475241512/BT_Printer/FW/release/升级说明.txt

合杰热敏小票打印机终端（U系列、B系列）升级方式说明：

1.终端在开机之前先将USB数据线插入电脑主机，然后按住进纸键，再开机；

2.此时打印机终端的蓝色灯会闪烁,带屏幕的版本会在屏幕上显示“UDisk Mode”的字样，电脑主机应该会提示发现新的USB设备，等待系统安装驱动；

3.驱动安装成功之后，会在系统的资源管理界面看到一个容量大约为2M的类似U盘的存储设备，将升级固件包里面的update.bin文件拷贝到终端盘符对应盘符的根目录下;

4.拷贝完成后，安全退出u盘模式，然后将打印机终端关机再开机，此时蓝灯会快速闪烁，直到蓝灯熄灭表示升级成功，带屏幕的版本会在屏幕上显示升级状态以及升级结果，然后进入正常的打印机工作状态。
