475241512/BT_Printer/资料/打印机固件升级/打印机固件升级/打印机固件升级说明书.docx

下载好升级文件之后,需要全部文件解压出来,解压出来如图所示

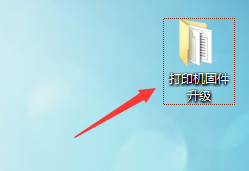
[picture p1: figure]

打开文件夹,看到所有文件,然后双击打开这个程序,认准图片即可.

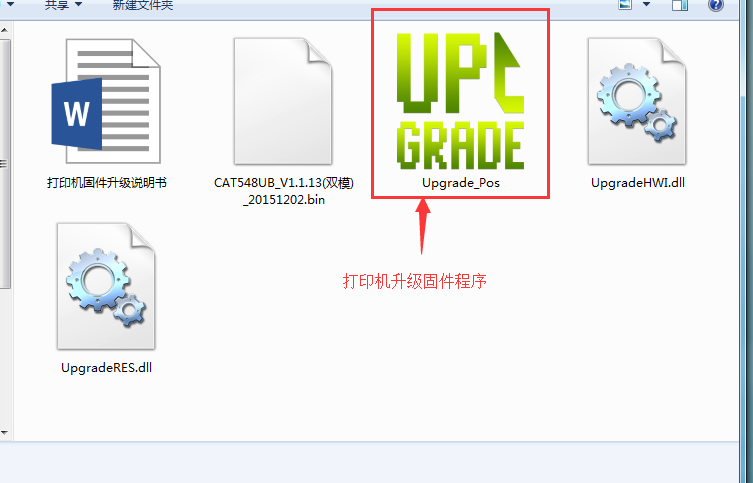
[picture p2: figure]

现在打印机连接电脑,数据线也要接上去,打印机通电开机.电脑上面在这个程序双击打开,点击升级固件程序

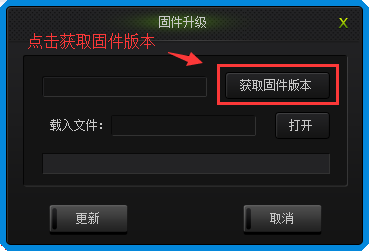
[picture p3: figure]

(获取失败的话,等一会电脑自动识别安装好驱动即可)

获取之后点击打开载入文件:

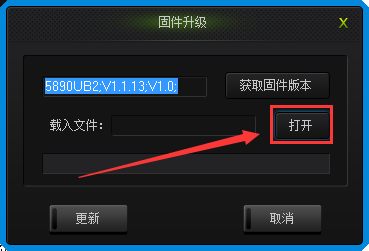
[picture p4: figure]

选择对应的升级文件.

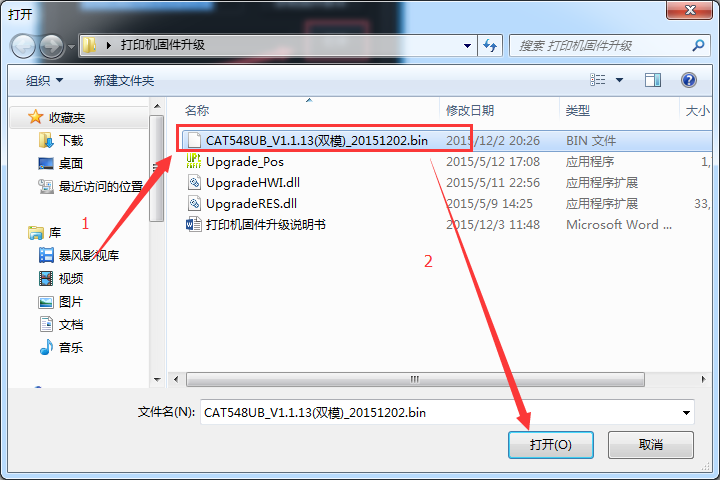
[picture p5: figure]

打开之后,直接点击跟新,程序会有读条,读条结束即可完成升级.最后还有一部很重要的,要看.

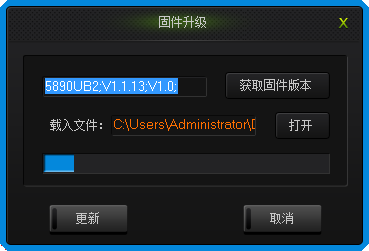
[picture p6: figure]
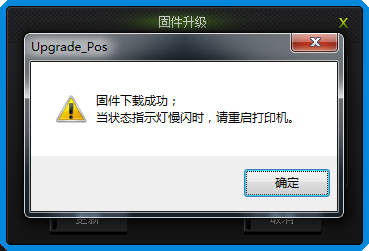
[picture p7: figure]

按照程序提示重启打印机,还需要这一步:

打印机把打印纸拿出来,盖上打印机盖子,打印机通电的情况下按住FEED键8秒,(按下去STATUS指示灯不会显示),指示灯显示了之后即可开机连接打印.
