475241512/BT_Printer/资料/蓝牙模块/FSC-BT816/固件空中升级手册3.0.pdf

# 固件升级用户手册

V3.0

# Android DFU via Bluetooth

1.确保安卓手机已安装了“蓝牙串口”软件，且为最新版本。

蓝牙串口 APK 图标，可自行到 APP 应用商店下载。

2.开启蓝牙后打开该软件，并且连接需要升级的设备

3.连接成功后发送字符串：EnterDFU （注意大小写），收到 OK 表

示模块成功进入升级模式,此时连接自动断开

注：模块只识别连接成功后的首帧数据是否为 DFU 指令，若之前有收到其他数据，则模块 不识别。

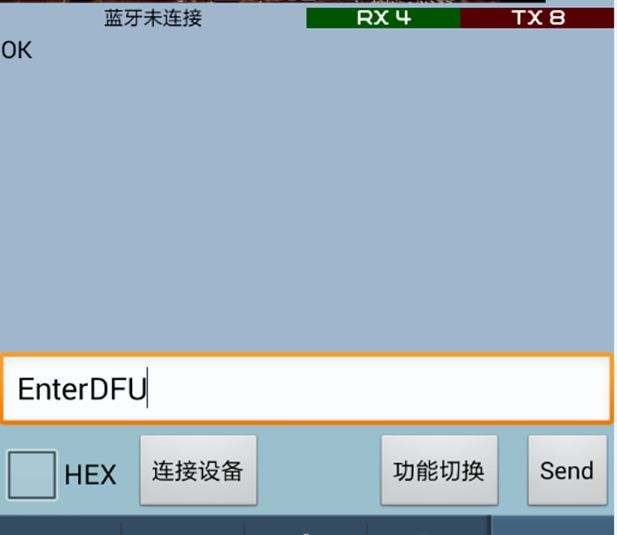
[picture p8: figure]

4.重新连接设备，此时会持续收到字符 C，表示模块等待升级文件

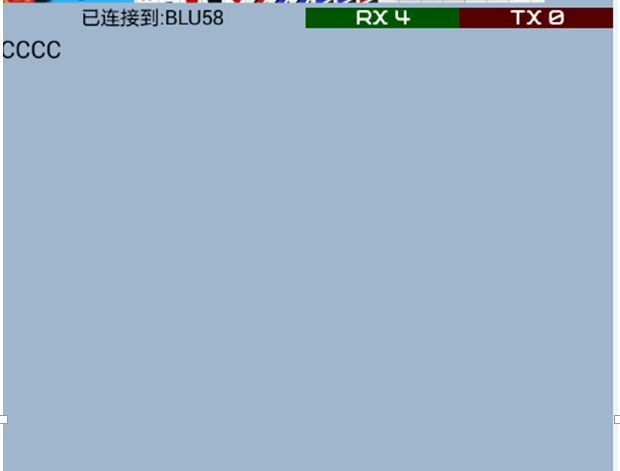
[picture p9: figure]

5.点击“功能切换”或 Menu 菜单中的“模式切换”键，切换到如下

界面

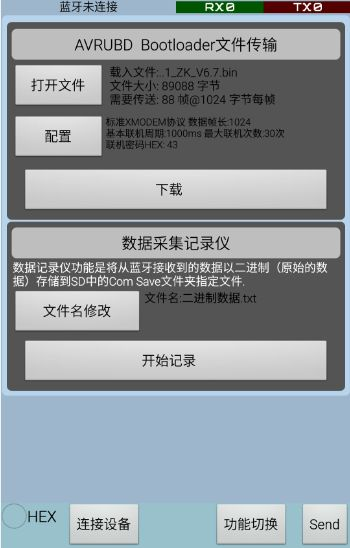
[picture p10: figure]

图 1.DFU

6.点击“打开文件”，找到存入手机的升级所用的固件*.bin

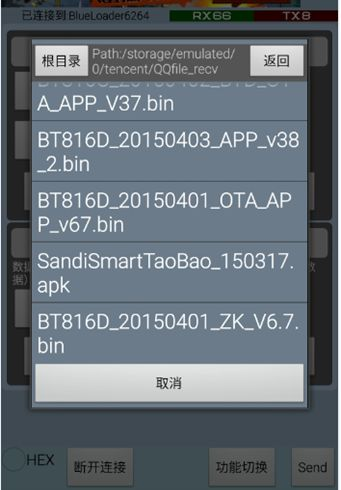
[picture p11: figure]

7.点击“配置”，配置 DFU 参数

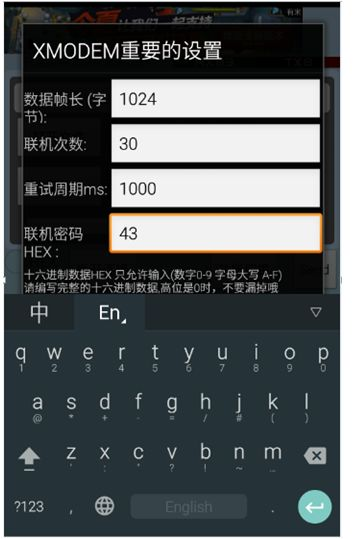
[picture p12: figure]

8.点击“下载”，开始 DFU

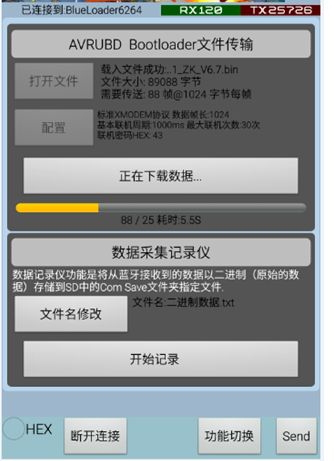
[picture p13: figure]

9.DFU 完成

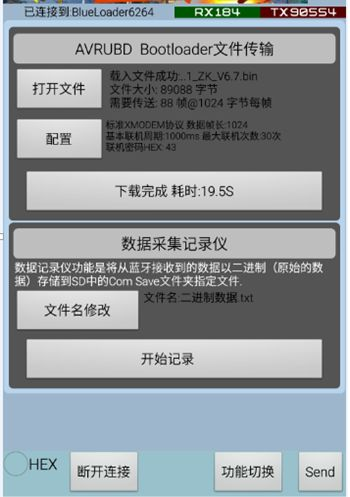
[picture p14: figure]
