475241512/BT_Printer/HW/BTPrinter_V1.20 PCBA BOM.xlsx

Part Report (BaseOption) for BTPrinter_V1.20.pcb on 2016/1/4 15:13:09
Index | Value | Decal | QTY | Name
Chips |  |  | 7
1 | AMS1117-3.3 | SOT223-JL | 1 | U4
2 | AP4435GM场效应管 SOP8 | SOP8 | 1 | U3
3 | DRV8833PWPR 电机驱动IC 16-HTSSOP | DRV8833 | 1 | U8
4 | HEM6448-01D-C-01 LCD显示屏 | HEM6448-33PIN | 1 | U5
5 | MX25L6445EM2-10G SPI FLASH | SO-8-320MIL | 1 | U22
6 | STM32F103CBT6/GD32F103CBT6 | LQFP-48 | 1 | U2
7 | TPS54331DR DC/DC电源IC 3A SOP8 | SO-8-320MIL | 1 | U1
Resisters |  |  | 40
8 | 0R | R0402 | 2 | R11 R36
9 | 1R2 | 0805 | 4 | R30 R31 R32 R33
10 | 100R | R0402 | 1 | R35
11 | 180R | R0402 | 1 | R3
12 | 330R | R0402 | 2 | R23 R46
13 | 1K | R0402 | 3 | R13 R22 R45
14 | 1.5K | R0402 | 1 | R47
15 | 3.3K | R0402 | 1 | R43
16 | 10K | R0402 | 14 | R1 R2 R6 R7 R14 R15 R25 R27 R28 R29 R34 R40 R42 R44
17 | 22K | R0402 | 1 | R5
18 | 30K | R0402 | 1 | R8
19 | 47K | R0402 | 3 | R9 R18 R24
20 | 51K | R0402 | 1 | R38
21 | 56.2K | R0402 | 1 | R39
22 | 330K | R0402 | 1 | R37
23 | 1M | R0402 | 2 | R4 R26
24 | 1K +/-1% | R0402 | 1 | R41
Capacitors |  |  | 36
25 | 20p | C0402 | 2 | C4 C8
26 | 47pF | C0402 | 1 | C38
27 | 1000pF | C0402 | 1 | C37
28 | 0.01uF | C0402 | 3 | C10 C34 C35
29 | 0.1uF | C0402 | 14 | C3 C5 C6 C7 C15 C16 C17 C18 C23 C29 C30 C33 C36 C42
30 | 1uF | C0402 | 2 | C2 C12
31 | 2.2uF | C0402 | 1 | C28
32 | 4.7uF | C0402 | 1 | C1
33 | 4.7uF | C0603 | 2 | C9 C26
34 | 10uF | C0402 | 1 | C31
35 | 10uF | C0805 | 3 | C13 C20 C32
36 | 10uF/16V | C0805 | 1 | C14
37 | 22uF/10V | C0805 | 1 | C40
38 | 电解电容25V/100uF 直径6.3MM | C_DIANJIE_6.3MM | 1 | C39
39 | 电解电容25V/470uF 直径8MM | C_DIANJIE_8MM | 1 | C11
40 | 电解电容35V/1000uF 直径10MM | C_DIANJIE_10MM | 1 | C41
Inductors |  |  | 1
41 | 6.8uH | L_DIP | 1 | L1
Diodes |  |  | 5
42 | 1N4001(SOD323) | SOD323 | 1 | D3
43 | 1N5822 DO-2144AA | DO-214AA | 1 | D2
44 | BAT54S SOT23 肖特基二极管 | SOT-23-3 | 1 | D1
Triodes |  |  | 5
45 | 2N7002 | SOT23 | 1 | Q7
46 | 3904 | SOT23 | 2 | Q2 Q9
47 | IR6402 | SOT23 | 1 | Q1
48 | TIP127(TO252) | TO252 | 1 | Q3
Crystals |  |  | 1
49 | 12MHZ 贴片晶振 | HSX321S-1 | 1 | Y1
Connectors |  |  | 5
50 | 2.0Pitch 双列直插打印头FPC座子 | 30PIN_DOUBLE_SMD | 1 | J8
51 | 2PIN电源插座 | SIP-2P | 1 | J2
52 | USB TYPEB 母座 | STANDARD_TYPEB | 1 | J3
53 | RJ12水晶头母座 | RJ12 | 1 | J5
Switchs |  |  | 2
54 | 电源开关 | POWER_KEY | 1 | S1
55 | 轻触开关 | 12_12MMKEY | 1 | S2
Unkowns |  |  | 5
56 | 蓝牙模块FSC-BT816 | WBTDS01 | 1 | BT1
Design Part Count: 103
