475241512/BT_Printer/HW/BTPrinter_V1.0_PCBA_BOM.xlsx

Part Report (BaseOption) for BTPrinter_DemoBoard_V1.00.pcb on 2015/11/10 15:04:08
Index | Value | Decal | QTY | Name
Chips |  |  | 7
1 | AMS1117-3.3 | SOT223-JL | 1 | U4
2 | AP4435GM场效应管 SOP8 | SOP8 | 1 | U3
3 | DRV8833PWPR 电机驱动IC 16-HTSSOP | DRV8833 | 1 | U8
4 | HEM6448-01D-C-01 LCD显示屏 | HEM6448-33PIN | 1 | U5
5 | MX25L6445EM2-10G SPI FLASH | SO-8-320MIL | 1 | U22
6 | STM32F103VE/VD | LQFP100 | 1 | U2
7 | TPS54331DR DC/DC电源IC 3A SOP8 | SO-8-320MIL | 1 | U1
Resisters |  |  | 38
8 | 0R | R0402 | 1 | R36
9 | 1R2 | 0805 | 4 | R30 R31 R32 R33
10 | 100R | R0402 | 1 | R35
11 | 180R | R0402 | 1 | R3
12 | 330R | R0402 | 2 | R23 R46
13 | 1K | R0402 | 2 | R22 R45
14 | 1.5K | R0402 | 1 | R47
15 | 10K | R0402 | 16 | R1 R2 R6 R7 R10 R12 R15 R19 R25 R27 R28 R29 R34 R40 R42 R43
16 | 22K | R0402 | 1 | R5
17 | 47K | R0402 | 4 | R9 R18 R24 R44
18 | 51K | R0402 | 1 | R38
19 | 56.2K | R0402 | 1 | R39
20 | 330K | R0402 | 1 | R37
21 | 1M | R0402 | 2 | R4 R26
Capacitors |  |  | 38
22 | 20p | C0402 | 2 | C4 C8
23 | 47pF | C0402 | 1 | C38
24 | 1000pF | C0402 | 1 | C37
25 | 0.01uF | C0402 | 3 | C10 C34 C35
26 | 0.1uF | C0402 | 13 | C3 C5 C6 C7 C15 C16 C17 C18 C19 C29 C30 C33 C36
27 | 1uF | C0402 | 5 | C2 C12 C22 C24 C27
28 | 2.2uF | C0402 | 1 | C28
29 | 4.7uF | C0402 | 4 | C1 C21 C23 C25
30 | 4.7uF | C0603 | 2 | C9 C26
31 | 10uF | C0402 | 1 | C31
32 | 10uF | C0805 | 3 | C13 C20 C32
33 | 10uF/16V | C0805 | 1 | C14
34 | 22uF/10V | C0805 | 1 | C40
Inductors |  |  | 1
35 | 6.8uH | L_DIP | 1 | L1
Diodes |  |  | 4
36 | 1N5822 | D0603A | 1 | D2
37 | BAT54S SOT23 肖特基二极管 | SOT-23-3 | 1 | D1
38 | 插件红色LED | LED(A/C) | 1 | LED_RED
39 | 插件蓝色LED | LED(A/C) | 1 | LED_BLUE
Triodes |  |  | 6
40 | 2N7002 | SOT23 | 1 | Q7
41 | 3904 | SOT23 | 2 | Q2 Q9
42 | IR6402 | SOT23 | 2 | Q1 Q8
43 | TP12 | TESTPOINT | 1 | Q10
Crystals |  |  | 1
44 | 12MHZ 贴片晶振 | HSX321S-1 | 1 | Y1
Connectors |  |  | 8
45 | 2.0Pitch 双列直插打印头FPC座子 | FPC-30_PITCH_1MM | 1 | J8
46 | 2.54pitch单排插针 | SIP-4P | 3 | J4 J6 J7
47 | 2.54pitch单排插针 | SIP-5P | 1 | J1
48 | 2PIN电源插座 | SIP-2P | 1 | J2
49 | RJ12水晶头母座 | RJ12 | 1 | J5
50 | USB TYPE B 母座 | STANDARD_TYPEB | 1 | J3
Switchs |  |  | 2
51 | 电源开关 | POWER_KEY | 1 | S1
52 | 轻触开关 | 12_12MMKEY | 1 | S2
Unkowns |  |  | 8
53 | 1K +/-1% | R0402 | 1 | R41
54 | 25V/100uF | C_DIANJIE | 1 | C39
55 | 25V/470uF | C_DIANJIE | 1 | C11
56 | 25V/1000uF | C_DIANJIE | 1 | C41
57 | 蓝牙模块FSC-BT816 | WBTDS01 | 4 | BT1 BT2 BT3 BT4
Design Part Count: 113
