475241512/BT_Printer/结构/outline1.dxf

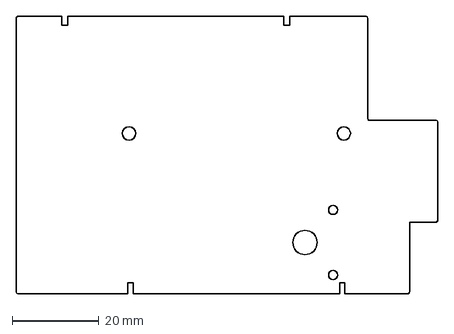
[picture p15: CAD file, 2015-12-18]
结构/outline1.dxf
97.2 x 64.0 mm
