475241512/BT_Printer/结构/POS58主板板框图-151106/layout.dxf

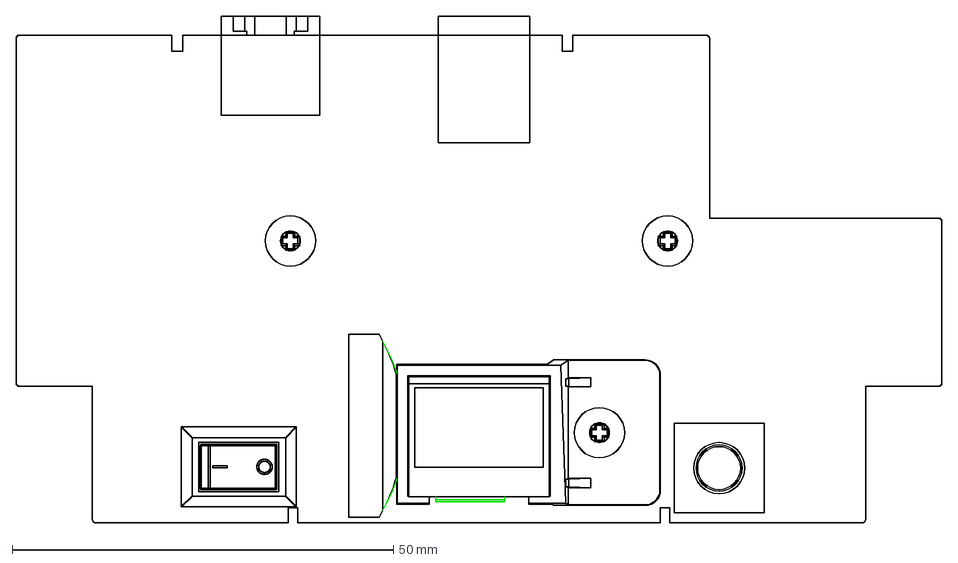
[picture p17: CAD file, 2015-12-14]
结构/POS58主板板框图-151106/layout.dxf
121.5 x 66.5 mm
