475241512/BT_Printer/(list of files, cad)

Other CAD files:
结构/POS58主板板框图-151106/POS58-main-board-A-151106.dwg
结构/POS58-printer-main-board-151215.dwg
结构/POS58主板板框图-151106/POS58-main-board-B-151106.dwg
结构/POS58主板板框图-151106/POS58-main-board-151106.dwg
结构/小票打印机-主板初步板框图-151009.dwg
结构/POS58主板板框图-151106/layout.dwg
