475241512/BT_Printer/资料/NUC123_USB_Printer_V1.01.00/NUC123_USB_Printer_V1.01.00/Printer 驱动和字库等资料/烧录字库使用说明.txt

 按以下步骤，把汉字库烧录到 SPI FLASH中，供NUC123读取。

一,NUC123中烧录代码 Writing_HZK.bin。

二,电脑上打开工具软件 Writing_HZK.exe，板子串口连上电脑。

三,按操作步骤,先打开16X16字库,点"开始"下载字库到 SPI SLASH,再打开24X24字库,点"开始"。

  以上步骤完成字库下载到 SPI FLASH, NUC123再烧录打印机的代码。就可以打印出汉字了。
