475241512/BT_Printer/资料/打印机固件升级/打印机固件升级/BT_Printer_enum.txt

Bus Hound 5.00 capture. Complements of www.perisoft.net

  Device - Device ID (followed by the endpoint for USB devices)
            (16) USB Composite Device
            (17) USB 打印支持
            (18) USB 输入设备
            (19) 没有连接打印机
            (20) HID-compliant device
  Phase  - Phase Type
            CTL   USB control transfer       
            DI    Data in                    
            DO    Data out                   
            USTS  USB status                 
  Data   - Hex dump of the data transferred
  Descr  - Description of the phase
  Cmd... - Position in the captured data

Device  Phase  Data                                                                                                    Description       Cmd.Phase.Ofs(rep)
------  -----  ------------------------------------------------------------------------------------------------------  ----------------  ------------------
  17.0  CTL    00 09 00 00  00 00 00 00                                                                                SET CONFIG               1.1.0        
  16.0  CTL    80 06 00 01  00 00 12 00                                                                                GET DESCRIPTOR           2.1.0        
  16.0  DI     12 01 00 02  00 00 00 40  00 b0 11 04  00 02 01 02  00 01                                               .......@........         2.2.0        
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
  17.0  USTS   00 00 01 c0                                                                                             canceled                13.2.0
