475241512/BT_Printer/资料/打印机固件升级/打印机固件升级/BT_Printer_Upgrade.txt

Bus Hound 5.00 capture. Complements of www.perisoft.net

  Device - Device ID (followed by the endpoint for USB devices)
            (19) 没有连接打印机
            (20) HID-compliant device
  Phase  - Phase Type
            DI    Data in                    
            DO    Data out                   
  Data   - Hex dump of the data transferred
  Descr  - Description of the phase
  Cmd... - Position in the captured data

Device  Phase  Data                                                                                                    Description       Cmd.Phase.Ofs(rep)
------  -----  ------------------------------------------------------------------------------------------------------  ----------------  ------------------
  20    DO     00 00 f9 00  00 00 00 00  00 00 00 00  00 00 00 00  00 00 00 00  00 00 00 00  00 00 00 00  00 00 00 00  ................         1.1.0        
               00 00 00 00  00 00 00 00  00 00 00 00  00 00 00 00  00 00 00 00  00 00 00 00  00 00 00 00  00 00 00 00  ................         1.1.32       
               00                                                                                                      .                        1.1.64       
  20    DI     00 00 f9 35  38 39 30 55  42 34 3b 56  32 2e 32 2e  36 3b 56 31  2e 31 3b 00  00 00 00 00  00 00 00 00  ...5890UB4;V2.2.         2.1.0        
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
               00                                                                                                      .                      821.1.64
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
