475241512/BT_Printer/结构/POS58-printer-main-board-151215.pdf

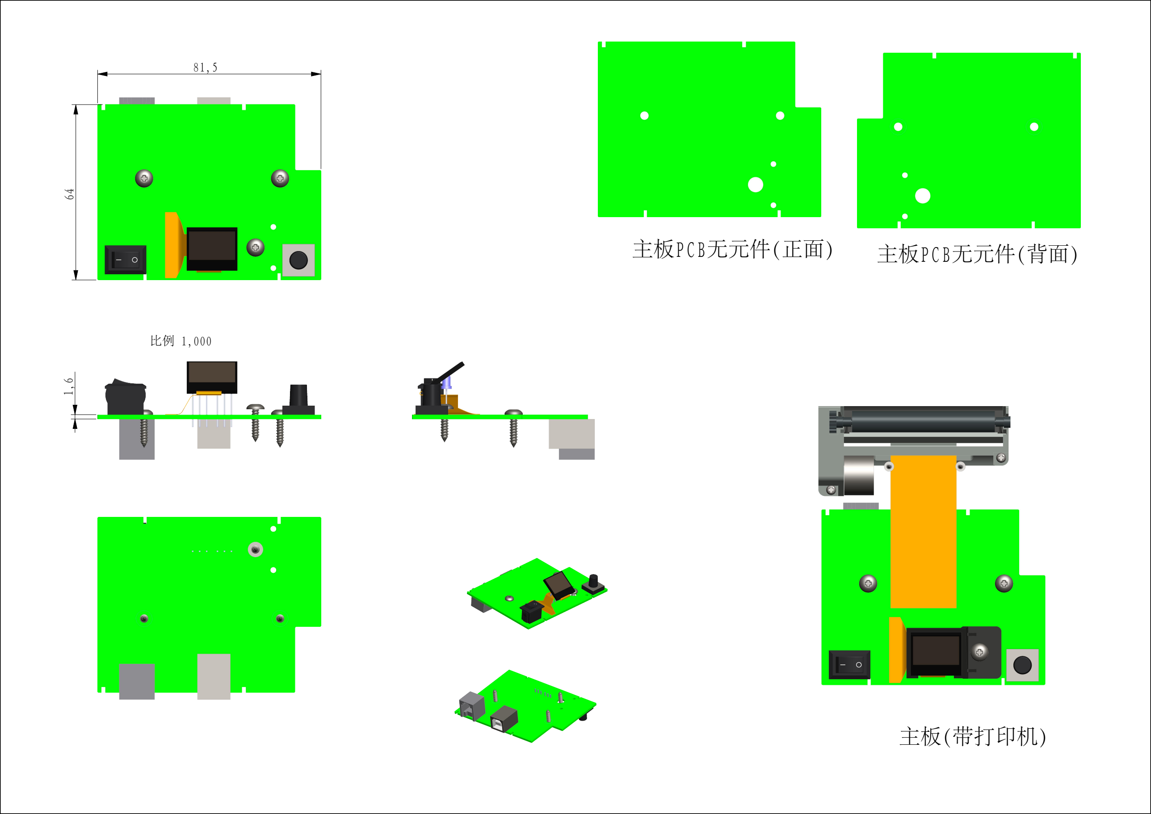
[picture p23: page 1]

81,5

64 1,6

主板PCB无元件(正面)

主板(带打印机)

主板PCB无元件(背面)

比例 1,000
