475241512/BT_Printer/资料/NUC123_USB_Printer_V1.01.00/NUC123_USB_Printer_V1.01.00/Printer 驱动和字库等资料/nuc123_lqfp64 micro-printer 58m.pdf

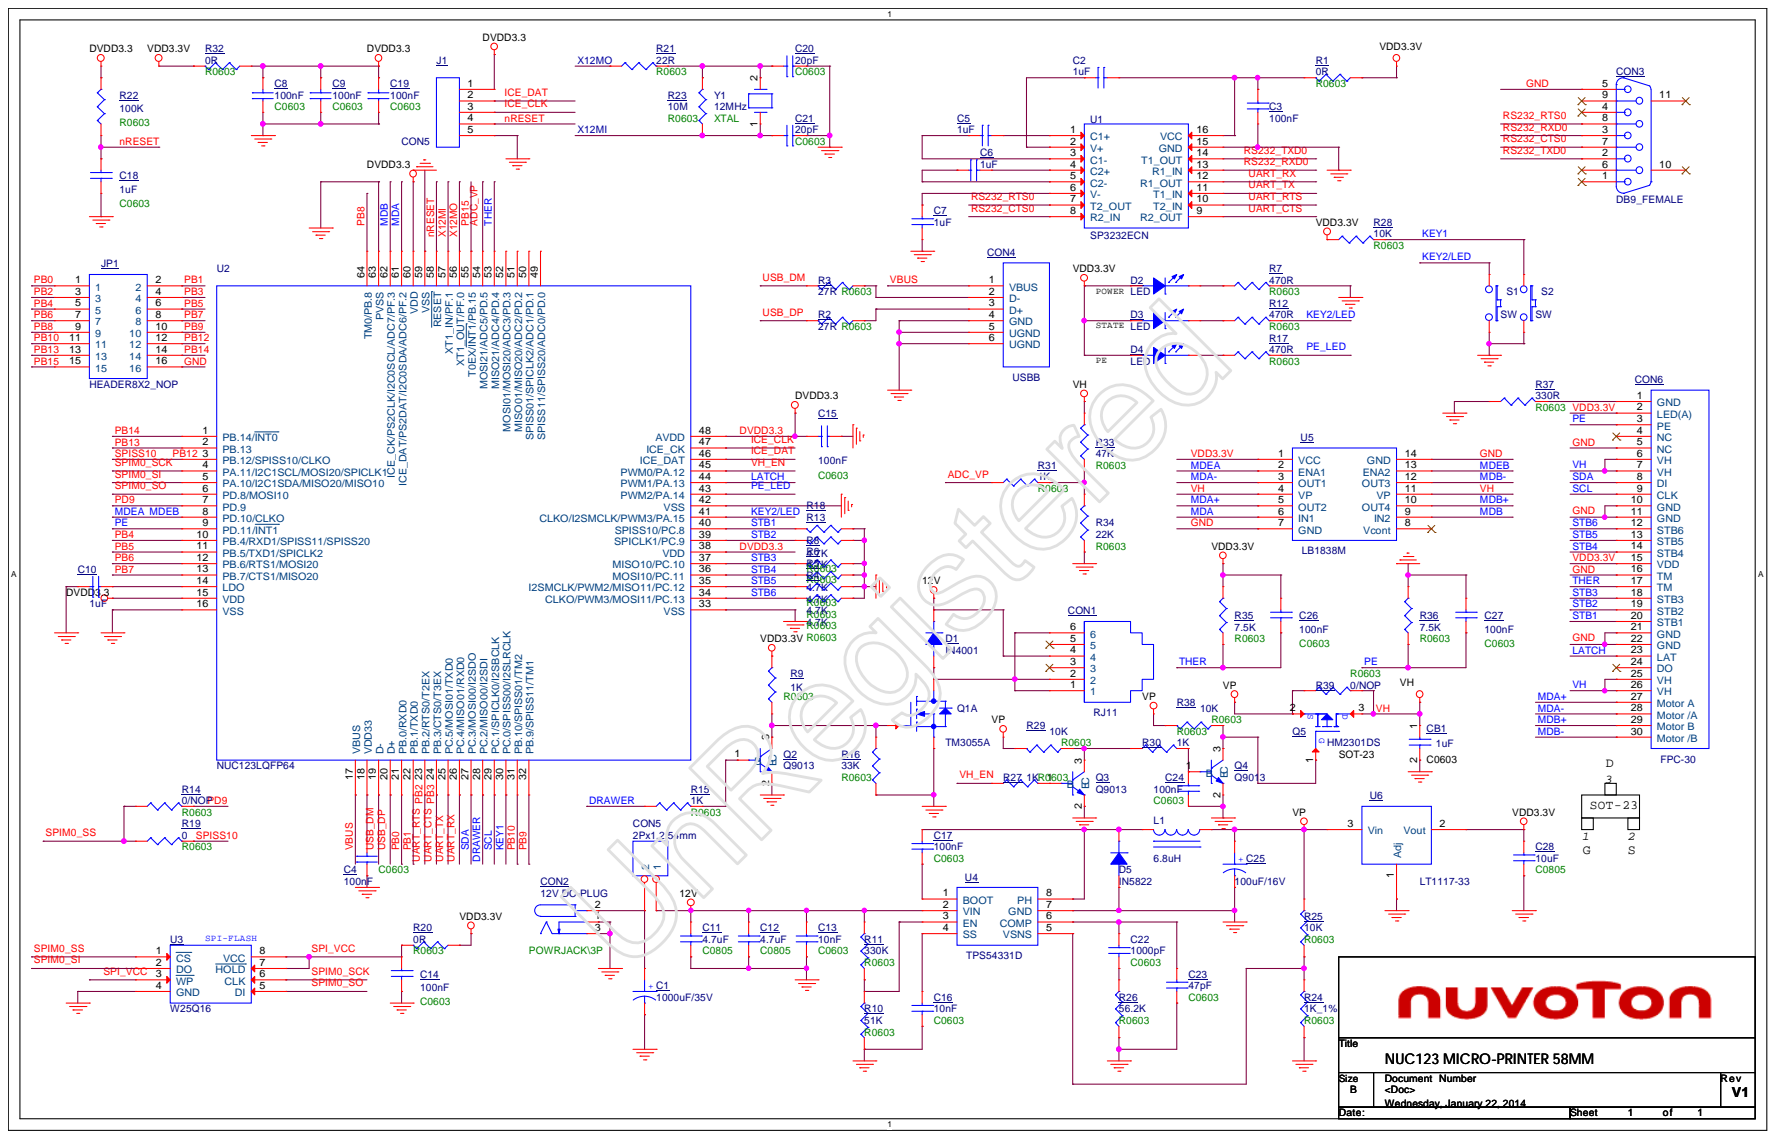
[picture p24: page 1]

ICE_DAT/PS2DAT/I2C0SDA/ADC6/PF.2 61 ICE_CK/PS2CLK/I2C0SCL/ADC7/PF.3 62 PVSS 63 TM0/PB.8 64

SPISS11/SPISS20/ADC0/PD.0 49 SPISS01/SPICLK2/ADC1/PD.1 50 MISO01/MISO20/ADC2/PD.2 51 MOSI01/MOSI20/ADC3/PD.3 52 MISO21/ADC4/PD.4 53 MOSI21/ADC5/PD.5 54 T0EX/INT1/PB.15 55 XT1_OUT/PF.0 56 XT1_IN/PF.1 57

Size Size Size B B B | Document Number Document Number Document Number <Doc> <Doc> <Doc> | Rev Rev Rev V1 V1 V1

Date: Date: Date: | Sheet Sheet Sheet of of of
