475241512/BT_Printer/资料/LCD资料/HEM6448-01B-C-02 Model (1).pdf

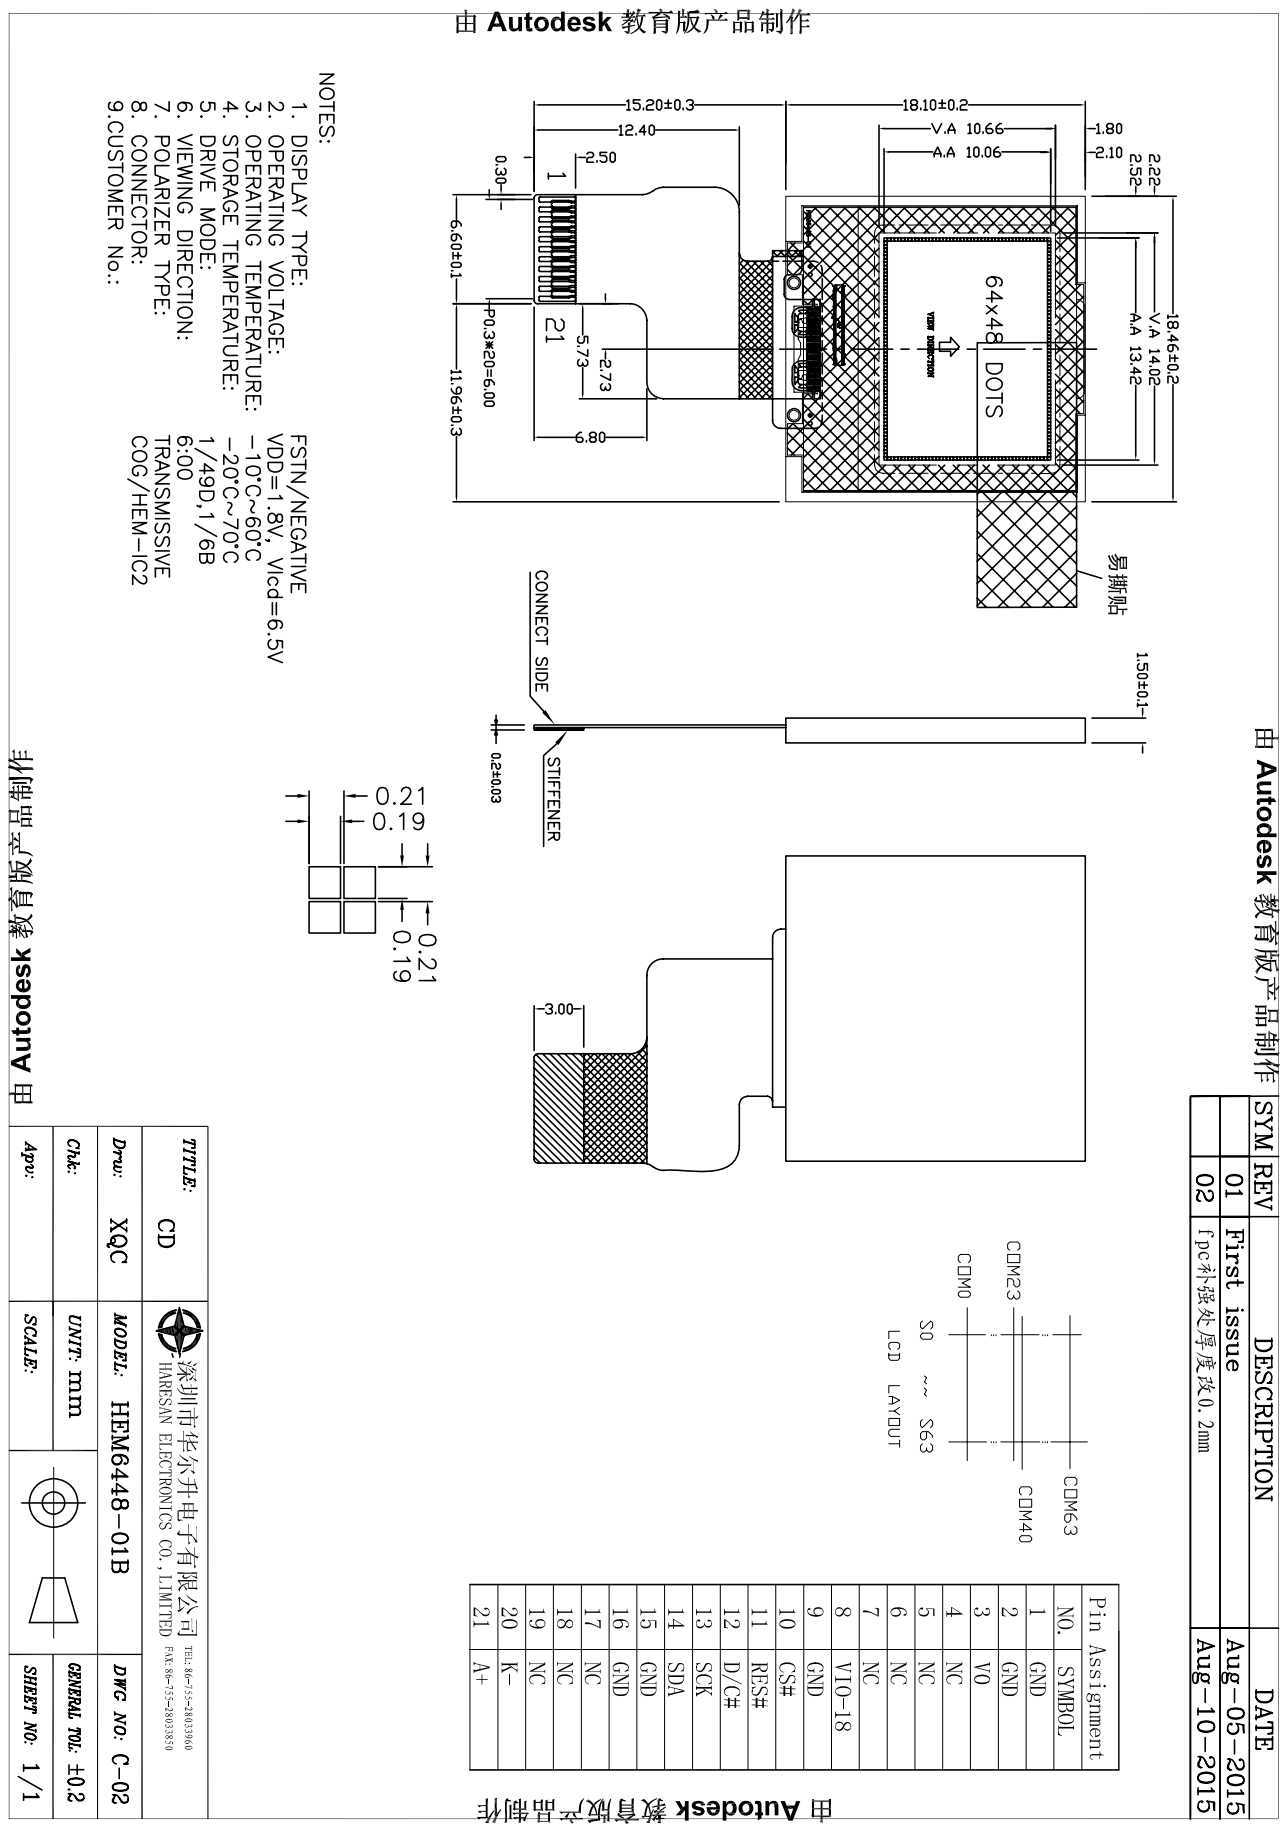
[picture p25: page 1]
