475241512/BT_Printer/资料/LCD资料/HEM6448-01D-C-01.pdf

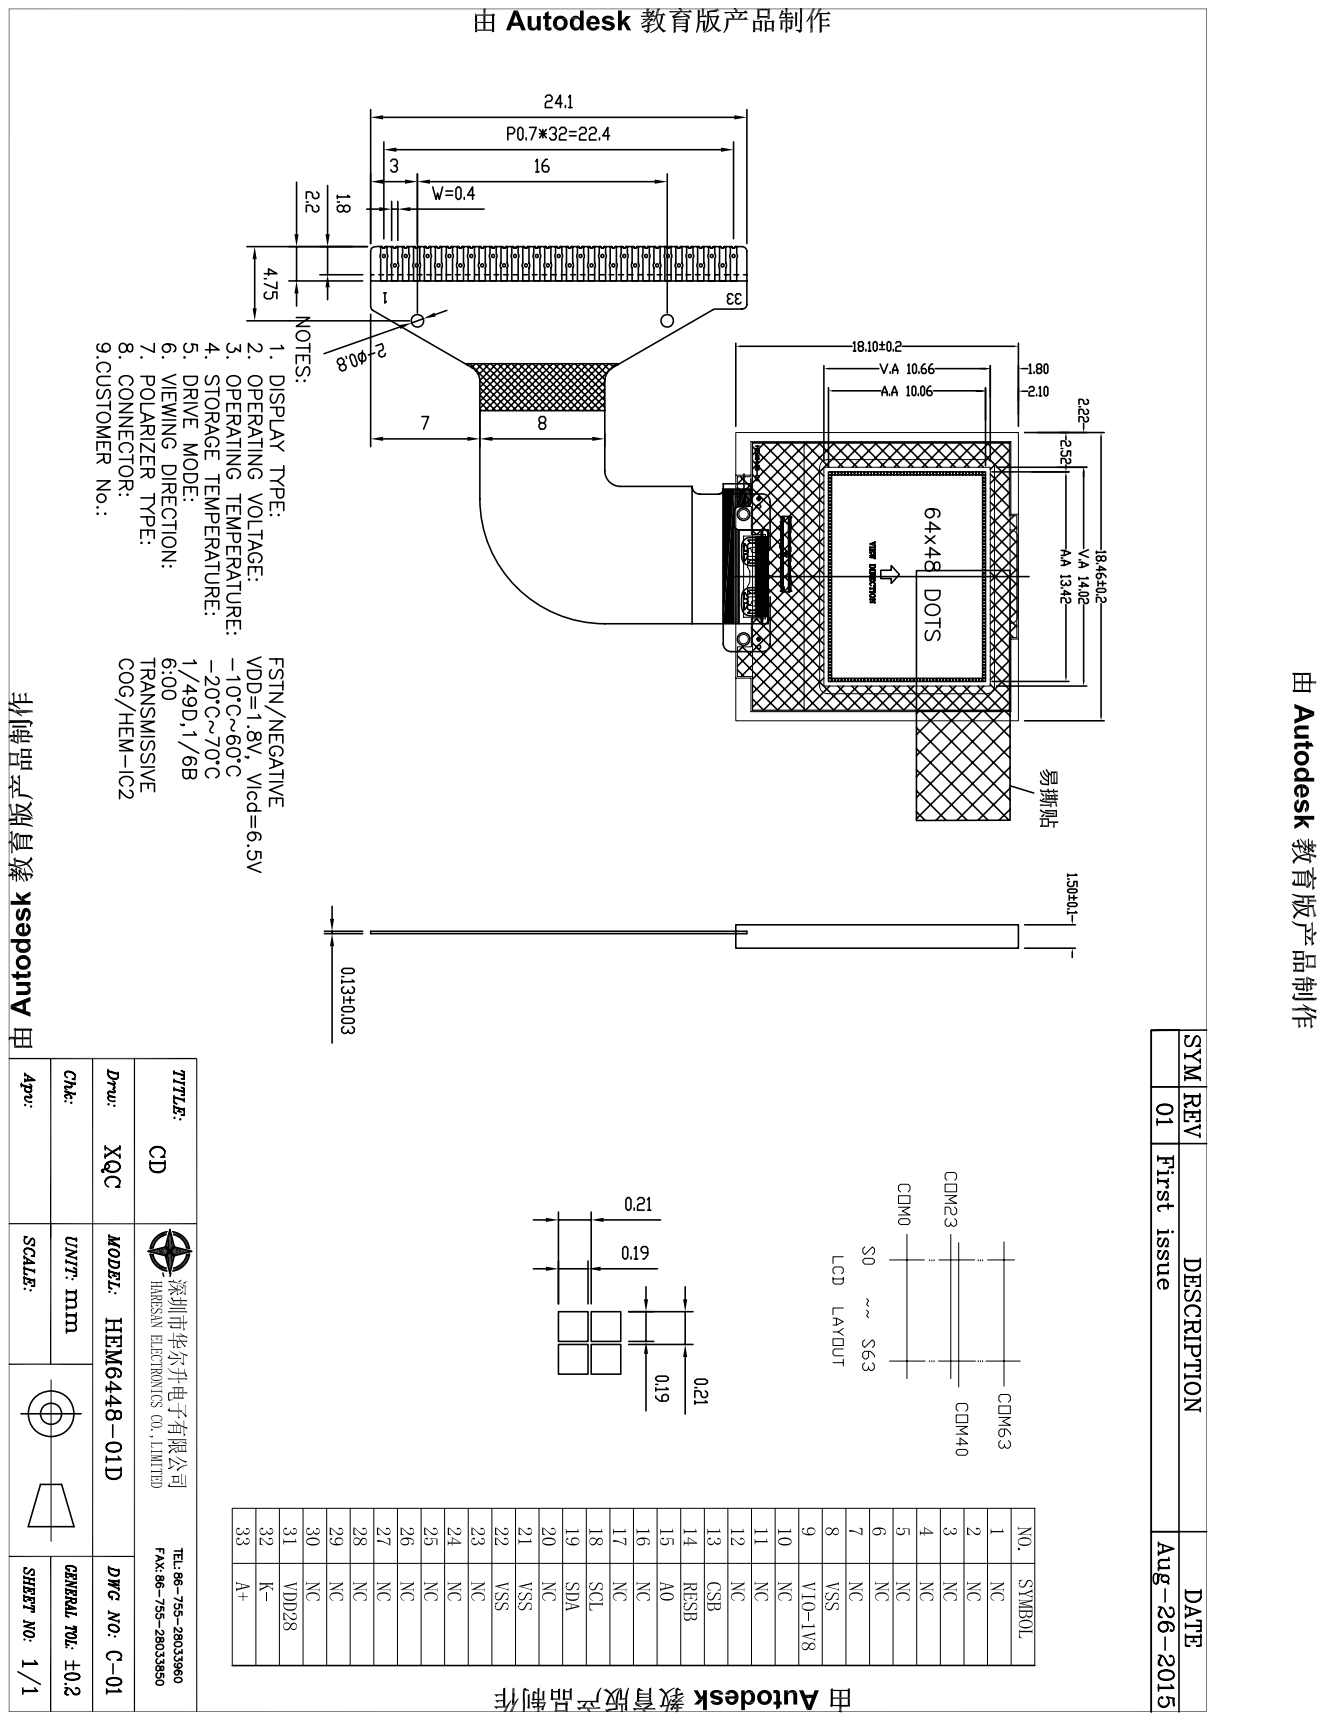
[picture p26: page 1]
