475241512/BT_Printer/资料/srcPT48x/sch/prt486mb2.pdf

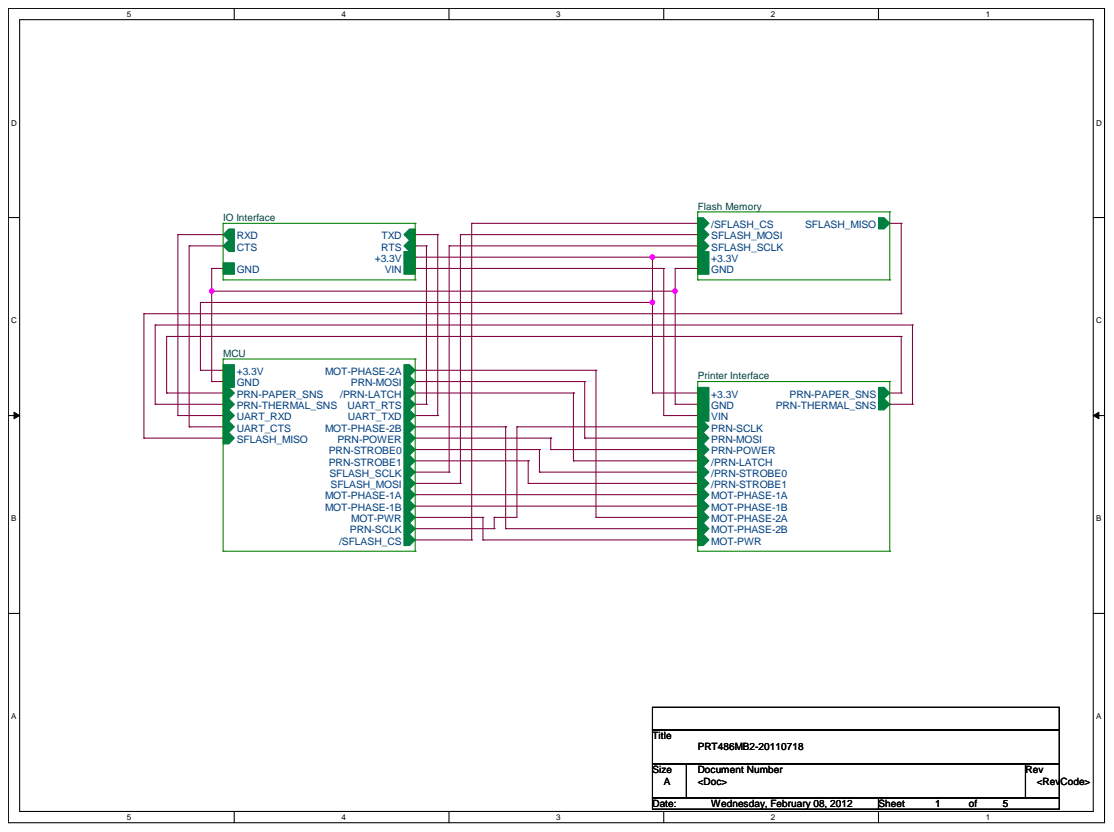
[picture p27: page 1]

Size Size Size A A A | Document Number Document Number Document Number | Rev Rev Rev

Date: Wednesday, February 08, 2012 Wednesday, February 08, 2012 Wednesday, February 08, 2012 | Sheet 1 1 1 of 5 5 5

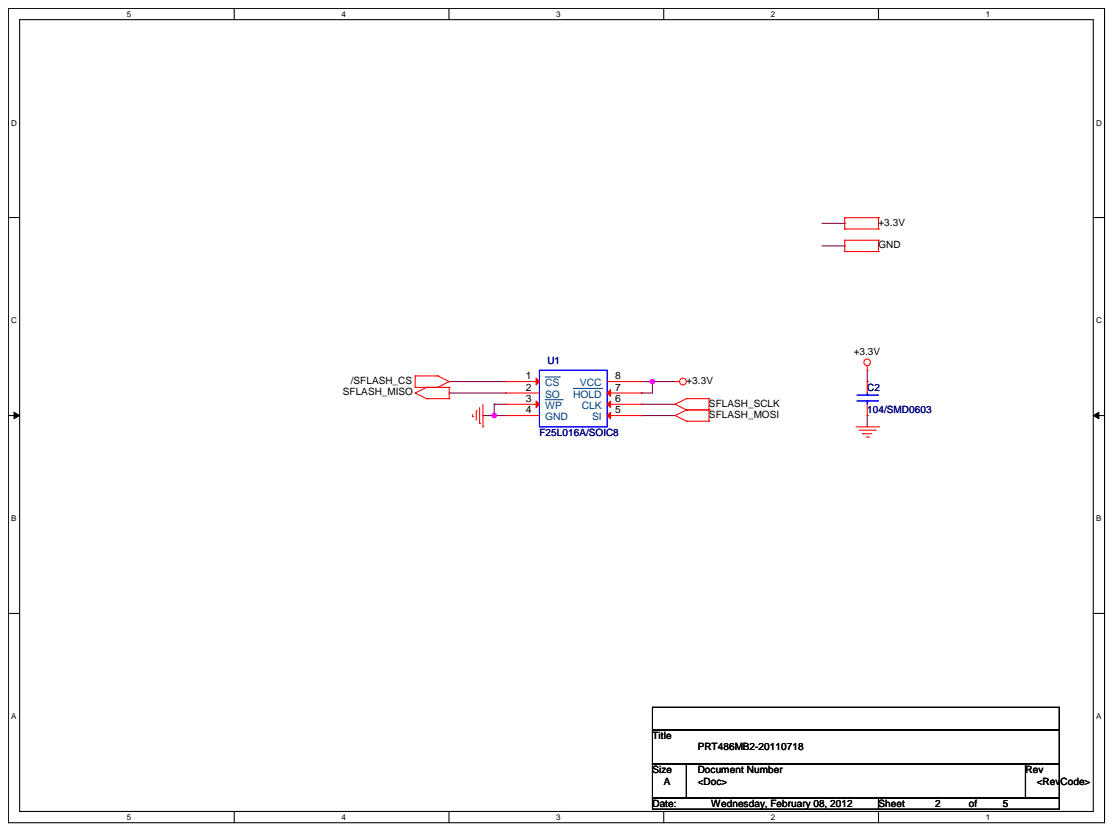
[picture p28: page 2]

Size Size Size A A A | Document Number Document Number Document Number | Rev Rev Rev

Wednesday, February 08, 2012 Wednesday, February 08, 2012 Wednesday, February 08, 2012 | 2 2 2 5 5 5

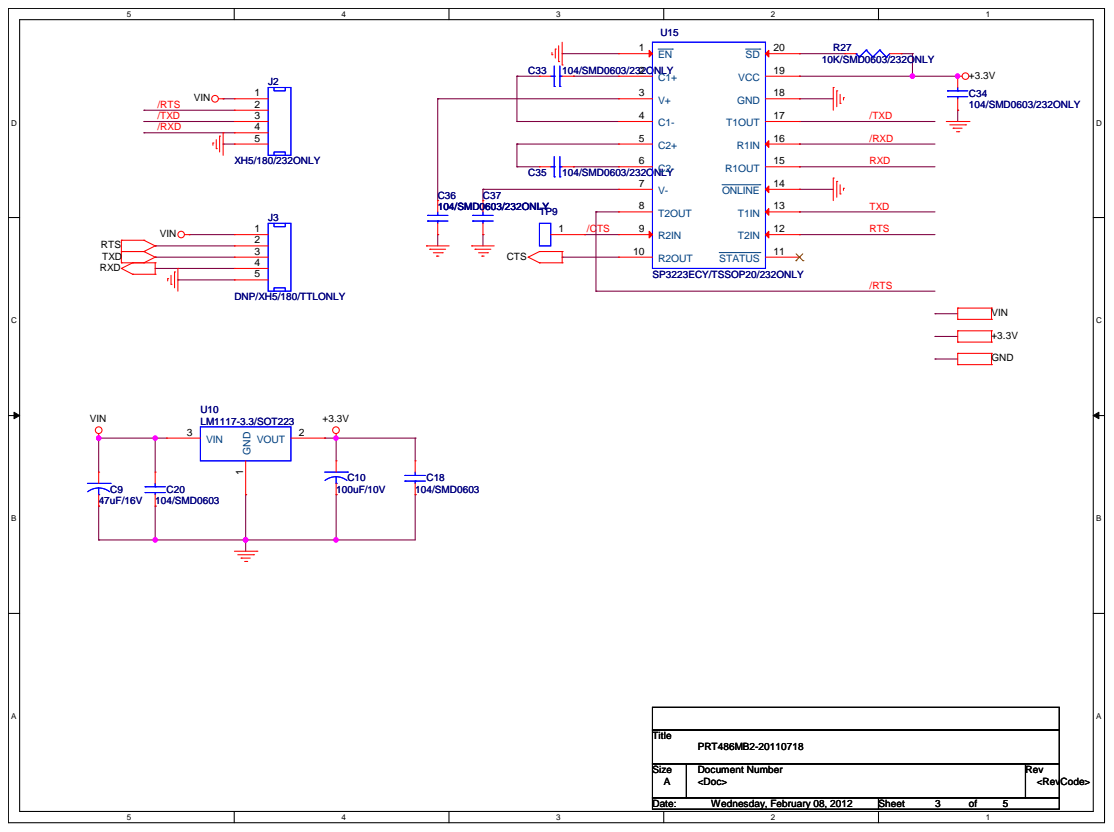
[picture p29: page 3]

Size Size Size A A A | Document Number Document Number Document Number | Rev Rev Rev

Wednesday, February 08, 2012 Wednesday, February 08, 2012 Wednesday, February 08, 2012 | 3 3 3 5 5 5

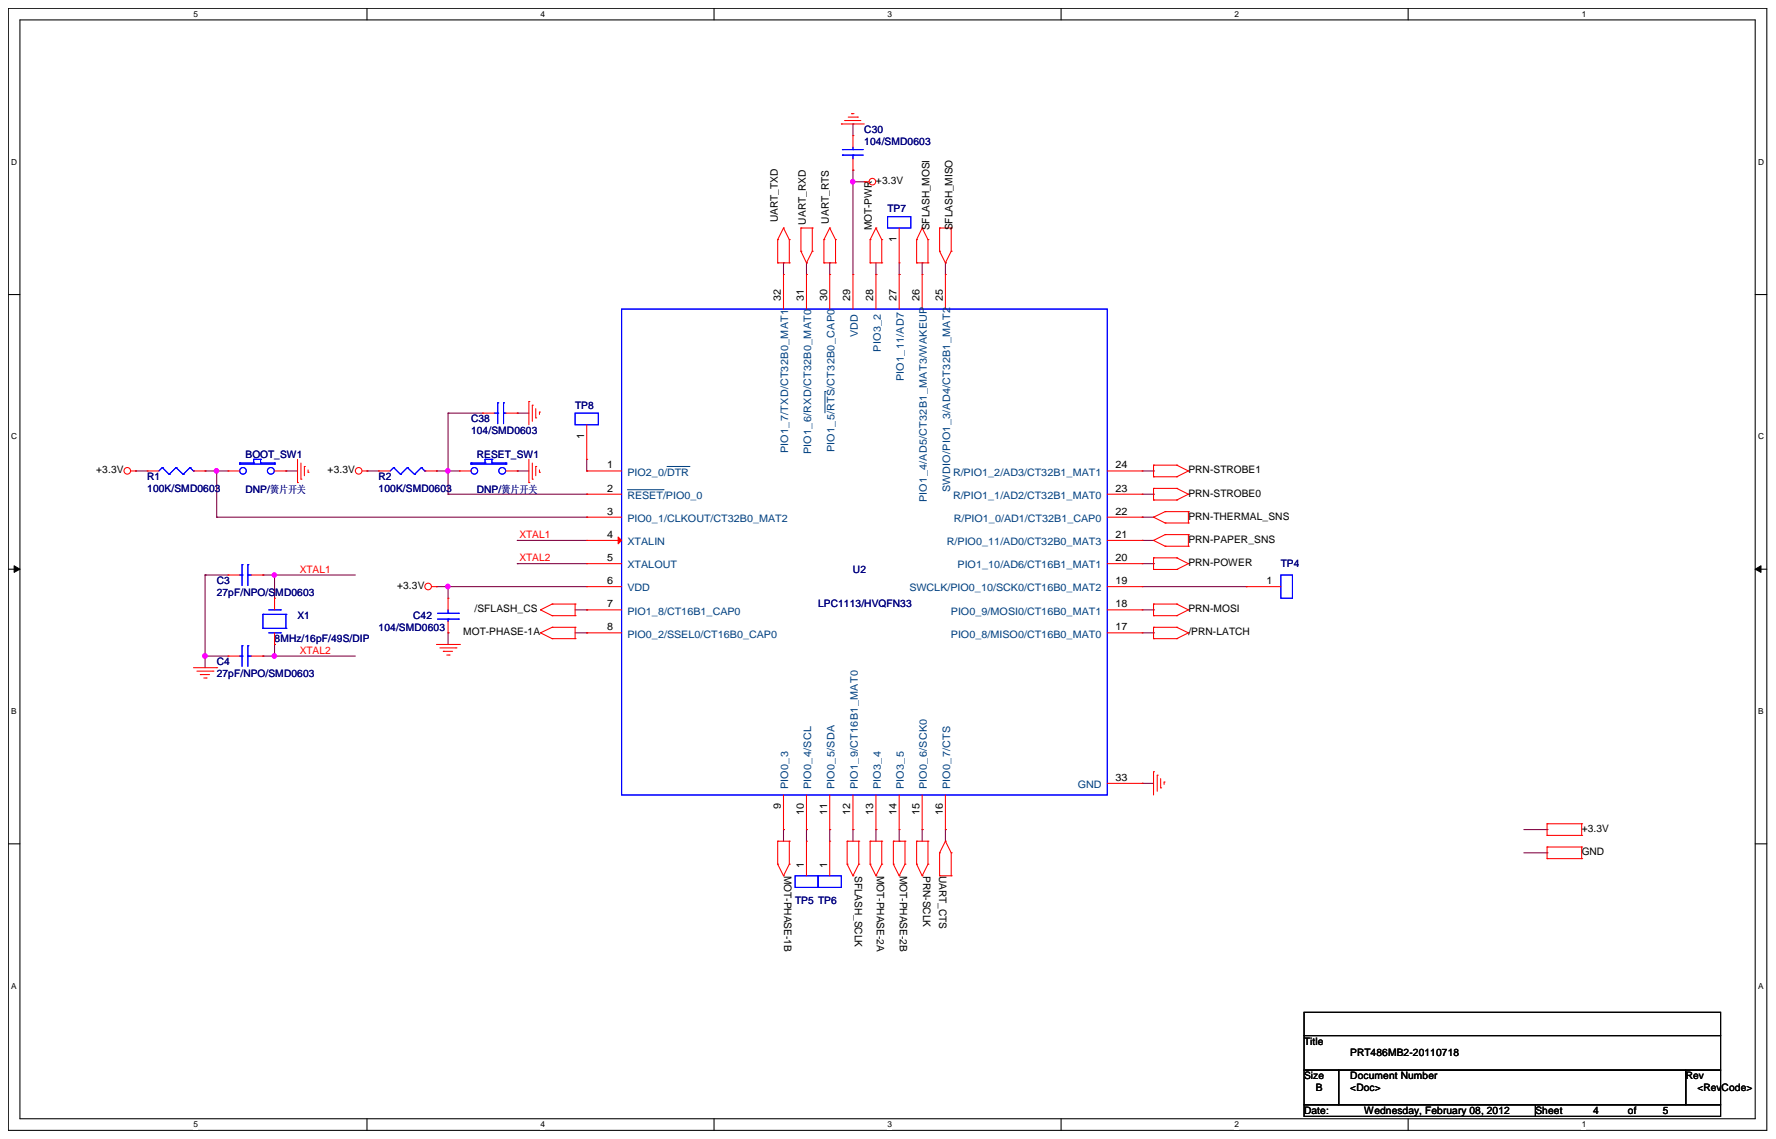
[picture p30: page 4]

Size Size Size B B B | Document Number Document Number Document Number | Rev Rev Rev

Date: Date: Date: Wednesday, February 08, 2012 Wednesday, February 08, 2012 Wednesday, February 08, 2012 | Sheet Sheet Sheet 4 4 4 of of of 5 5 5

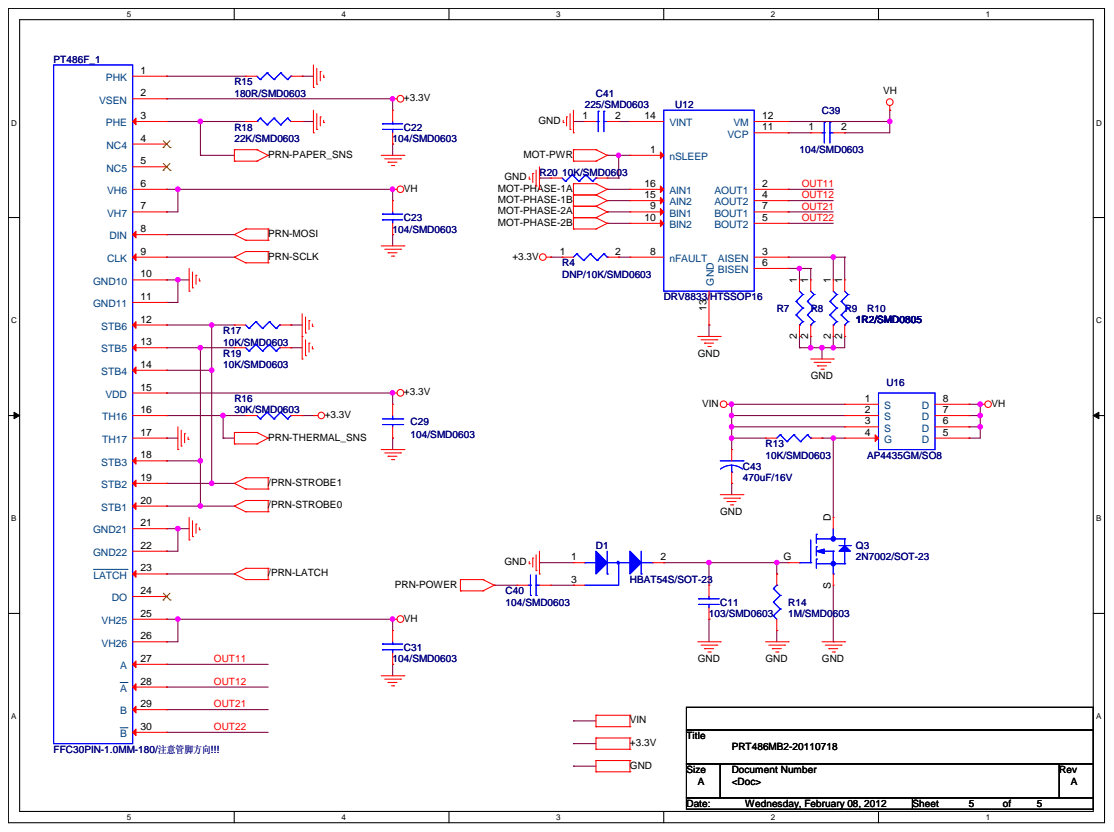
[picture p31: page 5]

Size Size Size A A A | Document Number Document Number Document Number <Doc> <Doc> <Doc> | Rev Rev Rev A A A

Wednesday, February 08, 2012 Wednesday, February 08, 2012 Wednesday, February 08, 2012 | 5 5 5
