475241512/BT_Printer/(list of files, drawings)

Other design files:
HW/BTPrinter_DemoBoard_V1.00.pcb
HW/BTPrinter_DemoBoard_V1.10.pcb
HW/BTPrinter_V1.10.pcb
HW/BTPrinter_V1.20.pcb
HW/Layou1.pcb
HW/Layou2.pcb
HW/Layou3.pcb
HW/layout00.pcb
HW/Layout.pcb
