475241512/BT_Printer/资料/NUC123_USB_Printer_V1.01.00/NUC123_USB_Printer_V1.01.00/Nu_Link_Driver.ini

[Version]
Nu_LinkVersion=V3.3
[Process]
ProcessID=0x00000de0
ProcessCreationTime_L=0x7347a036
ProcessCreationTime_H=0x01cfe6d2
NuLinkID=0x7788c0ca
NuLinkID0=0x7788c0ca
NuLinkIDs_Count=0x00000001
[ChipSelect]
;ChipName=<NUC1xx|NUC2xx|M05x|N572|Nano100|N512|Mini51|General>
ChipName=NUC1xx
[NUC1xx]
Reset=Autodetect
MaxClock=1MHz
MemoryVerify=1
IOVoltage=3300
FlashSelect=APROM with IAP
Erase=1
Program=1
Verify=1
ResetAndRun=1
EnableFlashBreakpoint=1
RAMForAlgorithmStart=0x20000000
RAMForAlgorithmSize=0x1000
ProgramAlgorithm=NUC100_AP_64.FLM
EnableLog=0
[NUC2xx]
Reset=Autodetect
MaxClock=1MHz
MemoryVerify=1
IOVoltage=3300
FlashSelect=APROM
Erase=1
Program=1
Verify=1
ResetAndRun=0
EnableFlashBreakpoint=1
RAMForAlgorithmStart=0x20000000
RAMForAlgorithmSize=0x1000
ProgramAlgorithm=NUC200_AP_128.FLM
EnableLog=0
[N572]
Reset=Autodetect
MaxClock=1MHz
MemoryVerify=1
IOVoltage=3300
Erase=1
Program=1
Verify=1
ResetAndRun=0
EnableFlashBreakpoint=1
RAMForAlgorithmStart=0x20000000
RAMForAlgorithmSize=0x2000
ProgramAlgorithm=N572F064.FLM
EnableLog=0
[M05x]
Reset=Autodetect
MaxClock=1MHz
MemoryVerify=1
IOVoltage=3300
FlashSelect=APROM
Erase=1
Program=1
Verify=1
ResetAndRun=0
EnableFlashBreakpoint=1
RAMForAlgorithmStart=0x20000000
RAMForAlgorithmSize=0x800
ProgramAlgorithm=M0516_AP_64.FLM 
EnableLog=0
[Nano100]
Reset=Autodetect
MaxClock=1MHz
MemoryVerify=1
IOVoltage=3300
FlashSelect=APROM(LDROM visible)
Erase=1
Program=1
Verify=1
ResetAndRun=1
EnableFlashBreakpoint=1
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
ProgramAlgorithm=NM1200_AP_8.FLM
[M0518]
Reset=Autodetect
MaxClock=1MHz
MemoryVerify=1
IOVoltage=3300
FlashSelect=APROM
Erase=1
Program=1
Verify=1
ResetAndRun=0
EnableFlashBreakpoint=1
EnableLog=0
RAMForAlgorithmStart=0x20000000
RAMForAlgorithmSize=0x1000
ProgramAlgorithm=M0518_AP_64.FLM
