475241512/BT_Printer/资料/NUC123_USB_Printer_V1.01.00/NUC123_USB_Printer_V1.01.00/LIB_Include/NUC123Series.h

/*---------------------------------------------------------------------------------------------------------*/
/*                                                                                                         */
/* Copyright (c) Nuvoton Technology Corp. All rights reserved.                                             */
/*                                                                                                         */
/*---------------------------------------------------------------------------------------------------------*/

#ifndef __NUC123Series_H__
#define __NUC123Series_H__

              
/**
 * ==========================================================================
 * ---------- Interrupt Number Definition -----------------------------------
 * ==========================================================================
 */
 
typedef enum IRQn
{
/******  Cortex-M0 Processor Exceptions Numbers ***************************************************/
  NonMaskableInt_IRQn         = -14,    /*!< 2 Non Maskable Interrupt                             */
  HardFault_IRQn              = -13,    /*!< 3 Cortex-M0 Hard Fault Interrupt                     */
  SVCall_IRQn                 = -5,     /*!< 11 Cortex-M0 SV Call Interrupt                       */
  PendSV_IRQn                 = -2,     /*!< 14 Cortex-M0 Pend SV Interrupt                       */
  SysTick_IRQn                = -1,     /*!< 15 Cortex-M0 System Tick Interrupt                   */

/******  ARMIKMCU Swift specific Interrupt Numbers ************************************************/
  BOD_IRQn                  = 0,        /*!< Brown-Out Low Voltage Detected Interrupt             */ 
  WDT_IRQn                  = 1,        /*!< Watch Dog Timer Interrupt                            */
  EINT0_IRQn                = 2,        /*!< EINT0 Interrupt                                      */
  EINT1_IRQn                = 3,        /*!< EINT1 Interrupt                                      */
  GPAB_IRQn                 = 4,        /*!< GPIO_PA/PB Interrupt                                 */
  GPCDF_IRQn                = 5,        /*!< GPIO_PC/PD/PE/PF Interrupt                           */
  PWMA_IRQn                 = 6,        /*!< PWMA Interrupt                                       */
  TMR0_IRQn                 = 8,        /*!< TIMER0 Interrupt                                     */
  TMR1_IRQn                 = 9,        /*!< TIMER1 Interrupt                                     */
  TMR2_IRQn                 = 10,       /*!< TIMER2 Interrupt                                     */
  TMR3_IRQn                 = 11,       /*!< TIMER3 Interrupt                                     */
  UART0_IRQn                = 12,       /*!< UART0 Interrupt                                      */
  UART1_IRQn                = 13,       /*!< UART1 Interrupt                                      */
  SPI0_IRQn                 = 14,       /*!< SPI0 Interrupt                                       */
  SPI1_IRQn                 = 15,       /*!< SPI1 Interrupt                                       */
  SPI2_IRQn                 = 16,       /*!< SPI2 Interrupt                                       */
  I2C0_IRQn                 = 18,       /*!< I2C0 Interrupt                                       */
  I2C1_IRQn                 = 19,       /*!< I2C1 Interrupt                                       */
  USBD_IRQn                 = 23,       /*!< USB device Interrupt                                 */
  PS2_IRQn                  = 24,       /*!< PS/2 device Interrupt                                */
  PDMA_IRQn                 = 26,       /*!< PDMA Interrupt                                       */
  I2S_IRQn                  = 27,       /*!< I2S Interrupt                                        */
  PWRWU_IRQn                = 28,       /*!< Power Down Wake Up Interrupt                         */
  ADC_IRQn                  = 29,       /*!< ADC Interrupt                                        */
} IRQn_Type;


/**
 * ==========================================================================
 * ----------- Processor and Core Peripheral Section ------------------------
 * ==========================================================================
 */

/* Configuration of the Cortex-M0 Processor and Core Peripherals */
#define __MPU_PRESENT           0       /*!< armikcmu does not provide a MPU present or not       */
#define __NVIC_PRIO_BITS        2       /*!< armikcmu Supports 2 Bits for the Priority Levels     */
#define __Vendor_SysTickConfig  0       /*!< Set to 1 if different SysTick Config is used         */


#include "core_cm0.h"                   /* Cortex-M0 processor and core peripherals               */
//#include "system_NUC123Series.h"        /* NUC123 System                                          */

#if defined ( __CC_ARM   )
#pragma anon_unions
#endif

/******************************************************************************/
/*                Device Specific Peripheral registers structures             */
/******************************************************************************/

/** @addtogroup NUC123_SERIES_REG NUC123 Series Registers
 @{             
*/

/*--------------------- General Purpose I/O (GPIO) ---------------------*/
/** @addtogroup NUC123_GPIO NUC123 GPIO
  Memory Mapped Structure for NUC123 Series General Purpose I/O
  @{
 */
typedef struct
{
    /**
     * PMD
     * ===================================================================================================
     * Offset: 0x00  GPIO Port [A/B/C/D/E/F] I/O Mode Control
     * ---------------------------------------------------------------------------------------------------
     */    
    __IO uint32_t  PMD;                         

    /**
     * OFFD
     * ===================================================================================================
     * Offset: 0x04  GPIO Port [A/B/C/D/E/F] Pin Digital Input Path Disable Control
     * ---------------------------------------------------------------------------------------------------
     */    
    __IO uint32_t  OFFD;                        

    /**
     * DOUT
     * ===================================================================================================
     * Offset: 0x08  GPIO Port [A/B/C/D/E/F] Data Output Value
     * ---------------------------------------------------------------------------------------------------
     */    
    __IO uint32_t  DOUT;                        

    /**
     * DMASK
     * ===================================================================================================
     * Offset: 0x0C  GPIO Port [A/B/C/D/E/F] Data Output Write Mask
     * ---------------------------------------------------------------------------------------------------
     */    
    __IO uint32_t  DMASK;                       

    /**
     * PIN
     * ===================================================================================================
     * Offset: 0x10  GPIO Port [A/B/C/D/E/F] Pin Value
     * ---------------------------------------------------------------------------------------------------
     */    
    __I  uint32_t  PIN;                         

    /**
     * DBEN
     * ===================================================================================================
     * Offset: 0x14  GPIO Port [A/B/C/D/E/F] De-bounce Enable
     * ---------------------------------------------------------------------------------------------------
     */    
    __IO uint32_t  DBEN;                        

    /**
     * IMD
     * ===================================================================================================
     * Offset: 0x18  GPIO Port [A/B/C/D/E/F] Interrupt Mode Control
     * ---------------------------------------------------------------------------------------------------
     */    
    __IO uint32_t  IMD;                         

    /**
     * IEN
     * ===================================================================================================
     * Offset: 0x1C  GPIO Port [A/B/C/D/E/F] Interrupt Enable Control
     * ---------------------------------------------------------------------------------------------------
     */    
    __IO uint32_t  IEN;                         

    /**
     * ISRC
     * ===================================================================================================
     * Offset: 0x20  GPIO Port [A/B/C/D/E/F] Interrupt Source Flag
     * ---------------------------------------------------------------------------------------------------
     */    
    __IO uint32_t  ISRC;                        
} GPIO_T;                                  
                                                
typedef struct                                  
{                                               
    /**
     * DBNCECON
     * ===================================================================================================
     * Offset: 0x180 Interrupt De-bounce Cycle Control
     * ---------------------------------------------------------------------------------------------------
     */    
    __IO uint32_t  DBNCECON;                    
} GPIO_DBNCECON_T;

/* GPIO PMD Bit Field Definitions */
#define GPIO_PMD_PMD15_Pos          30                                          /*!< GPIO PMD: PMD15 Position */
#define GPIO_PMD_PMD15_Msk          (0x3ul << GPIO_PMD_PMD15_Pos)               /*!< GPIO PMD: PMD15 Mask */

#define GPIO_PMD_PMD14_Pos          28                                          /*!< GPIO PMD: PMD14 Position */
#define GPIO_PMD_PMD14_Msk          (0x3ul << GPIO_PMD_PMD14_Pos)               /*!< GPIO PMD: PMD14 Mask */

#define GPIO_PMD_PMD13_Pos          26                                          /*!< GPIO PMD: PMD13 Position */
#define GPIO_PMD_PMD13_Msk          (0x3ul << GPIO_PMD_PMD13_Pos)               /*!< GPIO PMD: PMD13 Mask */

#define GPIO_PMD_PMD12_Pos          24                                          /*!< GPIO PMD: PMD12 Position */
#define GPIO_PMD_PMD12_Msk          (0x3ul << GPIO_PMD_PMD12_Pos)               /*!< GPIO PMD: PMD12 Mask */

#define GPIO_PMD_PMD11_Pos          22                                          /*!< GPIO PMD: PMD11 Position */
#define GPIO_PMD_PMD11_Msk          (0x3ul << GPIO_PMD_PMD11_Pos)               /*!< GPIO PMD: PMD11 Mask */

#define GPIO_PMD_PMD10_Pos          20                                          /*!< GPIO PMD: PMD10 Position */
#define GPIO_PMD_PMD10_Msk          (0x3ul << GPIO_PMD_PMD10_Pos)               /*!< GPIO PMD: PMD10 Mask */

#define GPIO_PMD_PMD9_Pos           18                                          /*!< GPIO PMD: PMD9 Position */
#define GPIO_PMD_PMD9_Msk           (0x3ul << GPIO_PMD_PMD9_Pos)                /*!< GPIO PMD: PMD9 Mask */

#define GPIO_PMD_PMD8_Pos           16                                          /*!< GPIO PMD: PMD8 Position */
#define GPIO_PMD_PMD8_Msk           (0x3ul << GPIO_PMD_PMD8_Pos)                /*!< GPIO PMD: PMD8 Mask */

#define GPIO_PMD_PMD7_Pos           14                                          /*!< GPIO PMD: PMD7 Position */
#define GPIO_PMD_PMD7_Msk           (0x3ul << GPIO_PMD_PMD7_Pos)                /*!< GPIO PMD: PMD7 Mask */

#define GPIO_PMD_PMD6_Pos           12                                          /*!< GPIO PMD: PMD6 Position */    
#define GPIO_PMD_PMD6_Msk           (0x3ul << GPIO_PMD_PMD6_Pos)                /*!< GPIO PMD: PMD6 Mask */

#define GPIO_PMD_PMD5_Pos           10                                          /*!< GPIO PMD: PMD5 Position */
#define GPIO_PMD_PMD5_Msk           (0x3ul << GPIO_PMD_PMD5_Pos)                /*!< GPIO PMD: PMD5 Mask */

#define GPIO_PMD_PMD4_Pos           8                                           /*!< GPIO PMD: PMD4 Position */
#define GPIO_PMD_PMD4_Msk           (0x3ul << GPIO_PMD_PMD4_Pos)                /*!< GPIO PMD: PMD4 Mask */

#define GPIO_PMD_PMD3_Pos           6                                           /*!< GPIO PMD: PMD3 Position */
#define GPIO_PMD_PMD3_Msk           (0x3ul << GPIO_PMD_PMD3_Pos)                /*!< GPIO PMD: PMD3 Mask */

#define GPIO_PMD_PMD2_Pos           4                                           /*!< GPIO PMD: PMD2 Position */
#define GPIO_PMD_PMD2_Msk           (0x3ul << GPIO_PMD_PMD2_Pos)                /*!< GPIO PMD: PMD2 Mask */

#define GPIO_PMD_PMD1_Pos           2                                           /*!< GPIO PMD: PMD1 Position */
#define GPIO_PMD_PMD1_Msk           (0x3ul << GPIO_PMD_PMD1_Pos)                /*!< GPIO PMD: PMD1 Mask */

#define GPIO_PMD_PMD0_Pos           0                                           /*!< GPIO PMD: PMD0 Position */
#define GPIO_PMD_PMD0_Msk           (0x3ul << GPIO_PMD_PMD0_Pos)                /*!< GPIO PMD: PMD0 Mask */

/* GPIO OFFD Bit Field Definitions */
#define GPIO_OFFD_OFFD15_Pos        31                                          /*!< GPIO OFFD: OFFD15 Position */
#define GPIO_OFFD_OFFD15_Msk        (1ul << GPIO_OFFD_OFFD15_Pos)               /*!< GPIO OFFD: OFFD15 Mask */

#define GPIO_OFFD_OFFD14_Pos        30                                          /*!< GPIO OFFD: OFFD14 Position */
#define GPIO_OFFD_OFFD14_Msk        (1ul << GPIO_OFFD_OFFD14_Pos)               /*!< GPIO OFFD: OFFD14 Mask */

#define GPIO_OFFD_OFFD13_Pos        29                                          /*!< GPIO OFFD: OFFD13 Position */
#define GPIO_OFFD_OFFD13_Msk        (1ul << GPIO_OFFD_OFFD13_Pos)               /*!< GPIO OFFD: OFFD13 Mask */

#define GPIO_OFFD_OFFD12_Pos        28                                          /*!< GPIO OFFD: OFFD12 Position */
#define GPIO_OFFD_OFFD12_Msk        (1ul << GPIO_OFFD_OFFD12_Pos)               /*!< GPIO OFFD: OFFD12 Mask */

#define GPIO_OFFD_OFFD11_Pos        27                                          /*!< GPIO OFFD: OFFD11 Position */
#define GPIO_OFFD_OFFD11_Msk        (1ul << GPIO_OFFD_OFFD11_Pos)               /*!< GPIO OFFD: OFFD11 Mask */

#define GPIO_OFFD_OFFD10_Pos        26                                          /*!< GPIO OFFD: OFFD10 Position */
#define GPIO_OFFD_OFFD10_Msk        (1ul << GPIO_OFFD_OFFD10_Pos)               /*!< GPIO OFFD: OFFD10 Mask */

#define GPIO_OFFD_OFFD9_Pos         25                                          /*!< GPIO OFFD: OFFD9 Position */
#define GPIO_OFFD_OFFD9_Msk         (1ul << GPIO_OFFD_OFFD9_Pos)                /*!< GPIO OFFD: OFFD9 Mask */

#define GPIO_OFFD_OFFD8_Pos         24                                          /*!< GPIO OFFD: OFFD8 Position */
#define GPIO_OFFD_OFFD8_Msk         (1ul << GPIO_OFFD_OFFD8_Pos)                /*!< GPIO OFFD: OFFD8 Mask */

#define GPIO_OFFD_OFFD7_Pos         23                                          /*!< GPIO OFFD: OFFD7 Position */
#define GPIO_OFFD_OFFD7_Msk         (1ul << GPIO_OFFD_OFFD7_Pos)                /*!< GPIO OFFD: OFFD7 Mask */

#define GPIO_OFFD_OFFD6_Pos         22                                          /*!< GPIO OFFD: OFFD6 Position */
#define GPIO_OFFD_OFFD6_Msk         (1ul << GPIO_OFFD_OFFD6_Pos)                /*!< GPIO OFFD: OFFD6 Mask */

#define GPIO_OFFD_OFFD5_Pos         21                                          /*!< GPIO OFFD: OFFD5 Position */
#define GPIO_OFFD_OFFD5_Msk         (1ul << GPIO_OFFD_OFFD5_Pos)                /*!< GPIO OFFD: OFFD5 Mask */

#define GPIO_OFFD_OFFD4_Pos         20                                          /*!< GPIO OFFD: OFFD4 Position */
#define GPIO_OFFD_OFFD4_Msk         (1ul << GPIO_OFFD_OFFD4_Pos)                /*!< GPIO OFFD: OFFD4 Mask */

#define GPIO_OFFD_OFFD3_Pos         19                                          /*!< GPIO OFFD: OFFD3 Position */
#define GPIO_OFFD_OFFD3_Msk         (1ul << GPIO_OFFD_OFFD3_Pos)                /*!< GPIO OFFD: OFFD3 Mask */

#define GPIO_OFFD_OFFD2_Pos         18                                          /*!< GPIO OFFD: OFFD2 Position */
#define GPIO_OFFD_OFFD2_Msk         (1ul << GPIO_OFFD_OFFD2_Pos)                /*!< GPIO OFFD: OFFD2 Mask */

#define GPIO_OFFD_OFFD1_Pos         17                                          /*!< GPIO OFFD: OFFD1 Position */
#define GPIO_OFFD_OFFD1_Msk         (1ul << GPIO_OFFD_OFFD1_Pos)                /*!< GPIO OFFD: OFFD1 Mask */

#define GPIO_OFFD_OFFD0_Pos         16                                          /*!< GPIO OFFD: OFFD0 Position */
#define GPIO_OFFD_OFFD0_Msk         (1ul << GPIO_OFFD_OFFD0_Pos)                /*!< GPIO OFFD: OFFD0 Mask */

/* GPIO DOUT Bit Field Definitions */                                           
#define GPIO_DOUT_DOUT_Pos          0                                           /*!< GPIO DOUT: DOUT Position */
#define GPIO_DOUT_DOUT_Msk          (0xFFFFul << GPIO_DOUT_DOUT_Pos)            /*!< GPIO DOUT: DOUT Mask */

/* GPIO DMASK Bit Field Definitions */
#define GPIO_DMASK_DMASK15_Pos      15                                          /*!< GPIO DMASK: DMASK15 Position */
#define GPIO_DMASK_DMASK15_Msk      (1ul << GPIO_DMASK_DMASK15_Pos)             /*!< GPIO DMASK: DMASK15 Mask */

#define GPIO_DMASK_DMASK14_Pos      14                                          /*!< GPIO DMASK: DMASK14 Position */
#define GPIO_DMASK_DMASK14_Msk      (1ul << GPIO_DMASK_DMASK14_Pos)             /*!< GPIO DMASK: DMASK14 Mask */

#define GPIO_DMASK_DMASK13_Pos      13                                          /*!< GPIO DMASK: DMASK13 Position */
#define GPIO_DMASK_DMASK13_Msk      (1ul << GPIO_DMASK_DMASK13_Pos)             /*!< GPIO DMASK: DMASK13 Mask */

#define GPIO_DMASK_DMASK12_Pos      12                                          /*!< GPIO DMASK: DMASK12 Position */
#define GPIO_DMASK_DMASK12_Msk      (1ul << GPIO_DMASK_DMASK12_Pos)             /*!< GPIO DMASK: DMASK12 Mask */

#define GPIO_DMASK_DMASK11_Pos      11                                          /*!< GPIO DMASK: DMASK11 Position */
#define GPIO_DMASK_DMASK11_Msk      (1ul << GPIO_DMASK_DMASK11_Pos)             /*!< GPIO DMASK: DMASK11 Mask */

#define GPIO_DMASK_DMASK10_Pos      10                                          /*!< GPIO DMASK: DMASK10 Position */
#define GPIO_DMASK_DMASK10_Msk      (1ul << GPIO_DMASK_DMASK10_Pos)             /*!< GPIO DMASK: DMASK10 Mask */

#define GPIO_DMASK_DMASK9_Pos       9                                           /*!< GPIO DMASK: DMASK9 Position */
#define GPIO_DMASK_DMASK9_Msk       (1ul << GPIO_DMASK_DMASK9_Pos)              /*!< GPIO DMASK: DMASK9 Mask */

#define GPIO_DMASK_DMASK8_Pos       8                                           /*!< GPIO DMASK: DMASK8 Position */
#define GPIO_DMASK_DMASK8_Msk       (1ul << GPIO_DMASK_DMASK8_Pos)              /*!< GPIO DMASK: DMASK8 Mask */

#define GPIO_DMASK_DMASK7_Pos       7                                           /*!< GPIO DMASK: DMASK7 Position */
#define GPIO_DMASK_DMASK7_Msk       (1ul << GPIO_DMASK_DMASK7_Pos)              /*!< GPIO DMASK: DMASK7 Mask */

#define GPIO_DMASK_DMASK6_Pos       6                                           /*!< GPIO DMASK: DMASK6 Position */
#define GPIO_DMASK_DMASK6_Msk       (1ul << GPIO_DMASK_DMASK6_Pos)              /*!< GPIO DMASK: DMASK6 Mask */

#define GPIO_DMASK_DMASK5_Pos       5                                           /*!< GPIO DMASK: DMASK5 Position */
#define GPIO_DMASK_DMASK5_Msk       (1ul << GPIO_DMASK_DMASK5_Pos)              /*!< GPIO DMASK: DMASK5 Mask */

#define GPIO_DMASK_DMASK4_Pos       4                                           /*!< GPIO DMASK: DMASK4 Position */
#define GPIO_DMASK_DMASK4_Msk       (1ul << GPIO_DMASK_DMASK4_Pos)              /*!< GPIO DMASK: DMASK4 Mask */

#define GPIO_DMASK_DMASK3_Pos       3                                           /*!< GPIO DMASK: DMASK3 Position */
#define GPIO_DMASK_DMASK3_Msk       (1ul << GPIO_DMASK_DMASK3_Pos)              /*!< GPIO DMASK: DMASK3 Mask */

#define GPIO_DMASK_DMASK2_Pos       2                                           /*!< GPIO DMASK: DMASK2 Position */
#define GPIO_DMASK_DMASK2_Msk       (1ul << GPIO_DMASK_DMASK2_Pos)              /*!< GPIO DMASK: DMASK2 Mask */

#define GPIO_DMASK_DMASK1_Pos       1                                           /*!< GPIO DMASK: DMASK1 Position */
#define GPIO_DMASK_DMASK1_Msk       (1ul << GPIO_DMASK_DMASK1_Pos)              /*!< GPIO DMASK: DMASK1 Mask */

#define GPIO_DMASK_DMASK0_Pos       0                                           /*!< GPIO DMASK: DMASK0 Position */
#define GPIO_DMASK_DMASK0_Msk       (1ul << GPIO_DMASK_DMASK0_Pos)              /*!< GPIO DMASK: DMASK0 Mask */

/* GPIO PIN Bit Field Definitions */
#define GPIO_PIN_PIN_Pos            0                                           /*!< GPIO PIN: PIN Position */   
#define GPIO_PIN_PIN_Msk            (0xFFFFul << GPIO_PIN_PIN_Pos)              /*!< GPIO PIN: PIN Mask */

/* GPIO DBEN Bit Field Definitions */
#define GPIO_DBEN_DBEN15_Pos        15                                          /*!< GPIO DBEN: DBEN15 Position */
#define GPIO_DBEN_DBEN15_Msk        (1ul << GPIO_DBEN_DBEN15_Pos)               /*!< GPIO DBEN: DBEN15 Mask */

#define GPIO_DBEN_DBEN14_Pos        14                                          /*!< GPIO DBEN: DBEN14 Position */
#define GPIO_DBEN_DBEN14_Msk        (1ul << GPIO_DBEN_DBEN14_Pos)               /*!< GPIO DBEN: DBEN14 Mask */

#define GPIO_DBEN_DBEN13_Pos        13                                          /*!< GPIO DBEN: DBEN13 Position */
#define GPIO_DBEN_DBEN13_Msk        (1ul << GPIO_DBEN_DBEN13_Pos)               /*!< GPIO DBEN: DBEN13 Mask */

#define GPIO_DBEN_DBEN12_Pos        12                                          /*!< GPIO DBEN: DBEN12 Position */
#define GPIO_DBEN_DBEN12_Msk        (1ul << GPIO_DBEN_DBEN12_Pos)               /*!< GPIO DBEN: DBEN12 Mask */

#define GPIO_DBEN_DBEN11_Pos        11                                          /*!< GPIO DBEN: DBEN11 Position */
#define GPIO_DBEN_DBEN11_Msk        (1ul << GPIO_DBEN_DBEN11_Pos)               /*!< GPIO DBEN: DBEN11 Mask */

#define GPIO_DBEN_DBEN10_Pos        10                                          /*!< GPIO DBEN: DBEN10 Position */
#define GPIO_DBEN_DBEN10_Msk        (1ul << GPIO_DBEN_DBEN10_Pos)               /*!< GPIO DBEN: DBEN10 Mask */

#define GPIO_DBEN_DBEN9_Pos         9                                           /*!< GPIO DBEN: DBEN9 Position */
#define GPIO_DBEN_DBEN9_Msk         (1ul << GPIO_DBEN_DBEN9_Pos)                /*!< GPIO DBEN: DBEN9 Mask */

#define GPIO_DBEN_DBEN8_Pos         8                                           /*!< GPIO DBEN: DBEN8 Position */
#define GPIO_DBEN_DBEN8_Msk         (1ul << GPIO_DBEN_DBEN8_Pos)                /*!< GPIO DBEN: DBEN8 Mask */

#define GPIO_DBEN_DBEN7_Pos         7                                           /*!< GPIO DBEN: DBEN7 Position */
#define GPIO_DBEN_DBEN7_Msk         (1ul << GPIO_DBEN_DBEN7_Pos)                /*!< GPIO DBEN: DBEN7 Mask */

#define GPIO_DBEN_DBEN6_Pos         6                                           /*!< GPIO DBEN: DBEN6 Position */
#define GPIO_DBEN_DBEN6_Msk         (1ul << GPIO_DBEN_DBEN6_Pos)                /*!< GPIO DBEN: DBEN6 Mask */

#define GPIO_DBEN_DBEN5_Pos         5                                           /*!< GPIO DBEN: DBEN5 Position */
#define GPIO_DBEN_DBEN5_Msk         (1ul << GPIO_DBEN_DBEN5_Pos)                /*!< GPIO DBEN: DBEN5 Mask */

#define GPIO_DBEN_DBEN4_Pos         4                                           /*!< GPIO DBEN: DBEN4 Position */
#define GPIO_DBEN_DBEN4_Msk         (1ul << GPIO_DBEN_DBEN4_Pos)                /*!< GPIO DBEN: DBEN4 Mask */

#define GPIO_DBEN_DBEN3_Pos         3                                           /*!< GPIO DBEN: DBEN3 Position */
#define GPIO_DBEN_DBEN3_Msk         (1ul << GPIO_DBEN_DBEN3_Pos)                /*!< GPIO DBEN: DBEN3 Mask */

#define GPIO_DBEN_DBEN2_Pos         2                                           /*!< GPIO DBEN: DBEN2 Position */
#define GPIO_DBEN_DBEN2_Msk         (1ul << GPIO_DBEN_DBEN2_Pos)                /*!< GPIO DBEN: DBEN2 Mask */

#define GPIO_DBEN_DBEN1_Pos         1                                           /*!< GPIO DBEN: DBEN1 Position */
#define GPIO_DBEN_DBEN1_Msk         (1ul << GPIO_DBEN_DBEN1_Pos)                /*!< GPIO DBEN: DBEN1 Mask */

#define GPIO_DBEN_DBEN0_Pos         0                                           /*!< GPIO DBEN: DBEN0 Position */
#define GPIO_DBEN_DBEN0_Msk         (1ul << GPIO_DBEN_DBEN0_Pos)                /*!< GPIO DBEN: DBEN0 Mask */

/* GPIO IMD Bit Field Definitions */
#define GPIO_IMD_IMD15_Pos          15                                          /*!< GPIO IMD: IMD15 Position */
#define GPIO_IMD_IMD15_Msk          (1ul << GPIO_IMD_IMD15_Pos)                 /*!< GPIO IMD: IMD15 Mask */

#define GPIO_IMD_IMD14_Pos          14                                          /*!< GPIO IMD: IMD14 Position */
#define GPIO_IMD_IMD14_Msk          (1ul << GPIO_IMD_IMD14_Pos)                 /*!< GPIO IMD: IMD14 Mask */

#define GPIO_IMD_IMD13_Pos          13                                          /*!< GPIO IMD: IMD13 Position */
#define GPIO_IMD_IMD13_Msk          (1ul << GPIO_IMD_IMD13_Pos)                 /*!< GPIO IMD: IMD13 Mask */

#define GPIO_IMD_IMD12_Pos          12                                          /*!< GPIO IMD: IMD12 Position */
#define GPIO_IMD_IMD12_Msk          (1ul << GPIO_IMD_IMD12_Pos)                 /*!< GPIO IMD: IMD12 Mask */

#define GPIO_IMD_IMD11_Pos          11                                          /*!< GPIO IMD: IMD11 Position */
#define GPIO_IMD_IMD11_Msk          (1ul << GPIO_IMD_IMD11_Pos)                 /*!< GPIO IMD: IMD11 Mask */

#define GPIO_IMD_IMD10_Pos          10                                          /*!< GPIO IMD: IMD10 Position */
#define GPIO_IMD_IMD10_Msk          (1ul << GPIO_IMD_IMD10_Pos)                 /*!< GPIO IMD: IMD10 Mask */

#define GPIO_IMD_IMD9_Pos           9                                           /*!< GPIO IMD: IMD9 Position */
#define GPIO_IMD_IMD9_Msk           (1ul << GPIO_IMD_IMD9_Pos)                  /*!< GPIO IMD: IMD9 Mask */

#define GPIO_IMD_IMD8_Pos           8                                           /*!< GPIO IMD: IMD8 Position */
#define GPIO_IMD_IMD8_Msk           (1ul << GPIO_IMD_IMD8_Pos)                  /*!< GPIO IMD: IMD8 Mask */

#define GPIO_IMD_IMD7_Pos           7                                           /*!< GPIO IMD: IMD7 Position */
#define GPIO_IMD_IMD7_Msk           (1ul << GPIO_IMD_IMD7_Pos)                  /*!< GPIO IMD: IMD7 Mask */

#define GPIO_IMD_IMD6_Pos           6                                           /*!< GPIO IMD: IMD6 Position */
#define GPIO_IMD_IMD6_Msk           (1ul << GPIO_IMD_IMD6_Pos)                  /*!< GPIO IMD: IMD6 Mask */

#define GPIO_IMD_IMD5_Pos           5                                           /*!< GPIO IMD: IMD5 Position */
#define GPIO_IMD_IMD5_Msk           (1ul << GPIO_IMD_IMD5_Pos)                  /*!< GPIO IMD: IMD5 Mask */

#define GPIO_IMD_IMD4_Pos           4                                           /*!< GPIO IMD: IMD4 Position */
#define GPIO_IMD_IMD4_Msk           (1ul << GPIO_IMD_IMD4_Pos)                  /*!< GPIO IMD: IMD4 Mask */

#define GPIO_IMD_IMD3_Pos           3                                           /*!< GPIO IMD: IMD3 Position */
#define GPIO_IMD_IMD3_Msk           (1ul << GPIO_IMD_IMD3_Pos)                  /*!< GPIO IMD: IMD3 Mask */

#define GPIO_IMD_IMD2_Pos           2                                           /*!< GPIO IMD: IMD2 Position */
#define GPIO_IMD_IMD2_Msk           (1ul << GPIO_IMD_IMD2_Pos)                  /*!< GPIO IMD: IMD2 Mask */

#define GPIO_IMD_IMD1_Pos           1                                           /*!< GPIO IMD: IMD1 Position */
#define GPIO_IMD_IMD1_Msk           (1ul << GPIO_IMD_IMD1_Pos)                  /*!< GPIO IMD: IMD1 Mask */

#define GPIO_IMD_IMD0_Pos           0                                           /*!< GPIO IMD: IMD0 Position */
#define GPIO_IMD_IMD0_Msk           (1ul << GPIO_IMD_IMD0_Pos)                  /*!< GPIO IMD: IMD0 Mask */

/* GPIO IEN Bit Field Definitions */
#define GPIO_IEN_IR_EN15_Pos        31                                          /*!< GPIO IEN: IR_EN15 Position */
#define GPIO_IEN_IR_EN15_Msk        (1ul << GPIO_IEN_IR_EN15_Pos)               /*!< GPIO IEN: IR_EN15 Mask */

#define GPIO_IEN_IR_EN14_Pos        30                                          /*!< GPIO IEN: IR_EN14 Position */
#define GPIO_IEN_IR_EN14_Msk        (1ul << GPIO_IEN_IR_EN14_Pos)               /*!< GPIO IEN: IR_EN14 Mask */

#define GPIO_IEN_IR_EN13_Pos        29                                          /*!< GPIO IEN: IR_EN13 Position */
#define GPIO_IEN_IR_EN13_Msk        (1ul << GPIO_IEN_IR_EN13_Pos)               /*!< GPIO IEN: IR_EN13 Mask */

#define GPIO_IEN_IR_EN12_Pos        28                                          /*!< GPIO IEN: IR_EN12 Position */
#define GPIO_IEN_IR_EN12_Msk        (1ul << GPIO_IEN_IR_EN12_Pos)               /*!< GPIO IEN: IR_EN12 Mask */

#define GPIO_IEN_IR_EN11_Pos        27                                          /*!< GPIO IEN: IR_EN11 Position */
#define GPIO_IEN_IR_EN11_Msk        (1ul << GPIO_IEN_IR_EN11_Pos)               /*!< GPIO IEN: IR_EN11 Mask */

#define GPIO_IEN_IR_EN10_Pos        26                                          /*!< GPIO IEN: IR_EN10 Position */
#define GPIO_IEN_IR_EN10_Msk        (1ul << GPIO_IEN_IR_EN10_Pos)               /*!< GPIO IEN: IR_EN10 Mask */

#define GPIO_IEN_IR_EN9_Pos         25                                          /*!< GPIO IEN: IR_EN9 Position */
#define GPIO_IEN_IR_EN9_Msk         (1ul << GPIO_IEN_IR_EN9_Pos)                /*!< GPIO IEN: IR_EN9 Mask */

#define GPIO_IEN_IR_EN8_Pos         24                                          /*!< GPIO IEN: IR_EN8 Position */
#define GPIO_IEN_IR_EN8_Msk         (1ul << GPIO_IEN_IR_EN8_Pos)                /*!< GPIO IEN: IR_EN8 Mask */

#define GPIO_IEN_IR_EN7_Pos         23                                          /*!< GPIO IEN: IR_EN7 Position */
#define GPIO_IEN_IR_EN7_Msk         (1ul << GPIO_IEN_IR_EN7_Pos)                /*!< GPIO IEN: IR_EN7 Mask */

#define GPIO_IEN_IR_EN6_Pos         22                                          /*!< GPIO IEN: IR_EN6 Position */
#define GPIO_IEN_IR_EN6_Msk         (1ul << GPIO_IEN_IR_EN6_Pos)                /*!< GPIO IEN: IR_EN6 Mask */

#define GPIO_IEN_IR_EN5_Pos         21                                          /*!< GPIO IEN: IR_EN5 Position */
#define GPIO_IEN_IR_EN5_Msk         (1ul << GPIO_IEN_IR_EN5_Pos)                /*!< GPIO IEN: IR_EN5 Mask */

#define GPIO_IEN_IR_EN4_Pos         20                                          /*!< GPIO IEN: IR_EN4 Position */
#define GPIO_IEN_IR_EN4_Msk         (1ul << GPIO_IEN_IR_EN4_Pos)                /*!< GPIO IEN: IR_EN4 Mask */

#define GPIO_IEN_IR_EN3_Pos         19                                          /*!< GPIO IEN: IR_EN3 Position */
#define GPIO_IEN_IR_EN3_Msk         (1ul << GPIO_IEN_IR_EN3_Pos)                /*!< GPIO IEN: IR_EN3 Mask */

#define GPIO_IEN_IR_EN2_Pos         18                                          /*!< GPIO IEN: IR_EN2 Position */
#define GPIO_IEN_IR_EN2_Msk         (1ul << GPIO_IEN_IR_EN2_Pos)                /*!< GPIO IEN: IR_EN2 Mask */

#define GPIO_IEN_IR_EN1_Pos         17                                          /*!< GPIO IEN: IR_EN1 Position */
#define GPIO_IEN_IR_EN1_Msk         (1ul << GPIO_IEN_IR_EN1_Pos)                /*!< GPIO IEN: IR_EN1 Mask */

#define GPIO_IEN_IR_EN0_Pos         16                                          /*!< GPIO IEN: IR_EN0 Position */
#define GPIO_IEN_IR_EN0_Msk         (1ul << GPIO_IEN_IR_EN0_Pos)                /*!< GPIO IEN: IR_EN0 Mask */

#define GPIO_IEN_IF_EN15_Pos        15                                          /*!< GPIO IEN: IF_EN15 Position */
#define GPIO_IEN_IF_EN15_Msk        (1ul << GPIO_IEN_IF_EN15_Pos)               /*!< GPIO IEN: IF_EN15 Mask */

#define GPIO_IEN_IF_EN14_Pos        14                                          /*!< GPIO IEN: IF_EN14 Position */
#define GPIO_IEN_IF_EN14_Msk        (1ul << GPIO_IEN_IF_EN14_Pos)               /*!< GPIO IEN: IF_EN14 Mask */

#define GPIO_IEN_IF_EN13_Pos        13                                          /*!< GPIO IEN: IF_EN13 Position */
#define GPIO_IEN_IF_EN13_Msk        (1ul << GPIO_IEN_IF_EN13_Pos)               /*!< GPIO IEN: IF_EN13 Mask */

#define GPIO_IEN_IF_EN12_Pos        12                                          /*!< GPIO IEN: IF_EN12 Position */
#define GPIO_IEN_IF_EN12_Msk        (1ul << GPIO_IEN_IF_EN12_Pos)               /*!< GPIO IEN: IF_EN12 Mask */

#define GPIO_IEN_IF_EN11_Pos        11                                          /*!< GPIO IEN: IF_EN11 Position */
#define GPIO_IEN_IF_EN11_Msk        (1ul << GPIO_IEN_IF_EN11_Pos)               /*!< GPIO IEN: IF_EN11 Mask */

#define GPIO_IEN_IF_EN10_Pos        10                                          /*!< GPIO IEN: IF_EN10 Position */
#define GPIO_IEN_IF_EN10_Msk        (1ul << GPIO_IEN_IF_EN10_Pos)               /*!< GPIO IEN: IF_EN10 Mask */

#define GPIO_IEN_IF_EN9_Pos         9                                           /*!< GPIO IEN: IF_EN9 Position */
#define GPIO_IEN_IF_EN9_Msk         (1ul << GPIO_IEN_IF_EN9_Pos)                /*!< GPIO IEN: IF_EN9 Mask */

#define GPIO_IEN_IF_EN8_Pos         8                                           /*!< GPIO IEN: IF_EN8 Position */
#define GPIO_IEN_IF_EN8_Msk         (1ul << GPIO_IEN_IF_EN8_Pos)                /*!< GPIO IEN: IF_EN8 Mask */

#define GPIO_IEN_IF_EN7_Pos         7                                           /*!< GPIO IEN: IF_EN7 Position */
#define GPIO_IEN_IF_EN7_Msk         (1ul << GPIO_IEN_IF_EN7_Pos)                /*!< GPIO IEN: IF_EN7 Mask */

#define GPIO_IEN_IF_EN6_Pos         6                                           /*!< GPIO IEN: IF_EN6 Position */
#define GPIO_IEN_IF_EN6_Msk         (1ul << GPIO_IEN_IF_EN6_Pos)                /*!< GPIO IEN: IF_EN6 Mask */

#define GPIO_IEN_IF_EN5_Pos         5                                           /*!< GPIO IEN: IF_EN5 Position */
#define GPIO_IEN_IF_EN5_Msk         (1ul << GPIO_IEN_IF_EN5_Pos)                /*!< GPIO IEN: IF_EN5 Mask */

#define GPIO_IEN_IF_EN4_Pos         4                                           /*!< GPIO IEN: IF_EN4 Position */
#define GPIO_IEN_IF_EN4_Msk         (1ul << GPIO_IEN_IF_EN4_Pos)                /*!< GPIO IEN: IF_EN4 Mask */

#define GPIO_IEN_IF_EN3_Pos         3                                           /*!< GPIO IEN: IF_EN3 Position */
#define GPIO_IEN_IF_EN3_Msk         (1ul << GPIO_IEN_IF_EN3_Pos)                /*!< GPIO IEN: IF_EN3 Mask */

#define GPIO_IEN_IF_EN2_Pos         2                                           /*!< GPIO IEN: IF_EN2 Position */
#define GPIO_IEN_IF_EN2_Msk         (1ul << GPIO_IEN_IF_EN2_Pos)                /*!< GPIO IEN: IF_EN2 Mask */

#define GPIO_IEN_IF_EN1_Pos         1                                           /*!< GPIO IEN: IF_EN1 Position */
#define GPIO_IEN_IF_EN1_Msk         (1ul << GPIO_IEN_IF_EN1_Pos)                /*!< GPIO IEN: IF_EN1 Mask */

#define GPIO_IEN_IF_EN0_Pos         0                                           /*!< GPIO IEN: IF_EN0 Position */
#define GPIO_IEN_IF_EN0_Msk         (1ul << GPIO_IEN_IF_EN0_Pos)                /*!< GPIO IEN: IF_EN0 Mask */

/* GPIO ISRC Bit Field Definitions */
#define GPIO_ISRC_ISRC_Pos          0                                           /*!< GPIO ISRC: ISRC Position */
#define GPIO_ISRC_ISRC_Msk          (0xFFFFul << GPIO_ISRC_ISRC_Pos)            /*!< GPIO ISRC: ISRC Mask */

/* GPIO DBNCECON Bit Field Definitions */
#define GPIO_DBNCECON_ICLK_ON_Pos   5                                           /*!< GPIO DBNCECON: ICLK_ON  Position */
#define GPIO_DBNCECON_ICLK_ON_Msk   (1ul << GPIO_DBNCECON_ICLK_ON_Pos)          /*!< GPIO DBNCECON: ICLK_ON  Mask */

#define GPIO_DBNCECON_DBCLKSRC_Pos  4                                           /*!< GPIO DBNCECON: DBCLKSRC Position */
#define GPIO_DBNCECON_DBCLKSRC_Msk  (1ul << GPIO_DBNCECON_DBCLKSRC_Pos)         /*!< GPIO DBNCECON: DBCLKSRC Mask */

#define GPIO_DBNCECON_DBCLKSEL_Pos  0                                           /*!< GPIO DBNCECON: DBCLKSEL Position */
#define GPIO_DBNCECON_DBCLKSEL_Msk  (0xFul << GPIO_DBNCECON_DBCLKSEL_Pos)       /*!< GPIO DBNCECON: DBCLKSEL Mask */
/*@}*/ /* end of group NUC123_GPIO */



/*------------------------- UART Interface Controller ------------------------*/

/** @addtogroup NUC123_UART NUC123 UART
  Memory Mapped Structure for NUC123 Series UART Serial Interface Controller
  @{
 */
typedef struct
{
                                
    union {                             
    __IO uint32_t DATA;                 

    /**
     * THR
     * ===================================================================================================
     * Offset: 0x00 Transmit Holding DATA
     * ---------------------------------------------------------------------------------------------------
     * |Bits    |Field     |Descriptions
     * | :----: | :----:   | :---- |
     * |[7:0]   |          |bitTransmittedData
     * |        |          |Transmit Holding Register
     * |        |          |By writing to this register, the UART will send out an 8-bit data through the Tx pin (LSB 
     * |        |          |first).
     */    
    __IO uint32_t THR;                  

    /**
     * RBR
     * ===================================================================================================
     * Offset: 0x00 Receive Buffer
     * ---------------------------------------------------------------------------------------------------
     * |Bits    |Field     |Descriptions
     * | :----: | :----:   | :---- |
     * |[7:0]   |          |Receive Buffer Register
     * |        |          |By reading this register, the UART will return an 8-bit data received from Rx pin (LSB first).
     */    
    __IO uint32_t RBR;                  
    };

    /**
     * IER
     * ===================================================================================================
     * Offset: 0x04  UART Interrupt Enable Register
     * ---------------------------------------------------------------------------------------------------
     * |Bits    |Field     |Descriptions
     * | :----: | :----:   | :---- |
     * |[0]     |RDA_IEN   |Receive Data Available Interrupt Enable.
     * |        |          |0 = Mask off INT_RDA
     * |        |          |1 = Enable INT_RDA
     * |[1]     |THRE_IEN  |Transmit Holding Register Empty Interrupt Enable
     * |        |          |0 = Mask off INT_THRE
     * |        |          |1 = Enable INT_THRE
     * |[2]     |RLS_IEN   |Receive Line Status Interrupt Enable 
     * |        |          |0 = Mask off INT_RLS
     * |        |          |1 = Enable INT_RLS
     * |[3]     |Modem_IEN |Modem Status Interrupt Enable 
     * |        |          |0 = Mask off INT_MOS
     * |        |          |1 = Enable INT_MOS
     * |[4]     |RTO_IEN   |Rx Time out Interrupt Enable
     * |        |          |0 = Mask off INT_tout
     * |        |          |1 = Enable INT_tout 
     * |[5]     |BUF_ERR_IEN|Buffer Error Interrupt Enable
     * |        |          |0 = Mask off INT_Buf_err
     * |        |          |1 = Enable INT_Buf_err
     * |[6]     |Wake_EN   |Wake up CPU function enable 
     * |        |          |0 = Disable UART wake up CPU function
     * |        |          |1 = Enable wake up function, when the system is in deep sleep mode, an external /CTS 
     * |        |          |change will wake up CPU from deep sleep mode.
     * |[11]    |Time_Out_EN|Time-Out Counter Enable
     * |        |          |1 = Enable Time-out counter.
     * |        |          |0 = Disable Time-out counter.
     * |[12]    |Auto_RTS_EN|RTS Auto Flow Control Enable 
     * |        |          |1 = Enable RTS auto flow control.
     * |        |          |0 = Disable RTS auto flow control.
     * |        |          |When RTS auto-flow is enabled, if the number of bytes in the Rx FIFO equals the UA_FCR 
     * |[RTS_Tri_Lev], the UART will dessert RTS signal.|[13]      |Auto_CTS_EN
     * |        |          |CTS Auto Flow Control Enable
     * |        |          |1 = Enable CTS auto flow control.
     * |        |          |0 = Disable CTS auto flow control.
     * |        |          |When CTS auto-flow is enabled, the UART will send data to external device when CTS input 
     * |        |          |assert (UART will not send data to device until CTS is asserted).
     */    
    __IO uint32_t IER;                  

    /**
     * FCR
     * ===================================================================================================
     * Offset: 0x08  UART FIFO Control Register
     * ---------------------------------------------------------------------------------------------------
     * |Bits    |Field     |Descriptions
     * | :----: | :----:   | :---- |
     * |[1]     |RFR       |Rx Software Reset
     * |        |          |When Rx_RST is set, all the bytes in the transmit FIFO and Rx internal state machine are 
     * |        |          |cleared.
     * |        |          |0 = Writing 0 to this bit has no effect.
     * |        |          |1 = Writing 1 to this bit will reset the Rx internal state machine and pointers.
     * |        |          |Note: This bit will auto clear and takes at least 3 UART engine clock cycles.
     * |[2]     |TFR       |Tx Software Reset
     * |        |          |When Tx_RST is set, all the bytes in the transmit FIFO and Tx internal state machine are 
     * |        |          |cleared.
     * |        |          |0 = Writing 0 to this bit has no effect.
     * |        |          |1 = Writing 1 to this bit will reset the Tx internal state machine and pointers.
     * |        |          |Note: This bit will auto clear and takes at least 3 UART engine clock cycles.
     * |[7:4]   |RFITL     |Word Length Select
     * |        |          |INTR_RDA Tigger Level(Bytes)
     * |        |          |0000 = 01 Bytes
     * |        |          |0001 = 04 Bytes
     * |        |          |0010 = 08 Bytes
     * |        |          |0011 = 14 Bytes
     * |[8]     |RX_DIS    |Receiver Disable register.
     * |        |          |The receiver is disabled or not (set 1 is disable receiver)
     * |        |          |1: Disable Receiver
     * |        |          |0: Enable Receiver
     * |        |          |Note: This field is used for RS-485 Normal Multi-drop mode. It should be programmed before 
     * |        |          |RS-485 enable function in UA_FUN_SEL. FUN_SEL is programmed.
     * |[19:16] |RTS_Tri_Lev|Word Length Select
     * |        |          |0000 = 01 Bytes
     * |        |          |0001 = 04 Bytes
     * |        |          |0010 = 08 Bytes
     * |        |          |0011 = 14 Bytes
     */    
    __IO uint32_t FCR;                  

    /**
     * LCR
     * ===================================================================================================
     * Offset: 0x0C  UART Line Control Register
     * ---------------------------------------------------------------------------------------------------
     * |Bits    |Field     |Descriptions
     * | :----: | :----:   | :---- |
     * |[1:0]   |WLS       |Word Length Select
     * |        |          |00 = 5 bits
     * |        |          |01 = 6 bits
     * |        |          |10 = 7 bits
     * |        |          |11 = 8 bits
     * |[2]     |NSB       |Number of "STOP bit"
     * |        |          |0= One "STOP bit" is generated in the transmitted data
     * |        |          |1= One and a half "STOP bit" is generated in the transmitted data when 5-bit word length is selected;
     * |        |          |Two "STOP bit" is generated when 6-, 7- and 8-bit word length is selected.
     * |[3]     |PBE       |Parity Bit Enable
     * |        |          |0 = Parity bit is not generated (transmit data) or checked (receive data) during transfer.
     * |        |          |1 = Parity bit is generated or checked between the "last data word bit" and "stop bit" of the serial data.
     * |[4]     |EPE       |Even Parity Enable
     * |        |          |0 = Odd number of logic 1's are transmitted or checked in the data word and parity bits.
     * |        |          |1 = Even number of logic 1's are transmitted or checked in the data word and parity bits.
     * |        |          |This bit has effect only when bit 3 (parity bit enable) is set.
     * |[5]     |SPE       |Stick Parity Enable 
     * |        |          |0 = Disable stick parity 
     * |        |          |1 = When bits PBE , EPE and SPE are set, the parity bit is transmitted and checked as cleared. When 
     * |        |          |PBE and SPE are set and EPE is cleared, the parity bit is transmitted and checked as set.
     * |[6]     |BCB       |Break Control Bit 
     * |        |          |When this bit is set to logic 1, the serial data output (Tx) is forced to the Spacing State (logic 0). This bit 
     * |        |          |acts only on Tx and has no effect on the transmitter logic.
     */    
    __IO uint32_t LCR;                  

    /**
     * MCR
     * ===================================================================================================
     * Offset: 0x10  UART Modem Control Register
     * ---------------------------------------------------------------------------------------------------
     * |Bits    |Field     |Descriptions
     * | :----: | :----:   | :---- |
     * |[1]     |RTS       |RTS (Request-To-Send) Signal 
     * |        |          |0: Drive RTS pin to logic 1 (If the Lev_RTS set to low level triggered).
     * |        |          |1: Drive RTS pin to logic 0 (If the Lev_RTS set to low level triggered).
     * |        |          |0: Drive RTS pin to logic 0 (If the Lev_RTS set to high level triggered).
     * |        |          |1: Drive RTS pin to logic 1 (If the Lev_RTS set to high level triggered).
     * |[9]     |Lev_RTS   |RTS Trigger Level 
     * |        |          |This bit can change the RTS trigger level.
     * |        |          |0= low level triggered
     * |        |          |1= high level triggered
     * |[13]    |RTS_St    |RTS Pin State 
     * |        |          |This bit is the pin status of RTS.
     */    
    __IO uint32_t MCR;                  

    /**
     * MSR
     * ===================================================================================================
     * Offset: 0x14  UART Modem Status Register
     * ---------------------------------------------------------------------------------------------------
     * |Bits    |Field     |Descriptions
     * | :----: | :----:   | :---- |
     * |[0]     |DCTSF     |Detect CTS State Change Flag 
     * |        |          |This bit is set whenever CTS input has change state, and it will generate Modem interrupt to CPU 
     * |        |          |when IER [Modem_IEN].
     * |        |          |NOTE: This bit is cleared by writing 1 to itself.
     * |[4]     |CTS_St    |CTS Pin Status 
     * |        |          |This bit is the pin status of CTS. 
     * |[8]     |Lev_CTS   |CTS Trigger Level
     * |        |          |This bit can change the CTS trigger level.
     * |        |          |0= low level triggered
     * |        |          |1= high level triggered
     */    
    __IO uint32_t MSR;                  

    /**
     * FSR
     * ===================================================================================================
     * Offset: 0x18  UART FIFO Status Register
     * ---------------------------------------------------------------------------------------------------
     * |Bits    |Field     |Descriptions
     * | :----: | :----:   | :---- |
     * |[0]     |Rx_Over_IF|Rx overflow Error IF (Read Only) 
     * |        |          |This bit is set when Rx FIFO overflow.
     * |        |          |If the number of bytes of received data is greater than Rx FIFO(UA_RBR) size, 16 bytes of 
     * |        |          |UART0/UART1, this bit will be set.
     * |        |          |NOTE: This bit is cleared by writing 1 to itself.
     * |[3]     |RS-       |485_Add_Det
     * |        |          |RS-485 Address Byte Detection Flag
     * |        |          |This bit is set to logic 1 and set UA_RS-485_CSR [RS-485_Add_EN] whenever in RS-485 
     * |        |          |mode the receiver detect any address byte received address byte character (bit9 = '1') bit", 
     * |        |          |and it is reset whenever the CPU writes 1 to this bit.
     * |        |          |Note: This field is used for RS-485 mode.
     * |[4]     |PEF       |Parity Error Flag
     * |        |          |This bit is set to logic 1 whenever the received character does not have a valid "parity bit", 
     * |        |          |and is reset whenever the CPU writes 1 to this bit.
     * |[5]     |FEF       |Framing Error Flag
     * |        |          |This bit is set to logic 1 whenever the received character does not have a valid "stop bit" (that 
     * |        |          |is, the stop bit following the last data bit or parity bit is detected as a logic 0), and is reset 
     * |        |          |whenever the CPU writes 1 to this bit.
     * |[6]     |BIF       |Break Interrupt Flag
     * |        |          |This bit is set to a logic 1 whenever the received data input(Rx) is held in the "spacing state" 
     * |        |          |(logic 0) for longer than a full word transmission time (that is, the total time of "start bit" + data 
     * |        |          |bits + parity + stop bits) and is reset whenever the CPU writes 1 to this bit.
     * |[13:8]  |Rx_Pointer|Rx FIFO pointer (Read Only)
     * |        |          |This field indicates the Rx FIFO Buffer Pointer. When UART receives one byte from external 
     * |        |          |device, Rx_Pointer increases one. When one byte of Rx FIFO is read by CPU, Rx_Pointer 
     * |        |          |decreases one.
     * |[14]    |Rx_Empty  |Receiver FIFO Empty (Read Only)
     * |        |          |This bit initiate Rx FIFO empty or not.
     * |        |          |When the last byte of Rx FIFO has been read by CPU, hardware sets this bit high. It will be 
     * |        |          |cleared when UART receives any new data.
     * |[15]    |Rx_Full   |Receiver FIFO Full (Read Only)
     * |        |          |This bit initiates Rx FIFO full or not.
     * |        |          |This bit is set when Rx_Pointer is equal to 16(UART0/UART1), otherwise is cleared by 
     * |        |          |hardware.
     * |[21:16] |Tx_Pointer|TX FIFO Pointer (Read Only)
     * |        |          |This field indicates the Tx FIFO Buffer Pointer. When CPU write one byte into UA_THR, 
     * |        |          |Tx_Pointer increases one. When one byte of Tx FIFO is transferred to Transmitter Shift 
     * |        |          |Register, Tx_Pointer decreases one.
     * |[22]    |Tx_Empty  |Transmitter FIFO Empty (Read Only)
     * |        |          |This bit indicates Tx FIFO empty or not.
     * |        |          |When the last byte of Tx FIFO has been transferred to Transmitter Shift Register, hardware 
     * |        |          |sets this bit high. It will be cleared when writing data into THR (Tx FIFO not empty).
     * |[23]    |Tx_Full   |Transmitter FIFO Full (Read Only)
     * |        |          |This bit indicates Tx FIFO full or not.
     * |        |          |This bit is set when Tx_Pointer is equal to 64/16(UART0/UART1), otherwise is cleared by 
     * |        |          |hardware.
     * |[24]    |Tx_Over_IF|Tx Overflow Error Interrupt Flag (Read Only)
     * |        |          |If Tx FIFO(UA_THR) is full, an additional write to UA_THR will cause this bit to logic 1. 
     * |        |          |NOTE: This bit is cleared by writing 1 to itself.
     * |[28]    |TE_Flag   |Transmitter Empty Flag (Read Only)
     * |        |          |Bit is set by hardware when Tx FIFO(UA_THR) is empty and the STOP bit of the last byte 
     * |        |          |has been transmitted.
     * |        |          |Bit is cleared automatically when Tx FIFO is not empty or the last byte transmission has not 
     * |        |          |completed.
     * |        |          |NOTE: This bit is read only. 
     */    
    __IO uint32_t FSR;                  

    /**
     * ISR
     * ===================================================================================================
     * Offset: 0x1C  UART Interrupt Status Register
     * ---------------------------------------------------------------------------------------------------
     * |Bits    |Field     |Descriptions
     * | :----: | :----:   | :---- |
     * |[0]     |RDA_IF    |Receive Data Available Interrupt Flag (Read Only).
     * |        |          |When the number of bytes in the Rx FIFO equals the RFITL then the RDA_IF will be set. If 
     * |        |          |IER[RDA_IEN] is enabled, the RDA interrupt will be generated. 
     * |        |          |NOTE: This bit is read only and it will be cleared when the number of unread bytes of Rx FIFO 
     * |        |          |drops below the threshold level (RFITL).
     * |[1]     |THRE_IF   |Transmit Holding Register Empty Interrupt Flag (Read Only). 
     * |        |          |This bit is set when the last data of Tx FIFO is transferred to Transmitter Shift Register. If 
     * |        |          |IER[THRE_IEN] is enabled, the THRE interrupt will be generated.
     * |        |          |NOTE: This bit is read only and it will be cleared when writing data into THR (Tx FIFO not empty).
     * |[2]     |RLS_IF    |Receive Line Interrupt Flag (Read Only).
     * |        |          |In UART mode this bit is set when the Rx receive data have parity error, framing error or break 
     * |        |          |error (at least one of 3 bits, BIF, FEF and PEF, is set). In RS-485 mode, the field includes RS-485 
     * |        |          |Address Byte Detection Flag. If IER[RLS_IEN] is enabled, the RLS interrupt will be generated.
     * |        |          |NOTE: This bit is read only and reset to 0 when all bits of BIF, FEF, PEF and RS-485_Add_Det 
     * |        |          |are cleared.
     * |[3]     |Modem_IF  |MODEM Interrupt Flag (Read Only) 
     * |        |          |This bit is set when the CTS pin has state change (DCTSF=1). If IER[Modem_IEN] is enabled, the 
     * |        |          |Modem interrupt will be generated.
     * |        |          |NOTE: This bit is read only and reset to 0 when bit DCTSF is cleared by a write 1 on DCTSF.
     * |[4]     |Tout_IF   |Time Out Interrupt Flag (Read Only)
     * |        |          |This bit is set when the Rx FIFO is not empty and no activities occur in the Rx FIFO and the time 
     * |        |          |out counter equal to TOIC. If IER [Tout_IEN] is enabled, the Tout interrupt will be generated. 
     * |        |          |NOTE: This bit is read only and user can read UA_RBR (Rx is in active) to clear it.
     * |[5]     |Buf_Err_IF|Buffer Error Interrupt Flag (Read Only)
     * |        |          |This bit is set when the Tx or Rx FIFO overflows (Tx_Over_IF or Rx_Over_IF is set). When 
     * |        |          |Buf_Err_IF is set, the transfer maybe not correct. If IER[Buf_Err_IEN] is enabled, the buffer error 
     * |        |          |interrupt will be generated.
     * |        |          |NOTE: This bit is cleared when both Tx_Over_IF and Rx_Over_IF are cleared. 
     * |[8]     |RDA_INT   |Receive Data Available Interrupt Indicator to Interrupt Controller (INT_RDA).
     * |        |          |An AND output with inputs of RDA_IEN and RDA_IF
     * |[9]     |THRE_INT  |Transmit Holding Register Empty Interrupt Indicator to Interrupt Controller (INT_THRE).
     * |        |          |An AND output with inputs of THRE_IEN and THRE_IF
     * |[10]    |RLS_INT   |Receive Line Status Interrupt Indicator to Interrupt Controller (INT_RLS). 
     * |        |          |An AND output with inputs of RLS_IEN and RLS_IF
     * |        |          |Note: In RS-485 mode, the field includes RS-485 Address Byte Detection Flag.
     * |[11]    |Modem_INT |MODEM Status Interrupt Indicator to Interrupt Controller (INT_MOS). 
     * |        |          |An AND output with inputs of Modem_IEN and Modem_IF
     * |[12]    |Tout_INT  |Time Out Interrupt Indicator to Interrupt Controller (INT_Tout)
     * |        |          |An AND output with inputs of RTO_IEN and Tout_IF
     * |[13]    |Buf_Err_INT|Buffer Error Interrupt Indicator to Interrupt Controller (INT_Buf_err)
     * |        |          |An AND output with inputs of BUF_ERR_IEN and Buf_Err_IF
     */    
    __IO uint32_t ISR;                  

    /**
     * TOR
     * ===================================================================================================
     * Offset: 0x20  UART Time Out Register
     * ---------------------------------------------------------------------------------------------------
     * |Bits    |Field     |Descriptions
     * | :----: | :----:   | :---- |
     * |[6:0]   |TOIC      |Time Out Interrupt Comparator
     * |        |          |The time out counter resets and starts counting (the counting clock = baud rate) whenever the RX FIFO 
     * |        |          |receives a new data word. Once the content of time out counter (TOUT_CNT) is equal to that of time out 
     * |        |          |interrupt comparator (TOIC), a receiver time out interrupt (INT_TOUT) is generated if UA_IER[RTO_IEN]. 
     * |        |          |A new incoming data word or RX FIFO empty clears INT_TOUT. 
     * |[15:8]  |DLY       |TX Delay time value
     * |        |          |This field is use to programming the transfer delay time between the last stop bit leaving the TX-FIFO 
     * |        |          |and the de-assertion of by setting UA_TOR. DLY register.
     */    
    __IO uint32_t TOR;                  

    /**
     * BAUD
     * ===================================================================================================
     * Offset: 0x24  UART Baud Rate Divisor Register
     * ---------------------------------------------------------------------------------------------------
     * |Bits    |Field     |Descriptions
     * | :----: | :----:   | :---- |
     * |[7:0]   |BRD_LowByte|Baud Rate Divider 
     * |        |          |The low byte of the baud rate divider
     * |[15:8]  |BRD_HighByte|Baud Rate Divider 
     * |        |          |The high byte of the baud rate divider
     * |[27:24] |Divider_X |Divider X
     * |        |          |The baud rate divider M = X+1.
     * |[28]    |DIV_X_ONE |Divider X equal 1
     * |        |          |0 = Divider M = X (the equation of M = X+1, but Divider_X[27:24] must > 8)
     * |        |          |1 = Divider M = 1 (the equation of M = 1, but BRD[15:0] must > 3).
     * |[29]    |DIV_X_EN  |Divider X Enable
     * |        |          |The BRD = Baud Rate Divider, and the baud rate equation is  
     * |        |          |Baud Rate = Clock / [ M * (BRD + 2) ] ; The default value of M is 16.
     * |        |          |0 = Disable divider X (the equation of M = 16)
     * |        |          |1 = Enable divider X (the equation of M = X+1, but Divider_X[27:24 must > 8).
     * |        |          |NOTE: When in IrDA mode, this bit must disable.
     */    
    __IO uint32_t BAUD;                 

    /**
     * IRCR
     * ===================================================================================================
     * Offset: 0x28  UART IrDA Control Register
     * ---------------------------------------------------------------------------------------------------
     * |Bits    |Field     |Descriptions
     * | :----: | :----:   | :---- |
     * |[1]     |Tx_SELECT |Tx_SELECT
     * |        |          |1: Enable IrDA transmitter
     * |        |          |0: Enable IrDA receiver
     * |[2]     |LB        |IrDA loop back mode for self test.
     * |        |          |1: Enable IrDA loop back mode
     * |        |          |0: Disable IrDA loop back mode
     * |[5]     |INV_Tx    |INV_Tx
     * |        |          |1= Inverse Tx output signal
     * |        |          |0= No inversion
     * |[6]     |INV_Rx    |INV_Rx
     * |        |          |1= Inverse Rx input signal
     * |        |          |0= No inversion
     */    
    __IO uint32_t IRCR;                 

    /**
     * ALT_CSR
     * ===================================================================================================
     * Offset: 0x2C  UART Alternate Control/Status Register
     * ---------------------------------------------------------------------------------------------------
     * |Bits    |Field     |Descriptions
     * | :----: | :----:   | :---- |
     * |[8]     |RS-485_NMM|RS-485 Normal Multi-drop Operation Mode (NMM)
     * |        |          |1: Enable RS-485 Normal Multi-drop Operation Mode (NMM)
     * |        |          |0: Disable RS-485 Normal Multi-drop Operation Mode (NMM)
     * |        |          |Note: It can't be active with RS-485_AAD operation mode.
     * |[9]     |RS-485_AAD|RS-485 Auto Address Detection Operation Mode (AAD)
     * |        |          |1: Enable RS-485 Auto Address Detection Operation Mode (AAD)
     * |        |          |0: Disable RS-485 Auto Address Detection Operation Mode (AAD)
     * |        |          |Note: It can't be active with RS-485_NMM operation mode.
     * |[10]    |RS-485_AUD|RS-485 Auto Direction Mode (AUD)
     * |        |          |1: Enable RS-485 Auto Direction Mode (AUD)
     * |        |          |0: Disable RS-485 Auto Direction Mode (AUD)
     * |        |          |Note: It can be active with RS-485_AAD or RS-485_NMM operation mode.
     * |[15]    |RS-485_Add_EN|RS-485 Address Detection Enable
     * |        |          |This bit is use to enable RS-485 address detection mode. 
     * |        |          |1: Enable address detection mode
     * |        |          |0: Disable address detection mode 
     * |        |          |Note: This field is used for RS-485 any operation mode.
     * |[31:24] |ADDR_MATCH|Address match value register
     * |        |          |This field contains the RS-485 address match values.
     * |        |          |Note: This field is used for RS-485 auto address detection mode.
     */    
    __IO uint32_t ALT_CSR;               

    /**
     * FUN_SEL
     * ===================================================================================================
     * Offset: 0x30  UART Function Select Register
     * ---------------------------------------------------------------------------------------------------
     * |Bits    |Field     |Descriptions
     * | :----: | :----:   | :---- |
     * |[1:0]   |FUN_SEL   |Function Select Enable
     * |        |          |00 = UART Function.
     * |        |          |01 = Reserved.
     * |        |          |10 = Enable IrDA Function.
     * |        |          |11 = Enable RS-485 Function.
     */    
    __IO uint32_t FUN_SEL;               
} UART_T;




/* UART THR Bit Field Definitions */
#define UART_THR_THR_Pos         0                                          /*!< UART THR: THR Position  */
#define UART_THR_THR_Msk        (0xFFul << UART_THR_THR_Pos)                 /*!< UART THR: THR Mask      */

/* UART RBR Bit Field Definitions */
#define UART_RBR_RBR_Pos         0                                          /*!< UART RBR: RBR Posistion */
#define UART_RBR_RBR_Msk        (0xFFul << UART_RBR_RBR_Pos)                 /*!< UART RBR: RBR Mask      */

/* UART IER Bit Field Definitions */
#define UART_IER_DMA_RX_EN_Pos      15                                      /*!< UART IER: RX DMA Enable Posistion */  
#define UART_IER_DMA_RX_EN_Msk      (1ul << UART_IER_DMA_RX_EN_Pos)         /*!< UART IER: RX DMA Enable Mask      */  

#define UART_IER_DMA_TX_EN_Pos      14                                      /*!< UART IER: TX DMA Enable Posistion */  
#define UART_IER_DMA_TX_EN_Msk      (1ul << UART_IER_DMA_TX_EN_Pos)         /*!< UART IER: TX DMA Enable Mask      */  

#define UART_IER_AUTO_CTS_EN_Pos    13                                      /*!< UART IER: AUTO_CTS_EN Posistion      */
#define UART_IER_AUTO_CTS_EN_Msk    (1ul << UART_IER_AUTO_CTS_EN_Pos)       /*!< UART IER: AUTO_CTS_EN Mask           */

#define UART_IER_AUTO_RTS_EN_Pos    12                                      /*!< UART IER: AUTO_RTS_EN Posistion      */
#define UART_IER_AUTO_RTS_EN_Msk    (1ul << UART_IER_AUTO_RTS_EN_Pos)       /*!< UART IER: AUTO_RTS_EN Mask           */

#define UART_IER_TIME_OUT_EN_Pos    11                                      /*!< UART IER: TIME_OUT_EN Posistion      */
#define UART_IER_TIME_OUT_EN_Msk    (1ul << UART_IER_TIME_OUT_EN_Pos)       /*!< UART IER: TIME_OUT_EN Mask           */

#define UART_IER_WAKE_EN_Pos        6                                       /*!< UART IER: WAKE_EN Posistion          */
#define UART_IER_WAKE_EN_Msk        (1ul << UART_IER_WAKE_EN_Pos)           /*!< UART IER: WAKE_EN Mask               */

#define UART_IER_BUF_ERR_IEN_Pos    5                                       /*!< UART IER: BUF_ERR_IEN Posistion      */
#define UART_IER_BUF_ERR_IEN_Msk    (1ul << UART_IER_BUF_ERR_IEN_Pos)       /*!< UART IER: BUF_ERR_IEN Mask           */

#define UART_IER_RTO_IEN_Pos        4                                       /*!< UART IER: RTO_IEN Posistion          */
#define UART_IER_RTO_IEN_Msk        (1ul << UART_IER_RTO_IEN_Pos)           /*!< UART IER: RTO_IEN Mask               */

#define UART_IER_MODEM_IEN_Pos      3                                       /*!< UART IER: MODEM_IEN Posistion        */
#define UART_IER_MODEM_IEN_Msk      (1ul << UART_IER_MODEM_IEN_Pos)         /*!< UART IER: MODEM_IEN Mask             */

#define UART_IER_RLS_IEN_Pos        2                                       /*!< UART IER: RLS_IEN Posistion          */
#define UART_IER_RLS_IEN_Msk        (1ul << UART_IER_RLS_IEN_Pos)           /*!< UART IER: RLS_IEN Mask               */

#define UART_IER_THRE_IEN_Pos       1                                       /*!< UART IER: THRE_IEN Posistion         */
#define UART_IER_THRE_IEN_Msk       (1ul << UART_IER_THRE_IEN_Pos)          /*!< UART IER: THRE_IEN Mask              */

#define UART_IER_RDA_IEN_Pos        0                                       /*!< UART IER: RDA_IEN Position           */
#define UART_IER_RDA_IEN_Msk        (1ul << UART_IER_RDA_IEN_Pos)           /*!< UART IER: RDA_IEN Mask               */

/* UART FCR Bit Field Definitions */
#define UART_FCR_RTS_TRI_LEV_Pos    16                                      /*!< UART FCR: RTS_TRI_LEV Position       */
#define UART_FCR_RTS_TRI_LEV_Msk    (0xFul << UART_FCR_RTS_TRI_LEV_Pos)     /*!< UART FCR: RTS_TRI_LEV Mask           */

#define UART_FCR_RX_DIS_Pos         8                                       /*!< UART FCR: RX_DIS Position            */
#define UART_FCR_RX_DIS_Msk         (1ul << UART_FCR_RX_DIS_Pos)            /*!< UART FCR: RX_DIS Mask                */

#define UART_FCR_RFITL_Pos          4                                       /*!< UART FCR: RFITL Position             */
#define UART_FCR_RFITL_Msk          (0xFul << UART_FCR_RFITL_Pos)           /*!< UART FCR: RFITL Mask                 */

#define UART_FCR_TFR_Pos            2                                       /*!< UART FCR: TFR Position               */
#define UART_FCR_TFR_Msk            (1ul << UART_FCR_TFR_Pos)               /*!< UART FCR: TFR Mask                   */

#define UART_FCR_RFR_Pos            1                                       /*!< UART FCR: RFR Position               */
#define UART_FCR_RFR_Msk            (1ul << UART_FCR_RFR_Pos)               /*!< UART FCR: RFR Mask                   */

/* UART LCR Bit Field Definitions */
#define UART_LCR_BCB_Pos            6                                       /*!< UART LCR: BCB Position               */
#define UART_LCR_BCB_Msk            (1ul << UART_LCR_BCB_Pos)               /*!< UART LCR: BCB Mask                   */

#define UART_LCR_SPE_Pos            5                                       /*!< UART LCR: SPE Position               */
#define UART_LCR_SPE_Msk            (1ul << UART_LCR_SPE_Pos)               /*!< UART LCR: SPE Mask                   */

#define UART_LCR_EPE_Pos            4                                       /*!< UART LCR: EPE Position               */
#define UART_LCR_EPE_Msk            (1ul << UART_LCR_EPE_Pos)               /*!< UART LCR: EPE Mask                   */

#define UART_LCR_PBE_Pos            3                                       /*!< UART LCR: PBE Position               */
#define UART_LCR_PBE_Msk            (1ul << UART_LCR_PBE_Pos)               /*!< UART LCR: PBE Mask                   */

#define UART_LCR_NSB_Pos            2                                       /*!< UART LCR: NSB Position               */
#define UART_LCR_NSB_Msk            (1ul << UART_LCR_NSB_Pos)               /*!< UART LCR: NSB Mask                   */

#define UART_LCR_WLS_Pos            0                                       /*!< UART LCR: WLS Position               */
#define UART_LCR_WLS_Msk            (0x3ul << UART_LCR_WLS_Pos)             /*!< UART LCR: WLS Mask                   */

/* UART MCR Bit Field Definitions */
#define UART_MCR_RTS_ST_Pos         13                                      /*!< UART MCR: RTS_ST Position            */
#define UART_MCR_RTS_ST_Msk         (1ul << UART_MCR_RTS_ST_Pos)            /*!< UART MCR: RTS_ST Mask                */

#define UART_MCR_LEV_RTS_Pos        9                                       /*!< UART MCR: LEV_RTS Position           */
#define UART_MCR_LEV_RTS_Msk        (1ul << UART_MCR_LEV_RTS_Pos)           /*!< UART MCR: LEV_RTS Mask               */

#define UART_MCR_RTS_Pos            1                                       /*!< UART MCR: RTS Position               */
#define UART_MCR_RTS_Msk            (1ul << UART_MCR_RTS_Pos)               /*!< UART MCR: RTS Mask                   */

/* UART MSR Bit Field Definitions */
#define UART_MSR_LEV_CTS_Pos        8                                       /*!< UART MSR: LEV_CTS Position           */
#define UART_MSR_LEV_CTS_Msk        (1ul << UART_MSR_LEV_CTS_Pos)           /*!< UART MSR: LEV_CTS Mask               */

#define UART_MSR_CTS_ST_Pos         4                                       /*!< UART MSR: CTS_ST Position            */
#define UART_MSR_CTS_ST_Msk         (1ul << UART_MSR_CTS_ST_Pos)            /*!< UART MSR: CTS_ST Mask                */

#define UART_MSR_DCTSF_Pos          0                                       /*!< UART MSR: DCTST Position             */
#define UART_MSR_DCTSF_Msk          (1ul << UART_MSR_DCTSF_Pos)             /*!< UART MSR: DCTST Mask                 */


/* UART FSR Bit Field Definitions */
#define UART_FSR_TE_FLAG_Pos        28                                      /*!< UART FSR: TE_FLAG Position           */
#define UART_FSR_TE_FLAG_Msk        (1ul << UART_FSR_TE_FLAG_Pos)           /*!< UART FSR: TE_FLAG Mask               */

#define UART_FSR_TX_OVER_IF_Pos     24                                      /*!< UART FSR: TX_OVER_IF Position        */
#define UART_FSR_TX_OVER_IF_Msk     (1ul << UART_FSR_TX_OVER_IF_Pos)        /*!< UART FSR: TX_OVER_IF Mask            */

#define UART_FSR_TX_FULL_Pos        23                                      /*!< UART FSR: TX_FULL Position           */
#define UART_FSR_TX_FULL_Msk        (1ul << UART_FSR_TX_FULL_Pos)           /*!< UART FSR: TX_FULL Mask               */

#define UART_FSR_TX_EMPTY_Pos       22                                      /*!< UART FSR: TX_EMPTY Position          */
#define UART_FSR_TX_EMPTY_Msk       (1ul << UART_FSR_TX_EMPTY_Pos)          /*!< UART FSR: TX_EMPTY Mask              */

#define UART_FSR_TX_POINTER_Pos     16                                      /*!< UART FSR: TX_POINTER Position        */
#define UART_FSR_TX_POINTER_Msk     (0x3Ful << UART_FSR_TX_POINTER_Pos)     /*!< UART FSR: TX_POINTER Mask            */

#define UART_FSR_RX_FULL_Pos        15                                      /*!< UART FSR: RX_FULL Position           */
#define UART_FSR_RX_FULL_Msk        (1ul << UART_FSR_RX_FULL_Pos)           /*!< UART FSR: RX_FULL Mask               */

#define UART_FSR_RX_EMPTY_Pos       14                                      /*!< UART FSR: RX_EMPTY Position          */
#define UART_FSR_RX_EMPTY_Msk       (1ul << UART_FSR_RX_EMPTY_Pos)          /*!< UART FSR: RX_EMPTY Mask              */

#define UART_FSR_RX_POINTER_Pos     8                                       /*!< UART FSR: RX_POINTERS Position       */
#define UART_FSR_RX_POINTER_Msk     (0x3Ful << UART_FSR_RX_POINTER_Pos)     /*!< UART FSR: RX_POINTER Mask            */

#define UART_FSR_BIF_Pos            6                                       /*!< UART FSR: BIF Position               */
#define UART_FSR_BIF_Msk            (1ul << UART_FSR_BIF_Pos)               /*!< UART FSR: BIF Mask                   */

#define UART_FSR_FEF_Pos            5                                       /*!< UART FSR: FEF Position               */
#define UART_FSR_FEF_Msk            (1ul << UART_FSR_FEF_Pos)               /*!< UART FSR: FEF Mask                   */

#define UART_FSR_PEF_Pos            4                                       /*!< UART FSR: PEF Position               */
#define UART_FSR_PEF_Msk            (1ul << UART_FSR_PEF_Pos)               /*!< UART FSR: PEF Mask                   */

#define UART_FSR_RS485_ADD_DETF_Pos 3                                       /*!< UART FSR: RS485_ADD_DETF Position    */
#define UART_FSR_RS485_ADD_DETF_Msk (1ul << UART_FSR_RS485_ADD_DETF_Pos)    /*!< UART FSR: RS485_ADD_DETF Mask        */

#define UART_FSR_RX_OVER_IF_Pos     0                                       /*!< UART FSR: RX_OVER_IF Position        */
#define UART_FSR_RX_OVER_IF_Msk     (1ul << UART_FSR_RX_OVER_IF_Pos)        /*!< UART FSR: RX_OVER_IF Mask            */

/* UART ISR Bit Field Definitions */
#define UART_ISR_HW_BUF_ERR_INT_Pos        29                                       /*!< UART ISR: HW BUF_ERR_INT Position       */
#define UART_ISR_HW_BUF_ERR_INT_Msk        (1ul << UART_ISR_HW_BUF_ERR_INT_Pos)     /*!< UART ISR: HW BUF_ERR_INT Mask           */

#define UART_ISR_HW_TOUT_INT_Pos           28                                       /*!< UART ISR: HW TOUT_INT Position          */
#define UART_ISR_HW_TOUT_INT_Msk           (1ul << UART_ISR_HW_TOUT_INT_Pos)        /*!< UART ISR: HW TOUT_INT Mask              */

#define UART_ISR_HW_MODEM_INT_Pos          27                                       /*!< UART ISR: HW MODEM_INT Position         */
#define UART_ISR_HW_MODEM_INT_Msk          (1ul << UART_ISR_HW_MODEM_INT_Pos)       /*!< UART ISR: HW MODEM_INT Mask             */
    
#define UART_ISR_HW_RLS_INT_Pos            26                                       /*!< UART ISR: HW RLS_INT Position           */
#define UART_ISR_HW_RLS_INT_Msk            (1ul << UART_ISR_HW_RLS_INT_Pos)         /*!< UART ISR: HW RLS_INT Position           */

#define UART_ISR_HW_BUF_ERR_IF_Pos         21                                       /*!< UART ISR: HW BUF_ERR_IF Position       */
#define UART_ISR_HW_BUF_ERR_IF_Msk         (1ul << UART_ISR_HW_BUF_ERR_IF_Pos)      /*!< UART ISR: HW BUF_ERR_IF Mask           */

#define UART_ISR_HW_TOUT_IF_Pos            20                                       /*!< UART ISR: HW TOUT_IF Position          */
#define UART_ISR_HW_TOUT_IF_Msk            (1ul << UART_ISR_HW_TOUT_IF_Pos)        /*!< UART ISR: HW TOUT_IF Mask              */

#define UART_ISR_HW_MODEM_IF_Pos           19                                       /*!< UART ISR: HW MODEM_IF Position         */
#define UART_ISR_HW_MODEM_IF_Msk           (1ul << UART_ISR_HW_MODEM_IF_Pos)        /*!< UART ISR: HW MODEM_IF Mask             */

#define UART_ISR_HW_RLS_IF_Pos             18                                       /*!< UART ISR: HW RLS_IF Position           */
#define UART_ISR_HW_RLS_IF_Msk             (1ul << UART_ISR_HW_RLS_IF_Pos)          /*!< UART ISR: HW RLS_IF Mark               */

#define UART_ISR_BUF_ERR_INT_Pos    13                                      /*!< UART ISR: BUF_ERR_INT Position       */
#define UART_ISR_BUF_ERR_INT_Msk    (1ul << UART_ISR_BUF_ERR_INT_Pos)       /*!< UART ISR: BUF_ERR_INT Mask           */

#define UART_ISR_TOUT_INT_Pos       12                                      /*!< UART ISR: TOUT_INT Position          */
#define UART_ISR_TOUT_INT_Msk       (1ul << UART_ISR_TOUT_INT_Pos)          /*!< UART ISR: TOUT_INT Mask              */

#define UART_ISR_MODEM_INT_Pos      11                                      /*!< UART ISR: MODEM_INT Position         */
#define UART_ISR_MODEM_INT_Msk      (1ul << UART_ISR_MODEM_INT_Pos)         /*!< UART ISR: MODEM_INT Mask             */

#define UART_ISR_RLS_INT_Pos        10                                      /*!< UART ISR: RLS_INT Position           */
#define UART_ISR_RLS_INT_Msk        (1ul << UART_ISR_RLS_INT_Pos)           /*!< UART ISR: RLS_INT Mask               */

#define UART_ISR_THRE_INT_Pos       9                                       /*!< UART ISR: THRE_INT Position          */
#define UART_ISR_THRE_INT_Msk       (1ul << UART_ISR_THRE_INT_Pos)          /*!< UART ISR: THRE_INT Mask              */

#define UART_ISR_RDA_INT_Pos        8                                       /*!< UART ISR: RDA_INT Position           */
#define UART_ISR_RDA_INT_Msk        (1ul << UART_ISR_RDA_INT_Pos)           /*!< UART ISR: RDA_INT Mask               */
           
#define UART_ISR_BUF_ERR_IF_Pos     5                                       /*!< UART ISR: BUF_ERR_IF Position        */
#define UART_ISR_BUF_ERR_IF_Msk     (1ul << UART_ISR_BUF_ERR_IF_Pos)        /*!< UART ISR: BUF_ERR_IF Mask            */

#define UART_ISR_TOUT_IF_Pos        4                                       /*!< UART ISR: TOUT_IF Position           */
#define UART_ISR_TOUT_IF_Msk        (1ul << UART_ISR_TOUT_IF_Pos)           /*!< UART ISR: TOUT_IF Mask               */

#define UART_ISR_MODEM_IF_Pos       3                                       /*!< UART ISR: MODEM_IF Position          */
#define UART_ISR_MODEM_IF_Msk       (1ul << UART_ISR_MODEM_IF_Pos)          /*!< UART ISR: MODEM_IF Mask              */

#define UART_ISR_RLS_IF_Pos         2                                       /*!< UART ISR: RLS_IF Position            */
#define UART_ISR_RLS_IF_Msk         (1ul << UART_ISR_RLS_IF_Pos)            /*!< UART ISR: RLS_IF Mask                */

#define UART_ISR_THRE_IF_Pos        1                                       /*!< UART ISR: THRE_IF Position           */
#define UART_ISR_THRE_IF_Msk        (1ul << UART_ISR_THRE_IF_Pos)           /*!< UART ISR: THRE_IF Mask               */

#define UART_ISR_RDA_IF_Pos         0                                       /*!< UART ISR: RDA_IF Position            */
#define UART_ISR_RDA_IF_Msk         (1ul << UART_ISR_RDA_IF_Pos)            /*!< UART ISR: RDA_IF Mask                */


/* UART TOR Bit Field Definitions */
#define UART_TOR_DLY_Pos           8                                        /*!< UART TOR: DLY Position               */
#define UART_TOR_DLY_Msk           (0xFFul << UART_TOR_DLY_Pos)             /*!< UART TOR: DLY Mask                   */

#define UART_TOR_TOIC_Pos          0                                        /*!< UART TOR: TOIC Position              */
#define UART_TOR_TOIC_Msk          (0xFFul << UART_TOR_TOIC_Pos)

/* UART BAUD Bit Field Definitions */
#define UART_BAUD_DIV_X_EN_Pos    29                                        /*!< UART BARD: DIV_X_EN Position         */
#define UART_BAUD_DIV_X_EN_Msk    (1ul << UART_BAUD_DIV_X_EN_Pos)           /*!< UART BARD: DIV_X_EN Mask             */

#define UART_BAUD_DIV_X_ONE_Pos   28                                        /*!< UART BARD: DIV_X_ONE Position        */
#define UART_BAUD_DIV_X_ONE_Msk   (1ul << UART_BAUD_DIV_X_ONE_Pos)          /*!< UART BARD: DIV_X_ONE Mask            */

#define UART_BAUD_DIVIDER_X_Pos   24                                        /*!< UART BARD: DIVIDER_X Position        */
#define UART_BAUD_DIVIDER_X_Msk   (0xFul << UART_BAUD_DIVIDER_X_Pos)        /*!< UART BARD: DIVIDER_X Mask            */

#define UART_BAUD_BRD_Pos         0                                         /*!< UART BARD: BRD Position              */
#define UART_BAUD_BRD_Msk         (0xFFFFul << UART_BAUD_BRD_Pos)           /*!< UART BARD: BRD Mask                  */

/* UART IRCR Bit Field Definitions */
#define UART_IRCR_INV_RX_Pos      6                                         /*!< UART IRCR: INV_RX Position           */
#define UART_IRCR_INV_RX_Msk     (1ul << UART_IRCR_INV_RX_Pos)              /*!< UART IRCR: INV_RX Mask               */

#define UART_IRCR_INV_TX_Pos      5                                         /*!< UART IRCR: INV_TX Position           */
#define UART_IRCR_INV_TX_Msk     (1ul << UART_IRCR_INV_TX_Pos)              /*!< UART IRCR: INV_TX Mask               */

#define UART_IRCR_TX_SELECT_Pos   1                                         /*!< UART IRCR: TX_SELECT Position        */
#define UART_IRCR_TX_SELECT_Msk   (1ul << UART_IRCR_TX_SELECT_Pos)          /*!< UART IRCR: TX_SELECT Mask            */

/* UART ALT_CSR Bit Field Definitions */
#define UART_ALT_CSR_ADDR_MATCH_Pos      24                                      /*!< UART ALT_CSR: ADDR_MATCH Position    */
#define UART_ALT_CSR_ADDR_MATCH_Msk     (0xFFul << UART_ALT_CSR_ADDR_MATCH_Pos)  /*!< UART ALT_CSR: ADDR_MATCH Mask        */

#define UART_ALT_CSR_RS485_ADD_EN_Pos   15                                       /*!< UART ALT_CSR: RS485_ADD_EN Position  */
#define UART_ALT_CSR_RS485_ADD_EN_Msk   (1ul << UART_ALT_CSR_RS485_ADD_EN_Pos)   /*!< UART ALT_CSR: RS485_ADD_EN Mask      */

#define UART_ALT_CSR_RS485_AUD_Pos      10                                       /*!< UART ALT_CSR: RS485_AUD Position     */
#define UART_ALT_CSR_RS485_AUD_Msk      (1ul << UART_ALT_CSR_RS485_AUD_Pos)      /*!< UART ALT_CSR: RS485_AUD Mask         */

#define UART_ALT_CSR_RS485_AAD_Pos      9                                        /*!< UART ALT_CSR: RS485_AAD Position     */
#define UART_ALT_CSR_RS485_AAD_Msk      (1ul << UART_ALT_CSR_RS485_AAD_Pos)      /*!< UART ALT_CSR: RS485_AAD Mask         */

#define UART_ALT_CSR_RS485_NMM_Pos      8                                        /*!< UART ALT_CSR: RS485_NMM Position     */
#define UART_ALT_CSR_RS485_NMM_Msk      (1ul << UART_ALT_CSR_RS485_NMM_Pos)      /*!< UART ALT_CSR: RS485_NMM Mask         */

/* UART FUN_SEL Bit Field Definitions */
#define UART_FUN_SEL_FUN_SEL_Pos        0                                        /*!< UART FUN_SEL: FUN_SEL Position       */
#define UART_FUN_SEL_FUN_SEL_Msk       (0x3ul << UART_FUN_SEL_FUN_SEL_Pos)       /*!< UART FUN_SEL: FUN_SEL Mask           */

/*@}*/ /* end of group NUC123_UART */

/*----------------------------- Timer Controller (TMR) -----------------------------*/
/** @addtogroup NUC123_TIMER NUC123 TIMER
  Memory Mapped Structure for NUC123 Series Timer Controller
  @{
 */
typedef struct
{
    /**
     * TCSR
     * ===================================================================================================
     * Offset: 0x00  Timer Control Register
     * ---------------------------------------------------------------------------------------------------
     */    
    __IO uint32_t  TCSR;                

    /**
     * TCMPR
     * ===================================================================================================
     * Offset: 0x04  Timer Compare Register
     * ---------------------------------------------------------------------------------------------------
     */    
    __IO uint32_t  TCMPR;		        

    /**
     * TISR
     * ===================================================================================================
     * Offset: 0x08  Timer Interrupt Status Register
     * ---------------------------------------------------------------------------------------------------
     */    
    __IO uint32_t  TISR;		        

    /**
     * TDR
     * ===================================================================================================
     * Offset: 0x0C  Timer Data Register
     * ---------------------------------------------------------------------------------------------------
     */    
    __I  uint32_t  TDR;			        

    /**
     * TCAP
     * ===================================================================================================
     * Offset: 0x10  Timer Capture Data Register
     * ---------------------------------------------------------------------------------------------------
     */    
    __I  uint32_t  TCAP;		        

    /**
     * TEXCON
     * ===================================================================================================
     * Offset: 0x14  Timer External Control Register
     * ---------------------------------------------------------------------------------------------------
     */    
    __IO uint32_t  TEXCON;	            

    /**
     * TEXISR
     * ===================================================================================================
     * Offset: 0x18  Timer External Interrupt Status Register
     * ---------------------------------------------------------------------------------------------------
     */    
    __IO uint32_t  TEXISR;	            
} TIMER_T;

/* TIMER TCSR Bit Field Definitions */
#define TIMER_TCSR_DBGACK_TMR_Pos   31											/*!< TIMER TCSR: DBGACK_TMR Position */
#define TIMER_TCSR_DBGACK_TMR_Msk   (1ul << TIMER_TCSR_DBGACK_TMR_Pos)          /*!< TIMER TCSR: DBGACK_TMR Mask */

#define TIMER_TCSR_CEN_Pos          30											/*!< TIMER TCSR: CEN Position */
#define TIMER_TCSR_CEN_Msk          (1ul << TIMER_TCSR_CEN_Pos)				    /*!< TIMER TCSR: CEN Mask */

#define TIMER_TCSR_IE_Pos           29											/*!< TIMER TCSR: IE Position */
#define TIMER_TCSR_IE_Msk           (1ul << TIMER_TCSR_IE_Pos)					/*!< TIMER TCSR: IE Mask */
                                                                                 
#define TIMER_TCSR_MODE_Pos         27											/*!< TIMER TCSR: MODE Position */
#define TIMER_TCSR_MODE_Msk         (0x3ul << TIMER_TCSR_MODE_Pos)				/*!< TIMER TCSR: MODE Mask */

#define TIMER_TCSR_CRST_Pos         26											/*!< TIMER TCSR: CRST Position */
#define TIMER_TCSR_CRST_Msk         (1ul << TIMER_TCSR_CRST_Pos)				/*!< TIMER TCSR: CRST Mask */

#define TIMER_TCSR_CACT_Pos         25											/*!< TIMER TCSR: CACT Position */
#define TIMER_TCSR_CACT_Msk         (1ul << TIMER_TCSR_CACT_Pos)				/*!< TIMER TCSR: CACT Mask */

#define TIMER_TCSR_CTB_Pos          24											/*!< TIMER TCSR: CTB Position */
#define TIMER_TCSR_CTB_Msk          (1ul << TIMER_TCSR_CTB_Pos)					/*!< TIMER TCSR: CTB Mask */

#define TIMER_TCSR_WAKE_EN_Pos      23											/*!< TIMER TCSR: WAKE_EN Position */
#define TIMER_TCSR_WAKE_EN_Msk      (1ul << TIMER_TCSR_WAKE_EN_Pos)			    /*!< TIMER TCSR: WAKE_EN Mask */

#define TIMER_TCSR_TDR_EN_Pos       16											/*!< TIMER TCSR: TDR_EN Position */
#define TIMER_TCSR_TDR_EN_Msk       (1ul << TIMER_TCSR_TDR_EN_Pos)				/*!< TIMER TCSR: TDR_EN Mask */

#define TIMER_TCSR_PRESCALE_Pos     0											/*!< TIMER TCSR: PRESCALE Position */
#define TIMER_TCSR_PRESCALE_Msk     (0xFFul << TIMER_TCSR_PRESCALE_Pos)			/*!< TIMER TCSR: PRESCALE Mask */

/* TIMER TCMPR Bit Field Definitions */
#define TIMER_TCMP_TCMP_Pos         0											/*!< TIMER TCMPR: TCMP Position */
#define TIMER_TCMP_TCMP_Msk         (0xFFFFFFul << TIMER_TCMP_TCMP_Pos)		    /*!< TIMER TCMPR: TCMP Mask */

/* TIMER TISR Bit Field Definitions */
#define TIMER_TISR_TWF_Pos          1											/*!< TIMER TISR: TWF Position */
#define TIMER_TISR_TWF_Msk          (1ul << TIMER_TISR_TWF_Pos)					/*!< TIMER TISR: TWF Mask */

#define TIMER_TISR_TIF_Pos          0											/*!< TIMER TISR: TIF Position */
#define TIMER_TISR_TIF_Msk          (1ul << TIMER_TISR_TIF_Pos)					/*!< TIMER TISR: TIF Mask */

/* TIMER TDR Bit Field Definitions */
#define TIMER_TDR_TDR_Pos           0								            /*!< TIMER TDR: TDR Position */
#define TIMER_TDR_TDR_Msk           (0xFFFFFFul << TIMER_TDR_TDR_Pos)	        /*!< TIMER TDR: TDR Mask */

/* TIMER TCAP Bit Field Definitions */
#define TIMER_TCAP_TCAP_Pos         0									        /*!< TIMER TCAP: TCAP Position */
#define TIMER_TCAP_TCAP_Msk         (0xFFFFFFul << TIMER_TCAP_TCAP_Pos)         /*!< TIMER TCAP: TCAP Mask */

/* TIMER TEXCON Bit Field Definitions */
#define TIMER_TEXCON_TCDB_Pos       7											/*!< TIMER TEXCON: TCDB Position */
#define TIMER_TEXCON_TCDB_Msk       (1ul << TIMER_TEXCON_TCDB_Pos)				/*!< TIMER TEXCON: TCDB Mask */

#define TIMER_TEXCON_TEXDB_Pos      6											/*!< TIMER TEXCON: TEXDB Position */
#define TIMER_TEXCON_TEXDB_Msk      (1ul << TIMER_TEXCON_TEXDB_Pos)				/*!< TIMER TEXCON: TEXDB Mask */

#define TIMER_TEXCON_TEXIEN_Pos     5											/*!< TIMER TEXCON: TEXIEN Position */
#define TIMER_TEXCON_TEXIEN_Msk     (1ul << TIMER_TEXCON_TEXIEN_Pos)			/*!< TIMER TEXCON: TEXIEN Mask */

#define TIMER_TEXCON_RSTCAPSEL_Pos  4											/*!< TIMER TEXCON: RSTCAPSEL Position */
#define TIMER_TEXCON_RSTCAPSEL_Msk  (1ul << TIMER_TEXCON_RSTCAPSEL_Pos)			/*!< TIMER TEXCON: RSTCAPSEL Mask */

#define TIMER_TEXCON_TEXEN_Pos      3											/*!< TIMER TEXCON: TEXEN Position */
#define TIMER_TEXCON_TEXEN_Msk      (1ul << TIMER_TEXCON_TEXEN_Pos)				/*!< TIMER TEXCON: TEXEN Mask */

#define TIMER_TEXCON_TEX_EDGE_Pos   1											/*!< TIMER TEXCON: TEX_EDGE Position */
#define TIMER_TEXCON_TEX_EDGE_Msk   (0x3ul << TIMER_TEXCON_TEX_EDGE_Pos)		/*!< TIMER TEXCON: TEX_EDGE Mask */

#define TIMER_TEXCON_TX_PHASE_Pos   0											/*!< TIMER TEXCON: TX_PHASE Position */
#define TIMER_TEXCON_TX_PHASE_Msk   (1ul << TIMER_TEXCON_TX_PHASE_Pos)			/*!< TIMER TEXCON: TX_PHASE Mask */

/* TIMER TEXISR Bit Field Definitions */
#define TIMER_TEXISR_TEXIF_Pos      0											/*!< TIMER TEXISR: TEXIF Position */
#define TIMER_TEXISR_TEXIF_Msk      (1ul << TIMER_TEXISR_TEXIF_Pos)				/*!< TIMER TEXISR: TEXIF Mask */
/*@}*/ /* end of group NUC123_TIMER */


/*----------------------------- Watchdog Timer (WDT) -----------------------------*/
/** @addtogroup NUC123_WDT NUC123 WDT
  Memory Mapped Structure for NUC123 Series Watchdog Timer
  @{
 */
typedef struct
{
    /**
     * WTCR
     * ===================================================================================================
     * Offset: 0x00  Watchdog Timer Control Register
     * ---------------------------------------------------------------------------------------------------
     */    
    __IO uint32_t  WTCR;                 

    /**
     * WTCRALT
     * ===================================================================================================
     * Offset: 0x04  Watchdog Timer Alternative Control Register
     * ---------------------------------------------------------------------------------------------------
     */    
    __IO uint32_t  WTCRALT;              
} WDT_T;

/* WDT WTCR Bit Field Definitions */
#define WDT_WTCR_DBGACK_WDT_Pos 31                                              /*!< WDT WTCR : DBGACK_WDT Position */
#define WDT_WTCR_DBGACK_WDT_Msk (1ul << WDT_WTCR_DBGACK_WDT_Pos)                /*!< WDT WTCR : DBGACK_WDT Mask */

#define WDT_WTCR_WTIS_Pos       8                                               /*!< WDT WTCR : WTIS Position */
#define WDT_WTCR_WTIS_Msk       (0x7ul << WDT_WTCR_WTIS_Pos)                    /*!< WDT WTCR : WTIS Mask */

#define WDT_WTCR_WTE_Pos        7                                               /*!< WDT WTCR : WTE Position */
#define WDT_WTCR_WTE_Msk        (1ul << WDT_WTCR_WTE_Pos)                       /*!< WDT WTCR : WTE Mask */

#define WDT_WTCR_WTIE_Pos       6                                               /*!< WDT WTCR : WTIE Position */
#define WDT_WTCR_WTIE_Msk       (1ul << WDT_WTCR_WTIE_Pos)                      /*!< WDT WTCR : WTIE Mask */

#define WDT_WTCR_WTWKF_Pos      5                                               /*!< WDT WTCR : WTWKF Position */
#define WDT_WTCR_WTWKF_Msk      (1ul << WDT_WTCR_WTWKF_Pos)                     /*!< WDT WTCR : WTWKF Mask */

#define WDT_WTCR_WTWKE_Pos      4                                               /*!< WDT WTCR : WTWKE Position */
#define WDT_WTCR_WTWKE_Msk      (1ul << WDT_WTCR_WTWKE_Pos)                     /*!< WDT WTCR : WTWKE Mask */

#define WDT_WTCR_WTIF_Pos       3                                               /*!< WDT WTCR : WTIF Position */
#define WDT_WTCR_WTIF_Msk       (1ul << WDT_WTCR_WTIF_Pos)                      /*!< WDT WTCR : WTIF Mask */

#define WDT_WTCR_WTRF_Pos       2                                               /*!< WDT WTCR : WTRF Position */
#define WDT_WTCR_WTRF_Msk       (1ul << WDT_WTCR_WTRF_Pos)                      /*!< WDT WTCR : WTRF Mask */

#define WDT_WTCR_WTRE_Pos       1                                               /*!< WDT WTCR : WTRE Position */
#define WDT_WTCR_WTRE_Msk       (1ul << WDT_WTCR_WTRE_Pos)                      /*!< WDT WTCR : WTRE Mask */

#define WDT_WTCR_WTR_Pos        0                                               /*!< WDT WTCR : WTR Position */
#define WDT_WTCR_WTR_Msk        (1ul << WDT_WTCR_WTR_Pos)                       /*!< WDT WTCR : WTR Mask */

/* WDT WTCRALT Bit Field Definitions */
#define WDT_WTCRALT_WTRDSEL_Pos 0                                               /*!< WDT WTCRALT : WTRDSEL Position */
#define WDT_WTCRALT_WTRDSEL_Msk (0x3ul << WDT_WTCRALT_WTRDSEL_Pos)              /*!< WDT WTCRALT : WTRDSEL Mask */
/*@}*/ /* end of group NUC123_WDT */


/*----------------------------- Window Watchdog Timer (WWDT) -----------------------------*/
/** @addtogroup NUC123_WWDT NUC123 WWDT
  Memory Mapped Structure for NUC123 Series Window Watchdog Timer
  @{
 */
typedef struct
{
    /**
     * WWDTRLD
     * ===================================================================================================
     * Offset: 0x00  Window Watchdog Timer Reload Counter Register
     * ---------------------------------------------------------------------------------------------------
     */    
    __IO uint32_t  WWDTRLD;

    /**
     * WWDTCR
     * ===================================================================================================
     * Offset: 0x04  Window Watchdog Timer Control Register
     * ---------------------------------------------------------------------------------------------------
     */    
    __IO uint32_t  WWDTCR;

    /**
     * WWDTSR
     * ===================================================================================================
     * Offset: 0x08  Window Watchdog Timer Status Register
     * ---------------------------------------------------------------------------------------------------
     */    
    __IO uint32_t  WWDTSR;

    /**
     * WWDTCVR
     * ===================================================================================================
     * Offset: 0x0C  Window Watchdog Timer Counter Value Register
     * ---------------------------------------------------------------------------------------------------
     */    
    __I  uint32_t  WWDTCVR;
} WWDT_T;

/* WWDT WWDTRLD Bit Field Definitions */
#define WWDT_WWDTRLD_WWDTRLD_Pos    0                                           /*!< WWDT WWDTRLD : WWDTRLD Position */
#define WWDT_WWDTRLD_WWDTRLD_Msk    (0xFFFFFFFFul << WWDT_WWDTRLD_WWDTRLD_Pos)  /*!< WWDT WWDTRLD : WWDTRLD Mask */

/* WWDT WWDTCR Bit Field Definitions */
#define WWDT_WWDTCR_DBGACK_WWDT_Pos 31                                          /*!< WWDT WWDTCR : DBGACK_WWDT Position */
#define WWDT_WWDTCR_DBGACK_WWDT_Msk (1ul << WWDT_WWDTCR_DBGACK_WWDT_Pos)        /*!< WWDT WWDTCR : DBGACK_WWDT Mask */

#define WWDT_WWDTCR_WINCMP_Pos      16                                          /*!< WWDT WWDTCR : WINCMP Position */
#define WWDT_WWDTCR_WINCMP_Msk      (0x3Ful << WWDT_WWDTCR_WINCMP_Pos)          /*!< WWDT WWDTCR : WINCMP Mask */

#define WWDT_WWDTCR_PERIODSEL_Pos   8                                           /*!< WWDT WWDTCR : PERIODSEL Position */
#define WWDT_WWDTCR_PERIODSEL_Msk   (0xFul << WWDT_WWDTCR_PERIODSEL_Pos)        /*!< WWDT WWDTCR : PERIODSEL Mask */

#define WWDT_WWDTCR_WWDTIE_Pos      1                                           /*!< WWDT WWDTCR : WWDTIE Position */
#define WWDT_WWDTCR_WWDTIE_Msk      (1ul << WWDT_WWDTCR_WWDTIE_Pos)             /*!< WWDT WWDTCR : WWDTIE Mask */

#define WWDT_WWDTCR_WWDTEN_Pos      0                                           /*!< WWDT WWDTCR : WWDTEN Position */
#define WWDT_WWDTCR_WWDTEN_Msk      (1ul << WWDT_WWDTCR_WWDTEN_Pos)             /*!< WWDT WWDTCR : WWDTEN Mask */

/* WWDT WWDTSR Bit Field Definitions */
#define WWDT_WWDTSR_WWDTRF_Pos      1                                           /*!< WWDT WWDTSR : WWDTRF Position */
#define WWDT_WWDTSR_WWDTRF_Msk      (1ul << WWDT_WWDTSR_WWDTRF_Pos)             /*!< WWDT WWDTSR : WWDTRF Mask */

#define WWDT_WWDTSR_WWDTIF_Pos      0                                           /*!< WWDT WWDTSR : WWDTIF Position */
#define WWDT_WWDTSR_WWDTIF_Msk      (1ul << WWDT_WWDTSR_WWDTIF_Pos)             /*!< WWDT WWDTSR : WWDTIF Mask */

/* WWDT WWDTCVR Bit Field Definitions */
#define WWDT_WWDTCVR_WWDTCVAL_Pos   0                                           /*!< WWDT WWDTCVR : WWDTRF Position */
#define WWDT_WWDTCVR_WWDTCVAL_Msk   (0x3Ful << WWDT_WWDTCVR_WWDTCVAL_Pos)       /*!< WWDT WWDTCVR : WWDTRF Mask */
/*@}*/ /* end of group NUC123_WWDT */


/*------------------------- SPI Interface Controller -------------------------*/
/** @addtogroup NUC123_SPI NUC123 SPI
  Memory Mapped Structure for NUC123 Series SPI Controller
  @{
 */
typedef struct
{
    __IO uint32_t CNTRL;      /*!< Offset: 0x00  SPI Control and Status Register   */
    __IO uint32_t DIVIDER;    /*!< Offset: 0x04  SPI Clock Divider Register        */
    __IO uint32_t SSR;        /*!< Offset: 0x08  SPI Slave Select Register         */
    __I  uint32_t RESERVE0;
    __I  uint32_t RX[2];      /*!< Offset: 0x10  Data Receive Register             */
    __I  uint32_t RESERVE1;
    __I  uint32_t RESERVE2;
    __O  uint32_t TX[2];      /*!< Offset: 0x20  Data Transmit Register            */
    __I  uint32_t RESERVE3;
    __I  uint32_t RESERVE4;
    __I  uint32_t RESERVE5;
    __IO uint32_t VARCLK;     /*!< Offset: 0x34  Variable Clock Pattern Register   */
    __IO uint32_t DMA;        /*!< Offset: 0x38  SPI DMA Control Register          */
    __IO uint32_t CNTRL2;     /*!< Offset: 0x3C  SPI Control and Status Register 2 */
    __IO uint32_t FIFO_CTL;   /*!< Offset: 0x40  SPI FIFO Control Register         */
    __IO uint32_t STATUS;     /*!< Offset: 0x44  SPI Status Register               */
} SPI_T;


/* SPI_CNTRL Bit Field Definitions */
#define SPI_CNTRL_TX_FULL_Pos      27                                     /*!< SPI CNTRL: TX_FULL Position */
#define SPI_CNTRL_TX_FULL_Msk      (1ul << SPI_CNTRL_TX_FULL_Pos)         /*!< SPI CNTRL: TX_FULL Mask     */

#define SPI_CNTRL_TX_EMPTY_Pos     26                                     /*!< SPI CNTRL: TX_EMPTY Position */
#define SPI_CNTRL_TX_EMPTY_Msk     (1ul << SPI_CNTRL_TX_EMPTY_Pos)        /*!< SPI CNTRL: TX_EMPTY Mask     */

#define SPI_CNTRL_RX_FULL_Pos      25                                     /*!< SPI CNTRL: RX_FULL Position */
#define SPI_CNTRL_RX_FULL_Msk      (1ul << SPI_CNTRL_RX_FULL_Pos)         /*!< SPI CNTRL: RX_FULL Mask     */

#define SPI_CNTRL_RX_EMPTY_Pos     24                                     /*!< SPI CNTRL: RX_EMPTY Position */
#define SPI_CNTRL_RX_EMPTY_Msk     (1ul << SPI_CNTRL_RX_EMPTY_Pos)        /*!< SPI CNTRL: RX_EMPTY Mask     */

#define SPI_CNTRL_VARCLK_EN_Pos    23                                     /*!< SPI CNTRL: VARCLK_EN Position */
#define SPI_CNTRL_VARCLK_EN_Msk    (1ul << SPI_CNTRL_VARCLK_EN_Pos)       /*!< SPI CNTRL: VARCLK_EN Mask     */

#define SPI_CNTRL_TWOB_Pos         22                                     /*!< SPI CNTRL: TWOB Position */
#define SPI_CNTRL_TWOB_Msk         (1ul << SPI_CNTRL_TWOB_Pos)            /*!< SPI CNTRL: TWOB Mask     */

#define SPI_CNTRL_FIFO_Pos         21                                     /*!< SPI CNTRL: FIFO Position */
#define SPI_CNTRL_FIFO_Msk         (1ul << SPI_CNTRL_FIFO_Pos)            /*!< SPI CNTRL: FIFO Mask     */

#define SPI_CNTRL_REORDER_Pos      19                                     /*!< SPI CNTRL: REORDER Position */
#define SPI_CNTRL_REORDER_Msk      (1ul << SPI_CNTRL_REORDER_Pos)         /*!< SPI CNTRL: REORDER Mask     */

#define SPI_CNTRL_SLAVE_Pos        18                                     /*!< SPI CNTRL: SLAVE Position */
#define SPI_CNTRL_SLAVE_Msk        (1ul << SPI_CNTRL_SLAVE_Pos)           /*!< SPI CNTRL: SLAVE Mask     */

#define SPI_CNTRL_IE_Pos           17                                     /*!< SPI CNTRL: IE Position */
#define SPI_CNTRL_IE_Msk           (1ul << SPI_CNTRL_IE_Pos)              /*!< SPI CNTRL: IE Mask     */

#define SPI_CNTRL_IF_Pos           16                                     /*!< SPI CNTRL: IF Position */
#define SPI_CNTRL_IF_Msk           (1ul << SPI_CNTRL_IF_Pos)              /*!< SPI CNTRL: IF Mask     */

#define SPI_CNTRL_SP_CYCLE_Pos     12                                     /*!< SPI CNTRL: SP_CYCLE Position */
#define SPI_CNTRL_SP_CYCLE_Msk     (0xFul << SPI_CNTRL_SP_CYCLE_Pos)      /*!< SPI CNTRL: SP_CYCLE Mask     */

#define SPI_CNTRL_CLKP_Pos         11                                     /*!< SPI CNTRL: CLKP Position */
#define SPI_CNTRL_CLKP_Msk         (1ul << SPI_CNTRL_CLKP_Pos)            /*!< SPI CNTRL: CLKP Mask     */

#define SPI_CNTRL_LSB_Pos          10                                     /*!< SPI CNTRL: LSB Position */
#define SPI_CNTRL_LSB_Msk          (1ul << SPI_CNTRL_LSB_Pos)             /*!< SPI CNTRL: LSB Mask     */

#define SPI_CNTRL_TX_BIT_LEN_Pos   3                                      /*!< SPI CNTRL: TX_BIT_LEN Position */
#define SPI_CNTRL_TX_BIT_LEN_Msk   (0x1Ful << SPI_CNTRL_TX_BIT_LEN_Pos)   /*!< SPI CNTRL: TX_BIT_LEN Mask     */

#define SPI_CNTRL_TX_NEG_Pos       2                                      /*!< SPI CNTRL: TX_NEG Position */
#define SPI_CNTRL_TX_NEG_Msk       (1ul << SPI_CNTRL_TX_NEG_Pos)          /*!< SPI CNTRL: TX_NEG Mask     */

#define SPI_CNTRL_RX_NEG_Pos       1                                      /*!< SPI CNTRL: RX_NEG Position */
#define SPI_CNTRL_RX_NEG_Msk       (1ul << SPI_CNTRL_RX_NEG_Pos)          /*!< SPI CNTRL: RX_NEG Mask     */

#define SPI_CNTRL_GO_BUSY_Pos      0                                      /*!< SPI CNTRL: GO_BUSY Position */
#define SPI_CNTRL_GO_BUSY_Msk      (1ul << SPI_CNTRL_GO_BUSY_Pos)         /*!< SPI CNTRL: GO_BUSY Mask     */

/* SPI_DIVIDER Bit Field Definitions */
#define SPI_DIVIDER_DIVIDER2_Pos   16                                     /*!< SPI DIVIDER: DIVIDER2 Position */
#define SPI_DIVIDER_DIVIDER2_Msk   (0xFFul << SPI_DIVIDER_DIVIDER2_Pos)   /*!< SPI DIVIDER: DIVIDER2 Mask */

#define SPI_DIVIDER_DIVIDER_Pos    0                                      /*!< SPI DIVIDER: DIVIDER Position */
#define SPI_DIVIDER_DIVIDER_Msk    (0xFFul << SPI_DIVIDER_DIVIDER_Pos)    /*!< SPI DIVIDER: DIVIDER Mask */

/* SPI_SSR Bit Field Definitions */
#define SPI_SSR_LTRIG_FLAG_Pos     5                                 /*!< SPI SSR: LTRIG_FLAG Position */
#define SPI_SSR_LTRIG_FLAG_Msk     (1ul << SPI_SSR_LTRIG_FLAG_Pos)   /*!< SPI SSR: LTRIG_FLAG Mask */

#define SPI_SSR_SS_LTRIG_Pos       4                                 /*!< SPI SSR: SS_LTRIG Position */
#define SPI_SSR_SS_LTRIG_Msk       (1ul << SPI_SSR_SS_LTRIG_Pos)     /*!< SPI SSR: SS_LTRIG Mask */

#define SPI_SSR_AUTOSS_Pos         3                                 /*!< SPI SSR: AUTOSS Position */
#define SPI_SSR_AUTOSS_Msk         (1ul << SPI_SSR_AUTOSS_Pos)       /*!< SPI SSR: AUTOSS Mask */

#define SPI_SSR_SS_LVL_Pos         2                                 /*!< SPI SSR: SS_LVL Position */
#define SPI_SSR_SS_LVL_Msk         (1ul << SPI_SSR_SS_LVL_Pos)       /*!< SPI SSR: SS_LVL Mask */

#define SPI_SSR_SSR_Pos            0                                 /*!< SPI SSR: SSR Position */
#define SPI_SSR_SSR_Msk            (3ul << SPI_SSR_SSR_Pos)          /*!< SPI SSR: SSR Mask */

/* SPI_DMA Bit Field Definitions */
#define SPI_DMA_PDMA_RST_Pos   2                                     /*!< SPI DMA: PDMA_RST Position */
#define SPI_DMA_PDMA_RST_Msk   (1ul << SPI_DMA_PDMA_RST_Pos)         /*!< SPI DMA: PDMA_RST Mask */

#define SPI_DMA_RX_DMA_GO_Pos   1                                    /*!< SPI DMA: RX_DMA_GO Position */
#define SPI_DMA_RX_DMA_GO_Msk   (1ul << SPI_DMA_RX_DMA_GO_Pos)       /*!< SPI DMA: RX_DMA_GO Mask */

#define SPI_DMA_TX_DMA_GO_Pos   0                                    /*!< SPI DMA: TX_DMA_GO Position */
#define SPI_DMA_TX_DMA_GO_Msk   (1ul << SPI_DMA_TX_DMA_GO_Pos)       /*!< SPI DMA: TX_DMA_GO Mask */

/* SPI_CNTRL2 Bit Field Definitions */
#define SPI_CNTRL2_BCn_Pos   31                                                      /*!< SPI CNTRL2: BCn Position */
#define SPI_CNTRL2_BCn_Msk   (1ul << SPI_CNTRL2_BCn_Pos)                             /*!< SPI CNTRL2: BCn Mask */

#define SPI_CNTRL2_SS_INT_OPT_Pos   16                                               /*!< SPI CNTRL2: SS_INT_OPT Position */
#define SPI_CNTRL2_SS_INT_OPT_Msk   (1ul << SPI_CNTRL2_SS_INT_OPT_Pos)               /*!< SPI CNTRL2: SS_INT_OPT Mask */

#define SPI_CNTRL2_DUAL_IO_EN_Pos   13                                               /*!< SPI CNTRL2: DUAL_IO_EN Position */
#define SPI_CNTRL2_DUAL_IO_EN_Msk   (1ul << SPI_CNTRL2_DUAL_IO_EN_Pos)               /*!< SPI CNTRL2: DUAL_IO_EN Mask */

#define SPI_CNTRL2_DUAL_IO_DIR_Pos   12                                              /*!< SPI CNTRL2: DUAL_IO_DIR Position */
#define SPI_CNTRL2_DUAL_IO_DIR_Msk   (1ul << SPI_CNTRL2_DUAL_IO_DIR_Pos)             /*!< SPI CNTRL2: DUAL_IO_DIR Mask */

#define SPI_CNTRL2_SLV_START_INTSTS_Pos   11                                         /*!< SPI CNTRL2: SLV_START_INTSTS Position */
#define SPI_CNTRL2_SLV_START_INTSTS_Msk   (1ul << SPI_CNTRL2_SLV_START_INTSTS_Pos)   /*!< SPI CNTRL2: SLV_START_INTSTS Mask */

#define SPI_CNTRL2_SSTA_INTEN_Pos   10                                               /*!< SPI CNTRL2: SSTA_INTEN Position */
#define SPI_CNTRL2_SSTA_INTEN_Msk   (1ul << SPI_CNTRL2_SSTA_INTEN_Pos)               /*!< SPI CNTRL2: SSTA_INTEN Mask */

#define SPI_CNTRL2_SLV_ABORT_Pos    9                                                /*!< SPI CNTRL2: SLV_ABORT Position */
#define SPI_CNTRL2_SLV_ABORT_Msk    (1ul << SPI_CNTRL2_SLV_ABORT_Pos)                /*!< SPI CNTRL2: SLV_ABORT Mask */

#define SPI_CNTRL2_NOSLVSEL_Pos     8                                                /*!< SPI CNTRL2: NOSLVSEL Position */
#define SPI_CNTRL2_NOSLVSEL_Msk     (1ul << SPI_CNTRL2_NOSLVSEL_Pos)                 /*!< SPI CNTRL2: NOSLVSEL Mask */

/* SPI_FIFO_CTL Bit Field Definitions */
#define SPI_FIFO_CTL_TX_THRESHOLD_Pos   28                                         /*!< SPI FIFO_CTL: TX_THRESHOLD Position */
#define SPI_FIFO_CTL_TX_THRESHOLD_Msk   (7ul << SPI_FIFO_CTL_TX_THRESHOLD_Pos)     /*!< SPI FIFO_CTL: TX_THRESHOLD Mask */

#define SPI_FIFO_CTL_RX_THRESHOLD_Pos   24                                         /*!< SPI FIFO_CTL: RX_THRESHOLD Position */
#define SPI_FIFO_CTL_RX_THRESHOLD_Msk   (7ul << SPI_FIFO_CTL_RX_THRESHOLD_Pos)     /*!< SPI FIFO_CTL: RX_THRESHOLD Mask */

#define SPI_FIFO_CTL_TIMEOUT_INTEN_Pos   21                                        /*!< SPI FIFO_CTL: TIMEOUT_INTEN Position */
#define SPI_FIFO_CTL_TIMEOUT_INTEN_Msk   (1ul << SPI_FIFO_CTL_TIMEOUT_INTEN_Pos)   /*!< SPI FIFO_CTL: TIMEOUT_INTEN Mask */

#define SPI_FIFO_CTL_RXOV_INTEN_Pos    6                                           /*!< SPI FIFO_CTL: RXOV_INTEN Position */
#define SPI_FIFO_CTL_RXOV_INTEN_Msk    (1ul << SPI_FIFO_CTL_RXOV_INTEN_Pos)        /*!< SPI FIFO_CTL: RXOV_INTEN Mask */

#define SPI_FIFO_CTL_TX_INTEN_Pos    3                                             /*!< SPI FIFO_CTL: TX_INTEN Position */
#define SPI_FIFO_CTL_TX_INTEN_Msk    (1ul << SPI_FIFO_CTL_TX_INTEN_Pos)            /*!< SPI FIFO_CTL: TX_INTEN Mask */

#define SPI_FIFO_CTL_RX_INTEN_Pos    2                                             /*!< SPI FIFO_CTL: RX_INTEN Position */
#define SPI_FIFO_CTL_RX_INTEN_Msk    (1ul << SPI_FIFO_CTL_RX_INTEN_Pos)            /*!< SPI FIFO_CTL: RX_INTEN Mask */

#define SPI_FIFO_CTL_TX_CLR_Pos     1                                              /*!< SPI FIFO_CTL: TX_CLR Position */
#define SPI_FIFO_CTL_TX_CLR_Msk     (1ul << SPI_FIFO_CTL_TX_CLR_Pos)               /*!< SPI FIFO_CTL: TX_CLR Mask */

#define SPI_FIFO_CTL_RX_CLR_Pos      0                                             /*!< SPI FIFO_CTL: RX_CLR Position */
#define SPI_FIFO_CTL_RX_CLR_Msk      (1ul << SPI_FIFO_CTL_RX_CLR_Pos)              /*!< SPI FIFO_CTL: RX_CLR Mask */

/* SPI_STATUS Bit Field Definitions */
#define SPI_STATUS_TX_FIFO_COUNT_Pos   28                                            /*!< SPI STATUS: TX_FIFO_COUNT Position */
#define SPI_STATUS_TX_FIFO_COUNT_Msk   (0xFul << SPI_STATUS_TX_FIFO_COUNT_Pos)       /*!< SPI STATUS: TX_FIFO_COUNT Mask */

#define SPI_STATUS_TX_FULL_Pos   27                                                  /*!< SPI STATUS: TX_FULL Position */
#define SPI_STATUS_TX_FULL_Msk   (1ul << SPI_STATUS_TX_FULL_Pos)                     /*!< SPI STATUS: TX_FULL Mask */

#define SPI_STATUS_TX_EMPTY_Pos   26                                                 /*!< SPI STATUS: TX_EMPTY Position */
#define SPI_STATUS_TX_EMPTY_Msk   (1ul << SPI_STATUS_TX_EMPTY_Pos)                   /*!< SPI STATUS: TX_EMPTY Mask */

#define SPI_STATUS_RX_FULL_Pos   25                                                  /*!< SPI STATUS: RX_FULL Position */
#define SPI_STATUS_RX_FULL_Msk   (1ul << SPI_STATUS_RX_FULL_Pos)                     /*!< SPI STATUS: RX_FULL Mask */

#define SPI_STATUS_RX_EMPTY_Pos   24                                                 /*!< SPI STATUS: RX_EMPTY Position */
#define SPI_STATUS_RX_EMPTY_Msk   (1ul << SPI_STATUS_RX_EMPTY_Pos)                   /*!< SPI STATUS: RX_EMPTY Mask */

#define SPI_STATUS_TIMEOUT_Pos   20                                                  /*!< SPI STATUS: TIMEOUT Position */
#define SPI_STATUS_TIMEOUT_Msk   (1ul << SPI_STATUS_TIMEOUT_Pos)                     /*!< SPI STATUS: TIMEOUT Mask */

#define SPI_STATUS_IF_Pos   16                                                       /*!< SPI STATUS: IF Position */
#define SPI_STATUS_IF_Msk   (1ul << SPI_STATUS_IF_Pos)                               /*!< SPI STATUS: IF Mask     */

#define SPI_STATUS_RX_FIFO_COUNT_Pos   12                                            /*!< SPI STATUS: RX_FIFO_COUNT Position */
#define SPI_STATUS_RX_FIFO_COUNT_Msk   (0xFul << SPI_STATUS_RX_FIFO_COUNT_Pos)       /*!< SPI STATUS: RX_FIFO_COUNT Mask */

#define SPI_STATUS_SLV_START_INTSTS_Pos   11                                         /*!< SPI STATUS: SLV_START_INTSTS Position */
#define SPI_STATUS_SLV_START_INTSTS_Msk   (1ul << SPI_STATUS_SLV_START_INTSTS_Pos)   /*!< SPI STATUS: SLV_START_INTSTS Mask */

#define SPI_STATUS_TX_INTSTS_Pos   4                                                 /*!< SPI STATUS: TX_INTSTS Position */
#define SPI_STATUS_TX_INTSTS_Msk   (1ul << SPI_STATUS_TX_INTSTS_Pos)                 /*!< SPI STATUS: TX_INTSTS Mask */

#define SPI_STATUS_RX_OVERRUN_Pos   2                                                /*!< SPI STATUS: RX_OVERRUN Position */
#define SPI_STATUS_RX_OVERRUN_Msk   (1ul << SPI_STATUS_RX_OVERRUN_Pos)               /*!< SPI STATUS: RX_OVERRUN Mask */

#define SPI_STATUS_RX_INTSTS_Pos   0                                                 /*!< SPI STATUS: RX_INTSTS Position */
#define SPI_STATUS_RX_INTSTS_Msk   (1ul << SPI_STATUS_RX_INTSTS_Pos)                 /*!< SPI STATUS: RX_INTSTS Mask */

/*@}*/ /* end of group NUC123_SPI */
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
