475241512/BT_Printer/FW/src/App/AsciiLib_6x12.h

unsigned char const AsciiLib_6x12[] ={
	0x00, 0x00, 0x00, 0x00, 0x00, 0x00, 0x00, 0x00, 0x00, 0x00, 0x00, 0x00, 
	0x00, 0x00, 0x10, 0x10, 0x10, 0x10, 0x10, 0x10, 0x10, 0x00, 0x10, 0x00, 
	0x00, 0x28, 0x50, 0x50, 0x00, 0x00, 0x00, 0x00, 0x00, 0x00, 0x00, 0x00, 
	0x00, 0x00, 0x28, 0x28, 0xFC, 0x28, 0x48, 0x50, 0xFC, 0x50, 0x50, 0x00, 
	0x00, 0x10, 0x3C, 0x54, 0x50, 0x30, 0x18, 0x14, 0x54, 0x54, 0x38, 0x10, 
	0x00, 0x00, 0x44, 0xA8, 0xA8, 0xB0, 0x68, 0x34, 0x54, 0x54, 0x88, 0x00, 
	0x00, 0x00, 0x20, 0x50, 0x50, 0x60, 0x58, 0xA8, 0xA8, 0x90, 0x6C, 0x00, 
	0x00, 0x60, 0x20, 0x40, 0x00, 0x00, 0x00, 0x00, 0x00, 0x00, 0x00, 0x00, 
	0x00, 0x04, 0x08, 0x08, 0x10, 0x10, 0x10, 0x10, 0x10, 0x08, 0x08, 0x04, 
	0x00, 0x40, 0x20, 0x20, 0x10, 0x10, 0x10, 0x10, 0x10, 0x20, 0x20, 0x40, 
	0x00, 0x00, 0x00, 0x00, 0x10, 0x54, 0x38, 0x38, 0x54, 0x10, 0x00, 0x00, 
	0x00, 0x00, 0x00, 0x10, 0x10, 0x10, 0xFC, 0x10, 0x10, 0x10, 0x00, 0x00, 
	0x00, 0x00, 0x00, 0x00, 0x00, 0x00, 0x00, 0x00, 0x00, 0x60, 0x60, 0x20, 
	0x00, 0x00, 0x00, 0x00, 0x00, 0x00, 0xFC, 0x00, 0x00, 0x00, 0x00, 0x00, 
	0x00, 0x00, 0x00, 0x00, 0x00, 0x00, 0x00, 0x00, 0x00, 0x60, 0x60, 0x00, 
	0x00, 0x04, 0x08, 0x08, 0x10, 0x10, 0x20, 0x20, 0x40, 0x40, 0x80, 0x80, 
	0x00, 0x00, 0x38, 0x44, 0x44, 0x44, 0x44, 0x44, 0x44, 0x44, 0x38, 0x00, 
	0x00, 0x00, 0x10, 0x30, 0x10, 0x10, 0x10, 0x10, 0x10, 0x10, 0x38, 0x00, 
	0x00, 0x00, 0x38, 0x44, 0x44, 0x04, 0x08, 0x10, 0x20, 0x40, 0x7C, 0x00, 
	0x00, 0x00, 0x38, 0x44, 0x04, 0x18, 0x04, 0x04, 0x04, 0x44, 0x38, 0x00, 
	0x00, 0x00, 0x08, 0x18, 0x28, 0x48, 0x48, 0x88, 0x78, 0x08, 0x1C, 0x00, 
	0x00, 0x00, 0x7C, 0x40, 0x40, 0x78, 0x44, 0x04, 0x44, 0x44, 0x38, 0x00, 
	0x00, 0x00, 0x1C, 0x24, 0x40, 0x58, 0x64, 0x44, 0x44, 0x44, 0x38, 0x00, 
	0x00, 0x00, 0x7C, 0x48, 0x08, 0x08, 0x10, 0x10, 0x10, 0x10, 0x10, 0x00, 
	0x00, 0x00, 0x38, 0x44, 0x44, 0x28, 0x38, 0x44, 0x44, 0x44, 0x38, 0x00, 
	0x00, 0x00, 0x38, 0x44, 0x44, 0x44, 0x4C, 0x34, 0x04, 0x48, 0x70, 0x00, 
	0x00, 0x00, 0x00, 0x00, 0x00, 0x30, 0x30, 0x00, 0x00, 0x30, 0x30, 0x00, 
	0x00, 0x00, 0x00, 0x00, 0x00, 0x10, 0x00, 0x00, 0x00, 0x00, 0x10, 0x10, 
	0x00, 0x00, 0x04, 0x08, 0x10, 0x20, 0x40, 0x20, 0x10, 0x08, 0x04, 0x00, 
	0x00, 0x00, 0x00, 0x00, 0x00, 0xFC, 0x00, 0x00, 0xFC, 0x00, 0x00, 0x00, 
	0x00, 0x00, 0x40, 0x20, 0x10, 0x08, 0x04, 0x08, 0x10, 0x20, 0x40, 0x00, 
	0x00, 0x00, 0x38, 0x44, 0x44, 0x04, 0x08, 0x10, 0x10, 0x00, 0x10, 0x00, 
	0x00, 0x00, 0x38, 0x44, 0x98, 0xA8, 0xA8, 0xA8, 0xB4, 0x40, 0x3C, 0x00, 
	0x00, 0x00, 0x10, 0x10, 0x28, 0x28, 0x28, 0x38, 0x44, 0x44, 0xEC, 0x00, 
	0x00, 0x00, 0xF8, 0x44, 0x44, 0x78, 0x44, 0x44, 0x44, 0x44, 0xF8, 0x00, 
	0x00, 0x00, 0x3C, 0x44, 0x80, 0x80, 0x80, 0x80, 0x80, 0x44, 0x38, 0x00, 
	0x00, 0x00, 0xF0, 0x48, 0x44, 0x44, 0x44, 0x44, 0x44, 0x48, 0xF0, 0x00, 
	0x00, 0x00, 0xFC, 0x44, 0x40, 0x48, 0x78, 0x48, 0x40, 0x44, 0xFC, 0x00, 
	0x00, 0x00, 0xFC, 0x44, 0x40, 0x48, 0x78, 0x48, 0x40, 0x40, 0xE0, 0x00, 
	0x00, 0x00, 0x38, 0x48, 0x80, 0x80, 0x80, 0x9C, 0x88, 0x48, 0x30, 0x00, 
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
};
unsigned char const num0_9_4x6[60] = {
	0x60, 0x90, 0x90, 0x90, 0x90, 0x60, 0x20, 0x60, 0x20, 0x20, 0x20, 0x70, 0x70, 0x50, 0x10, 0x20, 
	0x40, 0x70, 0x70, 0x50, 0x20, 0x10, 0x50, 0x70, 0x20, 0x60, 0xA0, 0xA0, 0xF0, 0x20, 0x70, 0x40, 
	0x70, 0x10, 0x50, 0x70, 0x60, 0x80, 0xF0, 0x90, 0x90, 0x60, 0x70, 0x10, 0x20, 0x20, 0x20, 0x20, 
	0x60, 0x90, 0x60, 0x90, 0x90, 0x60, 0x60, 0x90, 0x90, 0x60, 0x10, 0x60
};
