475241512/BT_Printer/(commit log)

2015-12-14 the first test ok veriosn
    [BTPrinter_DemoBoard_V1.00.pcb, BTPrinter_DemoBoard_V1.00.sch, BTPrinter_DemoBoard_V1.10.pcb, BTPrinter_DemoBoard_V1.10.sch, BTPrinter_V1.0_PCBA_BOM.xlsx, BTPrinter_V1.10.pcb, BTPrinter_V1.10.sch, Layou1.pcb]
2015-12-18 V1.10 PCB layout ok!
    [BTPrinter_V1.10 PCBA BOM.xlsx, BTPrinter_V1.10.pcb, BTPrinter_V1.10.sch, POS58-printer-main-board-151215.dwg, outline1.dxf]
2015-12-22 update BT816.c,HW sch and pcb update
    [BTPrinter_DemoBoard_V1.10.sch, BTPrinter_V1.10.pcb, BTPrinter_V1.10.sch, BTPrinter_V1.20.pcb, BTPrinter_V1.20.sch]
2015-12-23 add bootloader to project,update usb lib,fix the usb lib bug
    [BTPrinter_V1.20.sch]
2015-12-24 add an ESC/POS instruction:GS P x y; modify bootloader;
2015-12-26 update Lcd.c/h;complete the dispaly BT name+mac and pin in LCD feature;complete the reset BT PIN feature;add two query interface in the BT816.c;
    [AsciiLib_6x12.h, BT816.c, BT816.h, Event.c, KeyScan.c, TP.c, lcd.c]
2015-12-26 update a little bug:when BT is connected,no * display in the lcd
    [lcd.c]
2016-01-07 cancle DotAdjust feature and reduce the speed_tbl,cance the rotating feature,OK Versiongit status!
    [BTPrinter_V1.20 PCBA BOM.xlsx, BTPrinter_V1.20.pcb, BTPrinter_V1.20.sch, layout00.pcb]
